kenneth-tochihara/ae484/README.md

# ae484
Overleaf link: https://www.overleaf.com/4984712844kzgqprcwqkpm
