kenneth-tochihara/ae484/homeworks/homework6/report/homework6.tex

\input{settings.tex}
% NOTES
%  - Double spacing (always fix for figures and tables though)
%  - for tables, remember to make them single spaced using \renewcommand{\arraystretch}{1}
%  - Always pull from GitHub to Overleaf when there are commits to be pulled (Menu > GitHub > PULL)
%  - for REFERENCES, use \cite{<label>} to link the reference.

% % TABLE TEMPLATE
% \begin{table}[H]
%     \begin{center}
%     \setstretch{1} 
%     \caption{\textbf{<caption here>}} \label{table:<label here>}
%     \begin{tabular}{|p{0.3in}|p{1in}|p{1in}|} % set column nums and width
%         \hline \textbf{No.} & \textbf{Item} & \textbf{Weight} \\ \hline % column headers
%         1 & Hot dogs & 2 lbs \\ \hline
%     \end{tabular}
%     \end{center}
% \end{table}

\begin{document}

%%% Title Page
\begin{center}
    {\Large\textbf{AE 484 Homework 6}}\\
    Anshuk Chigullapalli, Max Kaiser, George Petrov, Kenneth Tochihara, Jeffery Zhou\\
\end{center}

\section{Design Changes}

    The team considered the changes suggested by Professor Elliott and modified the design of the aircraft accordingly. The primary changes made to the design are listed below and the updated engineering drawings for the aircraft assembly are provided  \href{https://github.com/ktt3/ae484/tree/main/homeworks/homework6/drawing}{here} on our GitHub.
    
    \begin{enumerate}
        \item The winglets in the previous design had a curved merge into the wing. However, this is difficult in terms of manufacturability. The blend is replaced by a hard corner between the wing and the winglet.
        \item For ease of manufacturing, the elevons are extended to the end of the wing rather than being in the middle
        \item A plywood plate is added between the two wings to provide support for all the components and the motor mount.
        \item The spars are reduced in length because the original lengths were too long
        \item Changes to the design of the motor mount
    \end{enumerate}
    
    Another suggestion that was made was to not use a 3D printed motor mount due to potential shear between the layers of the 3D print, making it a bad material choice. The alternative would be an aluminum motor mount. However, the team decided to continue with the 3D printed mount for weight benefits and faster prototyping. If experimental tests conclude that the 3D printed motor mount fails, the switch to a metal motor mount will be made.

\section{Bill of Materials}

    The bill of materials accounts for all components needed to manufacture the aircraft. When calculating the cost for the wings, it was assumed that each wing required one wing core and one balsa sheet to manufacture. Furthermore, the cost of the 3D prints were determined by the cost of the PLA material extruded to manufacture the component. The total cost of the aircraft based on this table is \$319.27.
    
    \begin{table}[H]
    \centering
    \caption{Bill of Materials} \label{tab:bom}
    \begin{tabular}{|p{1.25in}|p{1.25in}|p{2.75in}|p{.75in}|}
    \hline
    \textbf{Item} & \textbf{Vendor} & \textbf{Model and Part \#} & \textbf{Price (\$)} \\
    \hline
    Front Spar & Goodwinds Composites & 0.5" x 24" Pultruded Carbon Tube,PCT500024 & 17.90   \\ \hline
    Back Spar     & Goodwinds& 0.375" x 24" Pultruded Carbon Tube, PCT375024 & 10.23   \\ \hline
    ESC           & Value Hobby & GForce 40A Brushless ESC, VHB-SC-4494 & 10.00 \\ \hline
    Battery       & Value Hobby & GForce 30C 2200mAh 3S 11.1V LiPo, RFI-LP-1899 & 14.90 \\ \hline
    Motor         & Value Hobby & GForce E480 Brushless Outrunner Motor, LEO-MT-3461 & 17.00   \\ \hline
    Propeller     & Horizon Hobby   & 12x6 3-Blade Pusher, MAS3B12X60R01 & 14.65 \\ \hline
    Receiver      & Horizon Hobby   & AR620 DSMX 6-Channel Sport Receiver, SPMAR620 & 49.99 \\ \hline
    Servos        & Value Hobby & Emax ES08MA II Analog Metal Gear Mirco Servo, VHB-SV-6148, Set of 4 & 17.50 \\ \hline
    Wing Cores & MOHR Composite & N/A & 90.00 \\ \hline
    Balsa Sheet & National Balsa & N/A & 18.00 \\ \hline
    Winglets & DragonPlate & 0 Degree Carbon Fiber Uni Sheet 1/8'' x 6'' x 6'', 2 sets & 55.62 \\ \hline
    Hand Holder & Amazon & Plywood Sheet 12'' x 12'' x 1/8 '' & 12.90 \\ \hline
    Motor Mount & 3D Printed & N/A & 0.44 \\ \hline
    Elevon Actuator Holder & 3D Printed  & N/A & 0.04 \\ \hline
    Trap Door     & 3D Printed  & N/A & 0.10    \\ \hline
    \end{tabular}
    \end{table}
    
\section{Manufacturing Files}
    
    The manufacturing files and drawings for the laser cutter, 3D printer, and CNC foam were generated, and are provided \href{https://github.com/ktt3/ae484/tree/main/homeworks/homework6/manufacturing}{here} on our GitHub.

    \begin{table}[]
        \centering
        \caption{Manufactured Parts}
        \begin{tabular}{|c|c|c|c|}
            \hline
            \textbf{Part} & \textbf{Method} & \textbf{File Name} & \textbf{Weight} \\ \hline
            Winglets & Laser Cut & \verb|flat_winglets.pdf| & N/A \\ \hline
            Hand Holder & Laser Cut & \verb|holder_mid.pdf| & N/A \\ \hline
            Motor Mount & 3D Printed & \verb|motor_mount.stl| & 26 g \\ \hline
            Elevon Mount & 3D Printed & \verb|elevon_mount.stl| & 1 g \\ \hline
            Vial Trap Door & 3D Printed & \verb|trap_door.stl| & 5 g \\ \hline
            Main Wing +Z & CNC Foam & \verb|main_wing_+z.stl| & N/A \\ \hline
            Main Wing -Z & CNC Foam & \verb|main_wing_-z.stl| & N/A \\ \hline
        \end{tabular}
    \end{table}

\section{Table of Contributions}

    \begin{table}[H]
        \centering
        \caption{Table of Contributions}
        \label{tab:contributions}
        \begin{tabular}{|c|c|}
            \hline
            \textbf{Team Member} & \textbf{Contributions}  \\ \hline
            Anshuk Chigullapalli & Authored Design Changes, Generated Drawings \\ \hline
            George Petrov & Executed CAD Changes \\ \hline
            Jeffery Zhou & Co-Authored Bill of Materials \\ \hline
            Kenneth Tochihara & Executed CAD Changes, Generated Manufacturing Files and Drawings \\ \hline
            Max Kaiser & Co-Authored Bill of Materials, Generated Manufacturing Files \\ \hline
        \end{tabular}
    \end{table}
    
\end{document}
