kenneth-tochihara/ae484/homeworks/homework3/kenneth/AE 484 HW 3.pdf

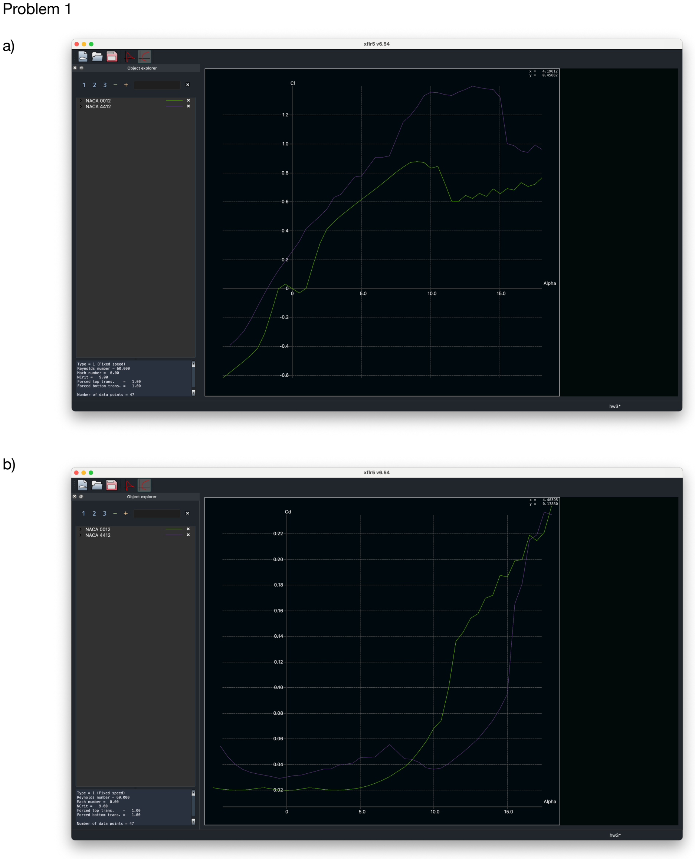
[picture p18: page 1]

Problem 1

a)

b)

c)

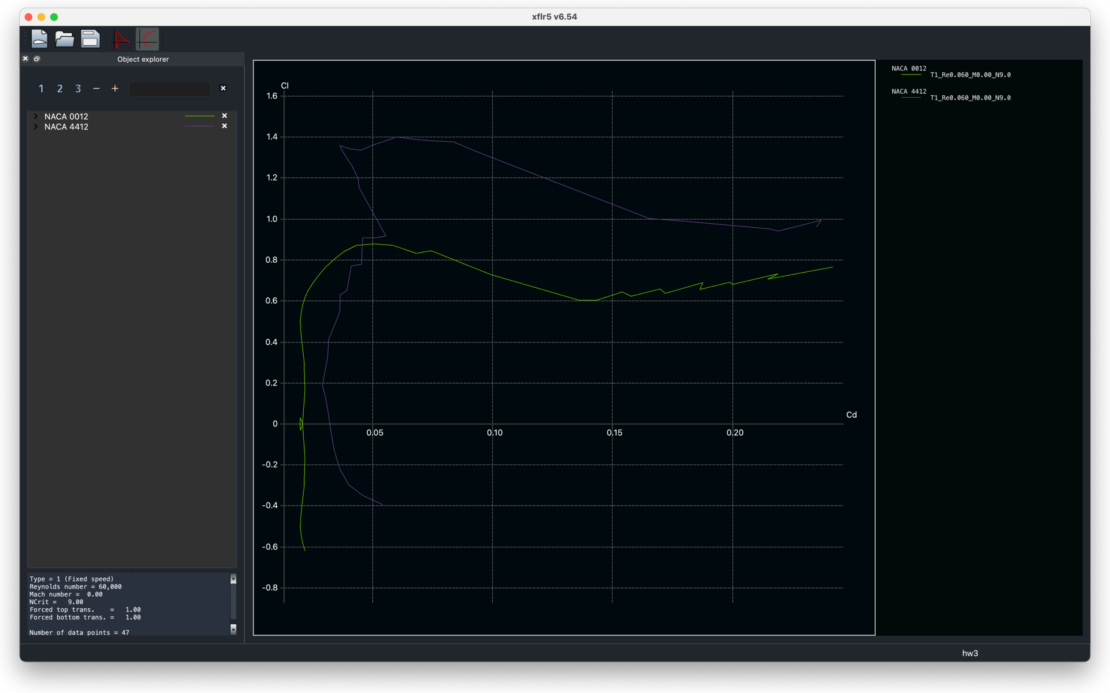
[picture p19: figure]

d) Comparing the two different airfoils, NACA 4412 has more camber than the symmetric NACA 0012. Looking at the Cl vs alpha graph, we can see how the NACA 0012 doesn't generate any lift at 0 degree angle of attack, while the NACA 4412 generates lift. We can all see the stall point delayed with the cambered airfoil and generates more lift with NACA 4412. If cambered is increased, stall is delayed and generates increased lift to a point before other drag affects take over.

Looking further into other properties, we can see that the Cl/Cd is significantly higher as well. This is likely due to the greater pressure differential between the upper and lower boundary of the airfoils. The increased camber generates a increase pressure differential, increasing the lift.

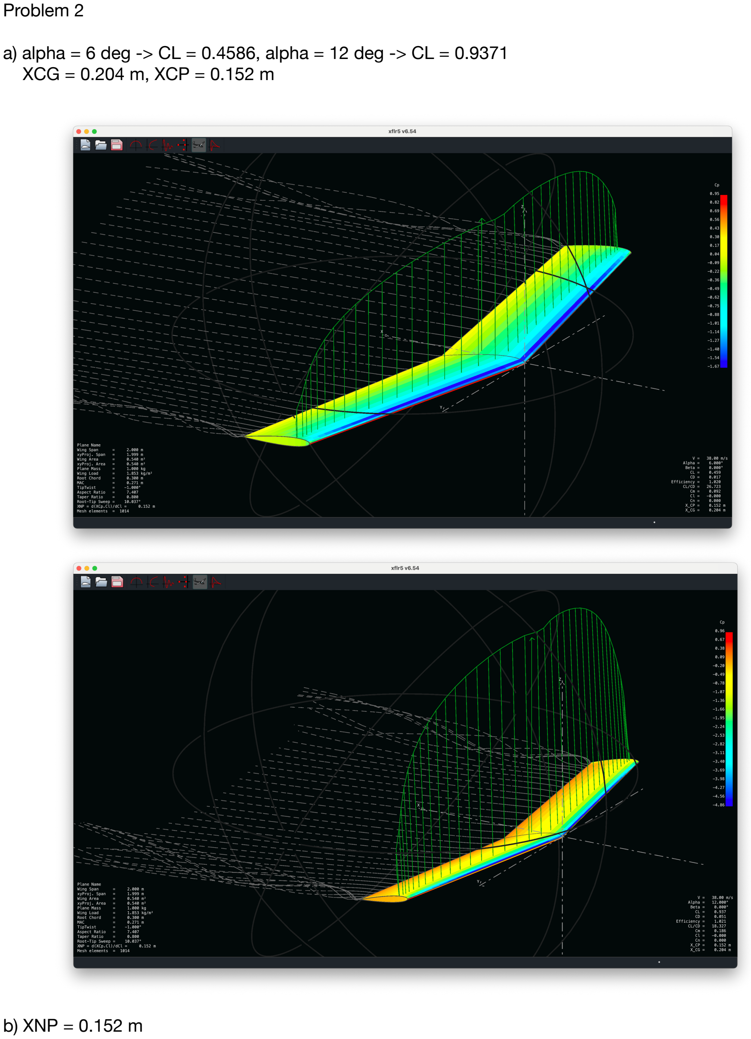
[picture p20: page 3]

a) alpha = 6 deg -> CL = 0.4586, alpha = 12 deg -> CL = 0.9371 XCG = 0.204 m, XCP = 0.152 m
b) XNP = 0.152 m

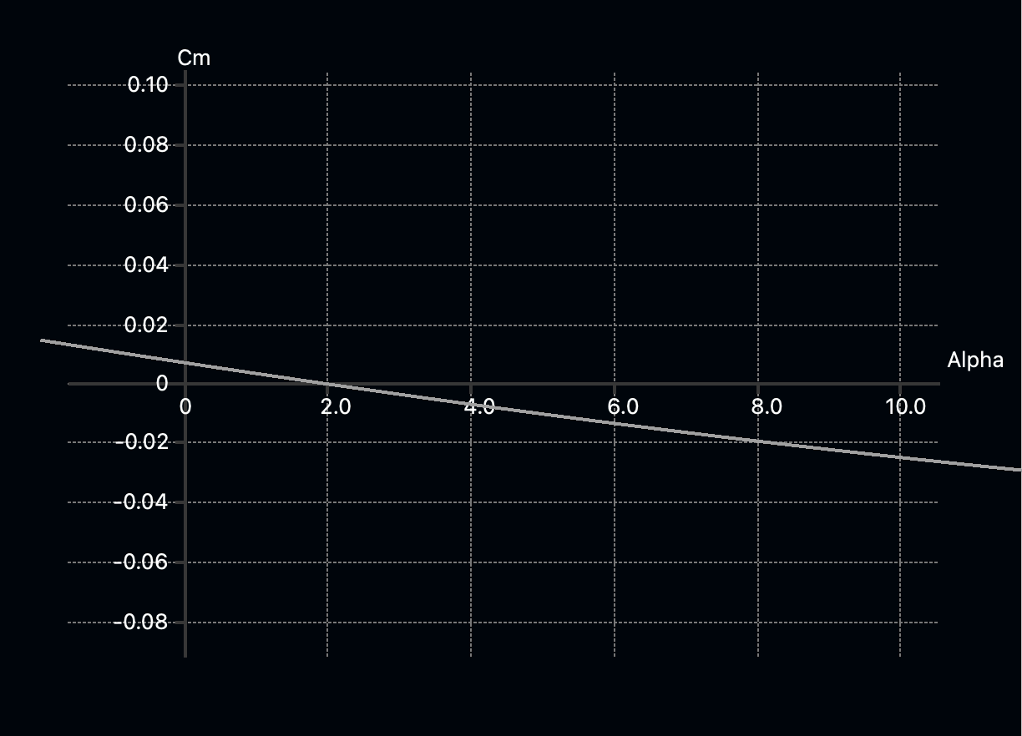
[picture p21: figure]

a) The slope is negative. The trim angle is roughly an angle of attack of 2 deg.
