kenneth-tochihara/ae484/homeworks/homework3/george/report/report.tex

\input{settings}

\title{AE484 Assignment 3}
\author{George Petrov}
\date{February 21, 2022}

\begin{document}

\maketitle
\begin{singlespace}
\section{Symmetric and Cambered Airfoil Analysis}
\textbf{Note:} I have exported all of the polar's data from XLR5 then made python script to plot this data. All of the code will be attached at the bottom of the homework.
\subsection{Part (a)}
Plot of the coefficient of lift across different angles of attack can be seen below. The NACA 0012 airfoil is in blue and the NACA 4412 is in red.
\begin{figure}[H]
        \centering
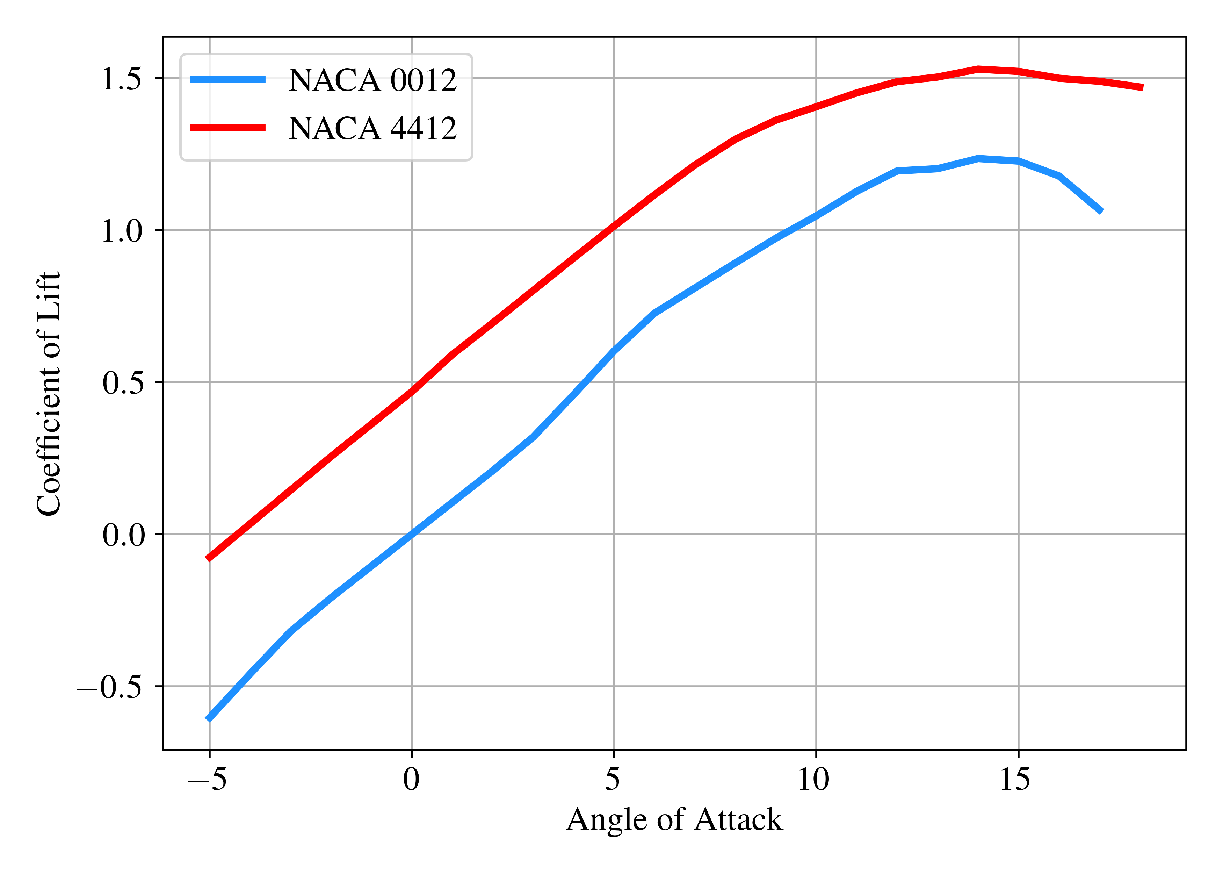
[picture p22: homeworks/homework3/george/plots/problem1_a.png]
        
        \caption{\textbf{$C_l$ vs. $\alpha$}}
        \label{fig:1a}
\end{figure}
\subsection{Part (b)}
Plot of the coefficient of drag across different angles of attack can be seen below.
\begin{figure}[H]
        \centering
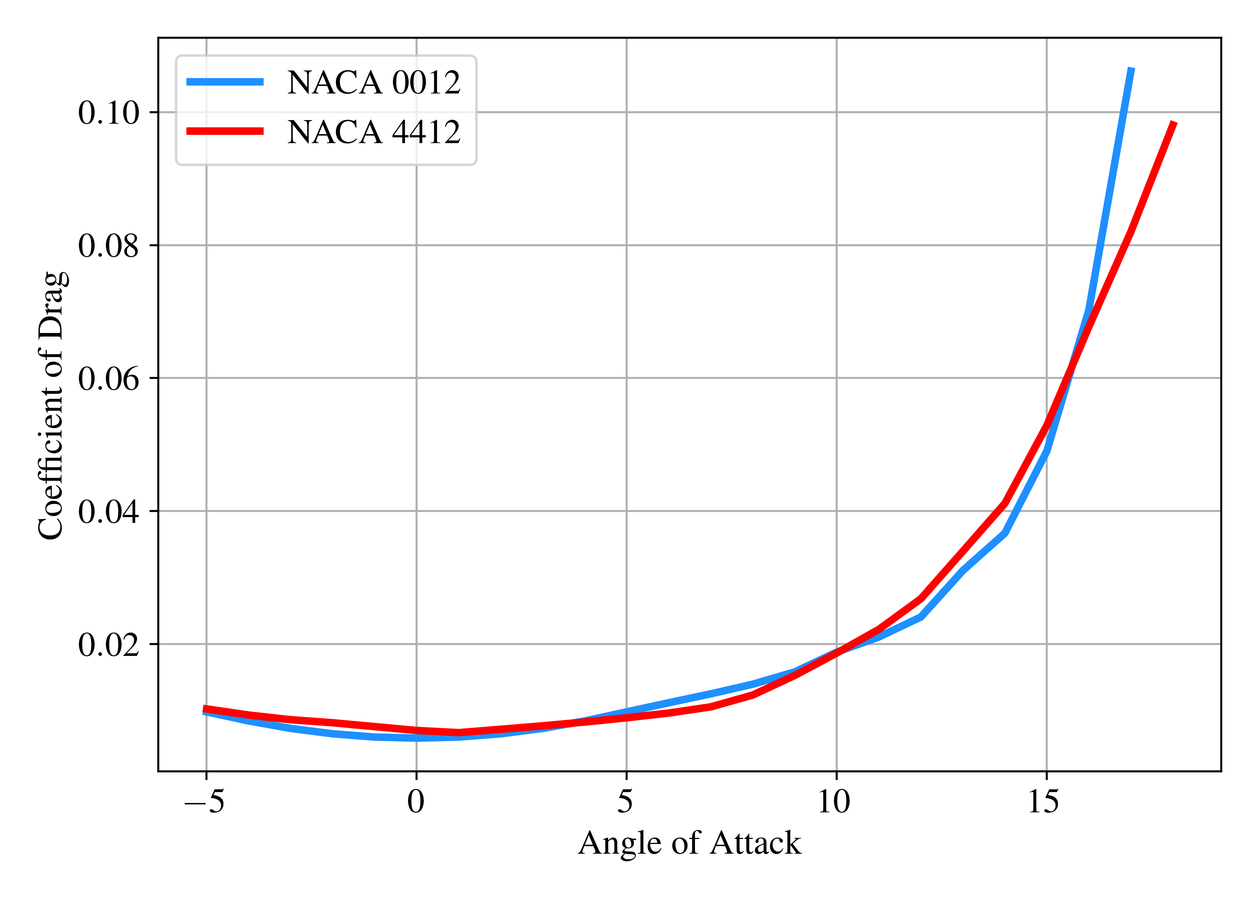
[picture p23: homeworks/homework3/george/plots/problem1_b.png]
        
        \caption{\textbf{$C_d$ vs. $\alpha$}}
        \label{fig:1b}
\end{figure}
\subsection{Part (c)}
Plot of the coefficient of lift vs. coefficient of drag can be seen below.
\begin{figure}[H]
        \centering
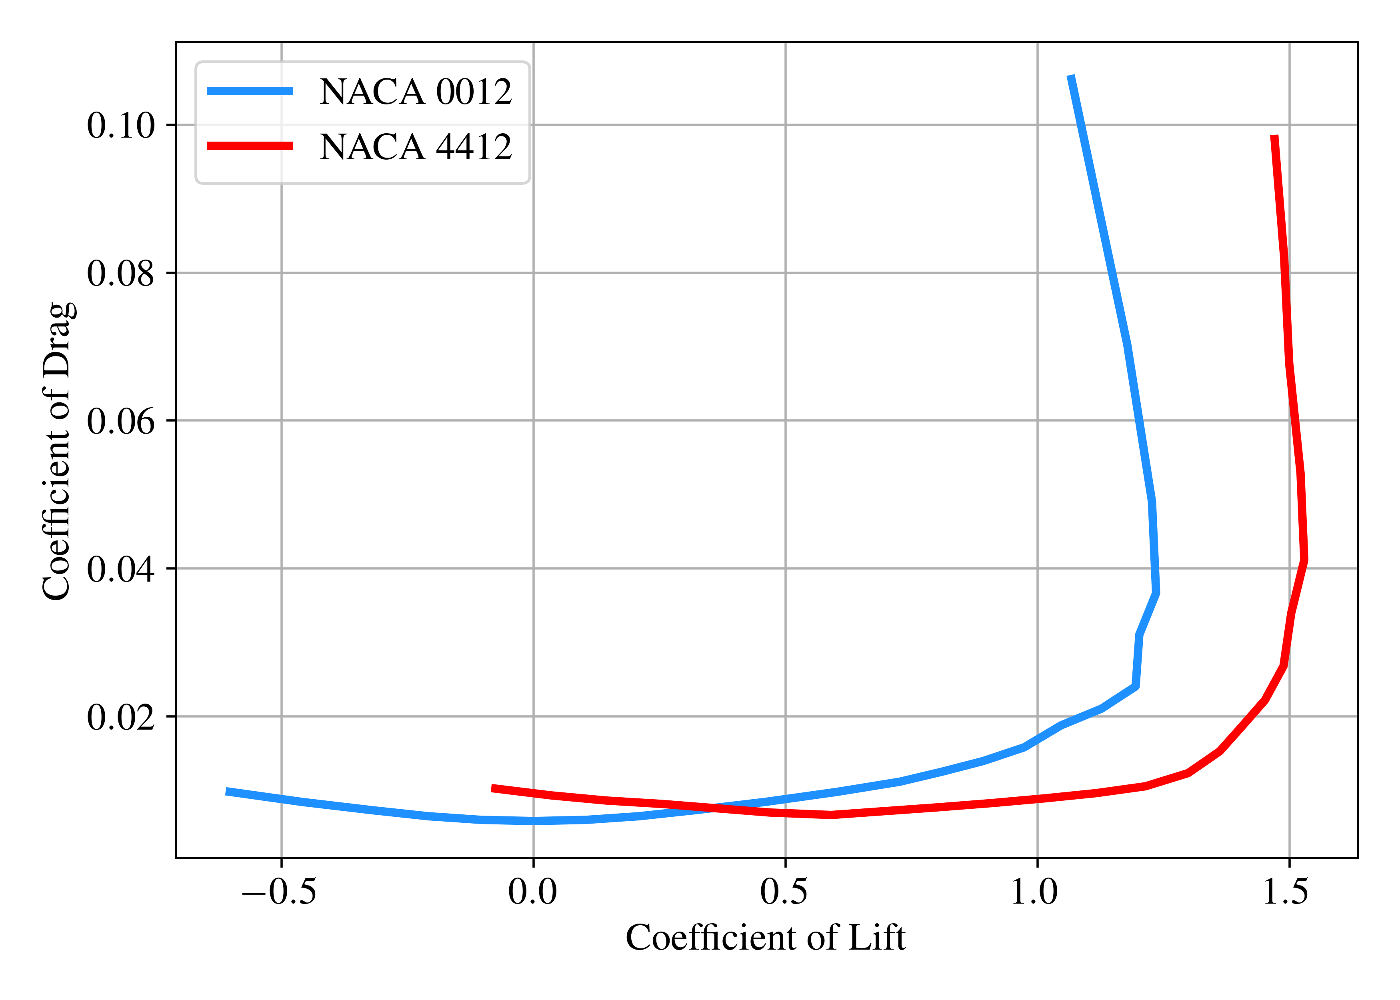
[picture p24: homeworks/homework3/george/plots/problem1_c.png]
        
        \caption{\textbf{$C_l$ vs. $C_d$}}
        \label{fig:1c}
\end{figure}
\subsection{Part (d)}
The different between the NACA 0012 and 4412 is their camber. The 0012 being a symmetric airfoil, while the 4412 being decently cambered. 

The difference can be seen in the Figure \ref{fig:1a}. In this plot, the symmetric airfoil only starts to create lift after the angle of attack is above 0 degrees. While the cambered airfoil creates lift at around -4 degrees. What is also interesting is that they still both stall at around the same angle of attack of 15 degrees. The lift coefficient of the 4412 is always much larger no matter the angle of attack which is expected due to its cambered nature. 

In Figure \ref{fig:1b}, we can see that their drag coefficients are largely the same no matter what the angle of attack is. At the end, the start to separate slightly where the 0012 has slightly larger drag.
For the plot of the coefficient of lift vs coefficient of drag plot, figure \ref{fig:1c}, we can see that the 4412 cambered airfoil is significantly more efficient in creating lift while keeping a similar drag profile to the 0012. 

A cambered wing offers more lift for no loss of drag. Yet, the NACA 0012 is still used in a number of tail stabilizers since it is symmetric.
\section{Finite Wing Analysis}
\subsection{Part (a)}
\subsubsection{i.}
The wings coefficient of lift at 6 and 12 degrees can be seen in the Table \ref{table:2ai} below.

    \begin{table}[H]
    \centering
    \caption{\textbf{$C_L$ at 6$\degree$ and 12$\degree$}} \label{table:2ai}
        \begin{tabular}{|c|c|c|c|c|} % set column nums and width
            \hline \textbf{Angle of Attack ($\alpha$)} & \textbf{Coefficient of Lift ($C_L$)} \\ \hline % column headers
            6$\degree$ & 0.449725 \\ \hline
           12$\degree$ & 0.941413 \\ \hline
        \end{tabular}
        \label{table:2ai}
    \end{table}

\subsubsection{ii.}
Below are sceenshots of the finite wing model with the coefficient of pressure contour, the lift generation, and the streamlines of the flow are shown at both an angle of attack of 6 and 12 degrees.
\begin{figure}[H]
        \centering
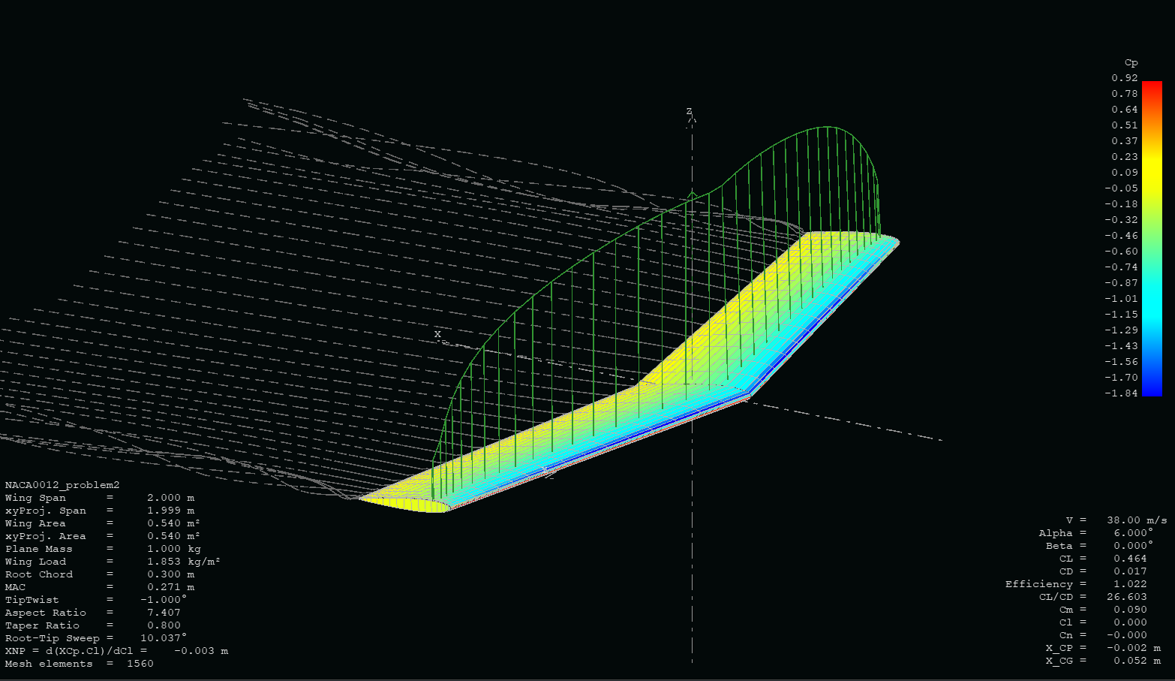
[picture p25: homeworks/homework3/george/plots/problem2_b_6.PNG]
        
        \caption{\textbf{Contour $C_p$ mapping, $C_L$, and Streamlines at 6$\degree$}}
        \label{fig:2bii6}
\end{figure}
\begin{figure}[H]
        \centering
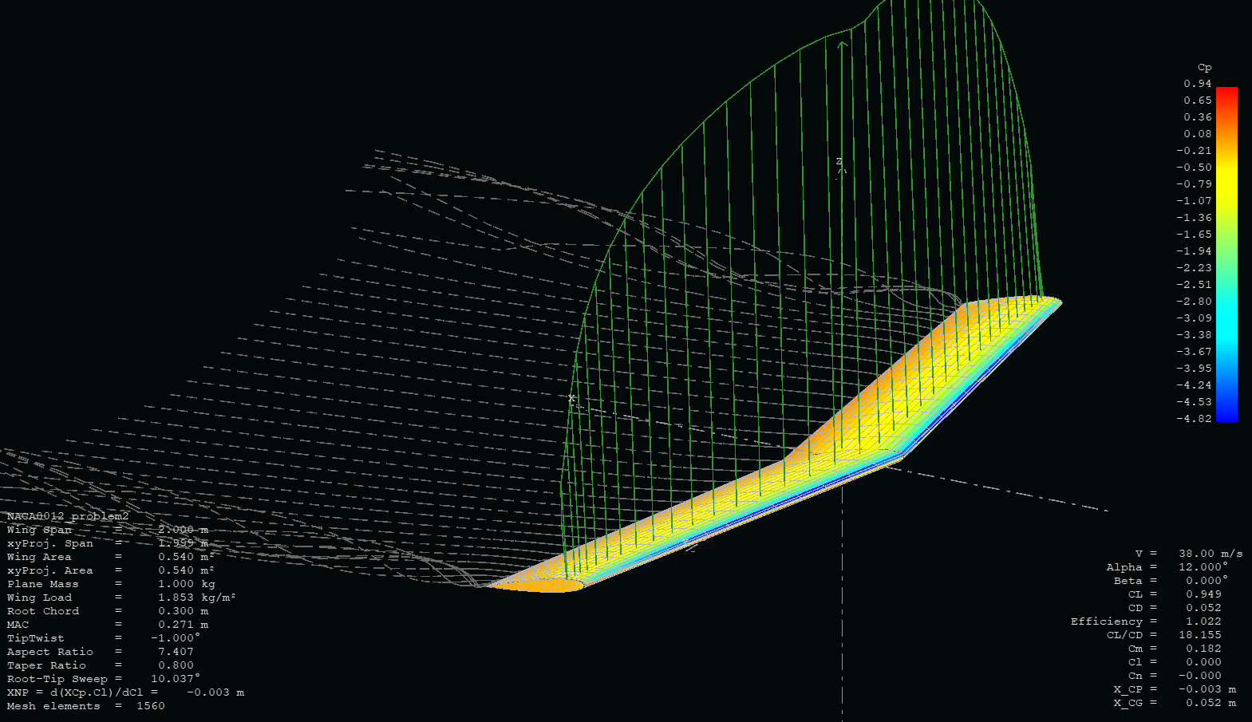
[picture p26: homeworks/homework3/george/plots/problem2_b_12.PNG]
        
        \caption{\textbf{$C_p$ Contour , Lift, and Streamlines at 12$\degree$}}
        \label{fig:2bii12}
\end{figure}
\subsubsection{iii.}
Below, in Table \ref{table:2aiii}, the location of the coefficient of pressure load point and location of the center of gravity is shown for the angles of attack of 6 and 12 degrees. These distances are referenced from the tip of the wing.
\begin{table}[H]
    \begin{center}
        \caption{\textbf{$X_{cp} $ and $X_{cg}$ at 6$\degree$ and 12$\degree$}} \label{table:2aiii}
        \begin{tabular}{|c|c|c|c|c|} % set column nums and width
            \hline \textbf{Angle of Attack ($\alpha$)} & \textbf{$X_{cp}$} & \textbf{$X_{cg}$} \\ \hline % column headers
            6$\degree$ & 0.154 m & .204 m \\ \hline
           12$\degree$ & 0.152 m & .204 m \\ \hline
        \end{tabular}
\end{center}
\end{table}
\subsection{Part (b)}
The neutral point for the wing is found to be \textbf{0.152 m} from the front of the wing.

\section{Flying Wing Analysis}
\subsection{Part (a)}
\subsubsection{i.}
In order to observe whether the slope of the coefficient of moment vs angle of attack is positive or negative, it was plotted.

\begin{figure}[H]
        \centering
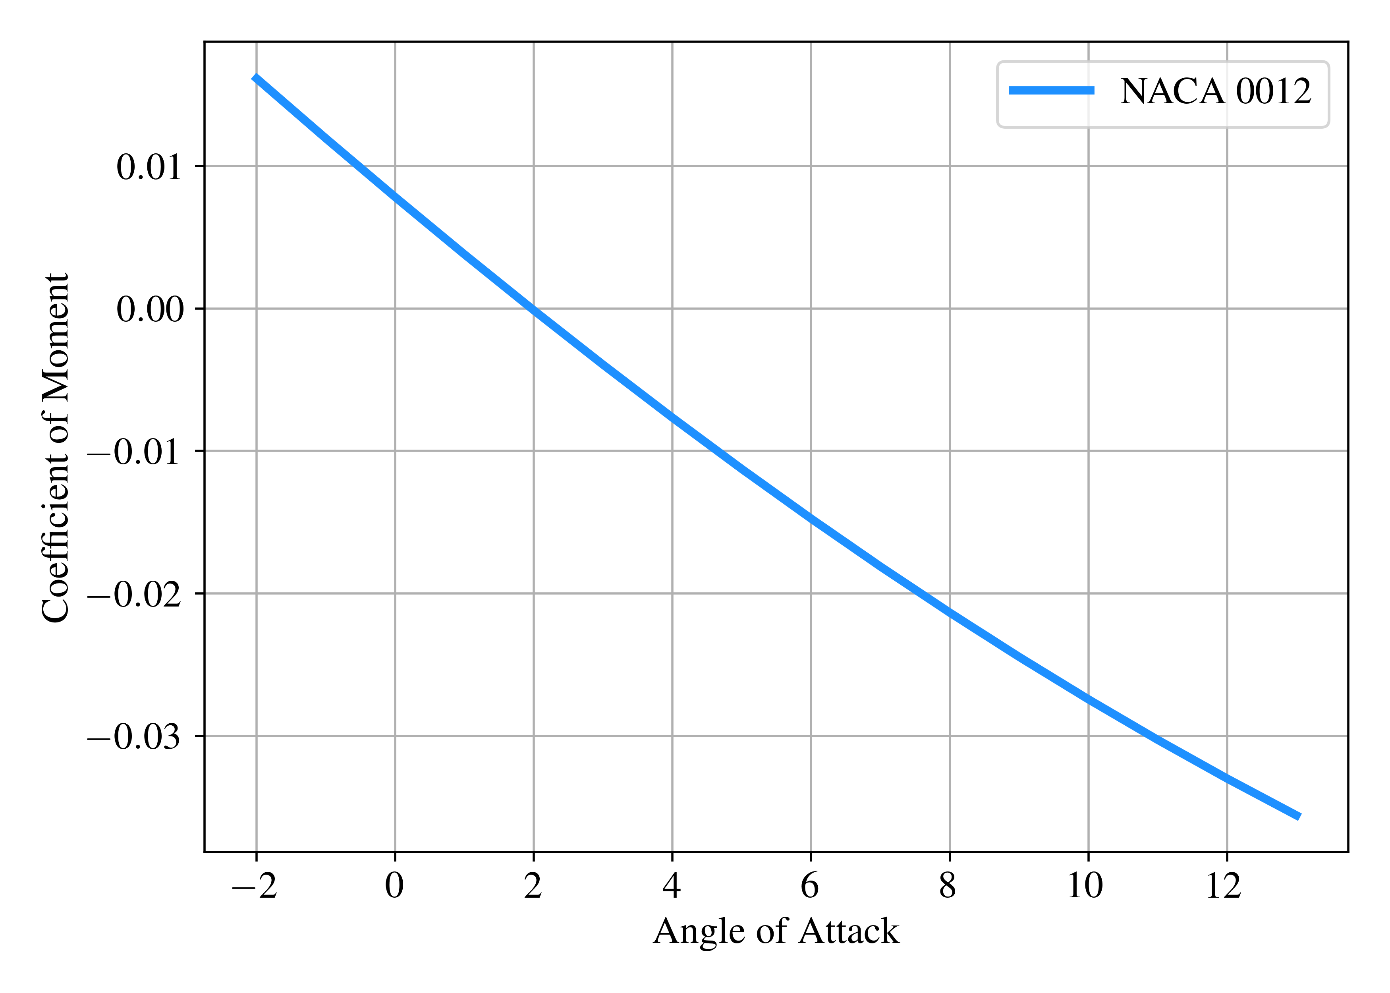
[picture p27: homeworks/homework3/george/plots/problem3_ai.png]
        
        \caption{\textbf{$C_m$ vs. $\alpha$}}
        \label{fig:3ai}
\end{figure}
As we can see above in Figure \ref{fig:3ai}, the slope is slightly negative.
\subsubsection{ii.}
The location where the coefficient of moment is zero is at \textbf{2 degrees} of angle of attack. 

\newpage
\section{\textbf{Raw Data}}
\begin{table}[H]
\caption{\textbf{NACA0012 Airfoil Data}} \label{table:NACA0012_raw}
\begin{tabular}{|l|l|l|l|l|l|l|l|l|l|}
alpha & CL      & CD      & CDp     & Cm      & Top Xtr & Bot Xtr & Cpmin   & Chinge & XCp    \\
-5    & -0.6028 & 0.00981 & 0.00382 & 0.0075  & 0.9939  & 0.1693  & -2.0439 & 0      & 0.2565 \\
-4    & -0.459  & 0.00844 & 0.00305 & -0.0002 & 0.9817  & 0.2999  & -1.486  & 0      & 0.2442 \\
-3    & -0.3196 & 0.00732 & 0.00245 & -0.0062 & 0.9636  & 0.4336  & -1.0483 & 0      & 0.2253 \\
-2    & -0.209  & 0.00651 & 0.00203 & -0.0052 & 0.9202  & 0.5514  & -0.757  & 0      & 0.22   \\
-1    & -0.1046 & 0.00602 & 0.00175 & -0.0026 & 0.8532  & 0.6614  & -0.5548 & 0      & 0.2204 \\
0     & 0       & 0.00586 & 0.00167 & 0       & 0.765   & 0.765   & -0.4147 & 0      & 0.448  \\
1     & 0.1046  & 0.00602 & 0.00175 & 0.0026  & 0.6614  & 0.8532  & -0.5548 & 0      & 0.2204 \\
2     & 0.209   & 0.00651 & 0.00203 & 0.0052  & 0.5514  & 0.9202  & -0.757  & 0      & 0.22   \\
3     & 0.3196  & 0.00732 & 0.00245 & 0.0062  & 0.4336  & 0.9636  & -1.0483 & 0      & 0.2253 \\
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
\end{tabular}
\end{sidewaystable}
\newpage
\section{\textbf{Code}}
    \lstinputlisting[language=python, caption=\bfseries code.py, label=lst:code]{homeworks/homework3/george/code/code.py}
\end{singlespace}
\end{document}
