kenneth-tochihara/ae484/homeworks/homework2/anshuk/HW2_Camera_Render.png

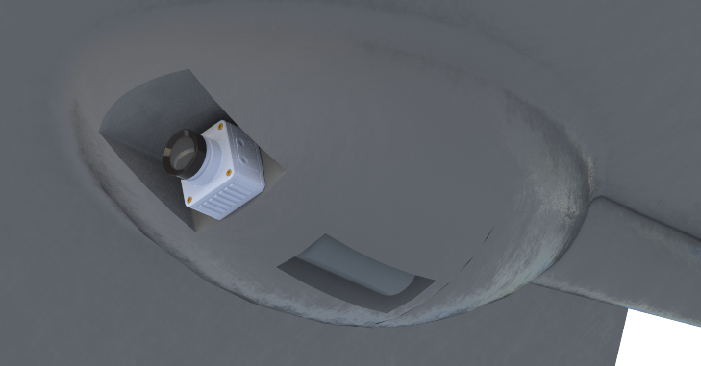
homeworks/homework2/anshuk/HW2_Camera_Render.png
