kenneth-tochihara/ae484/homeworks/homework2/anshuk/HW2_IsoView.png

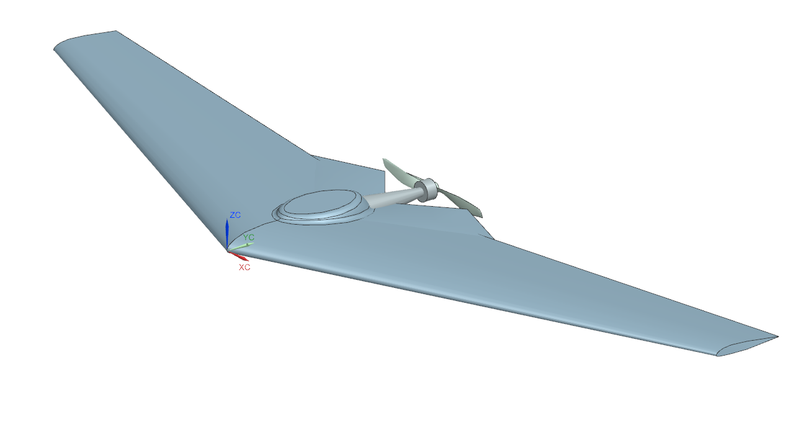
homeworks/homework2/anshuk/HW2_IsoView.png
