kenneth-tochihara/ae484/homeworks/homework2/anshuk/HW2_Top_Render.png

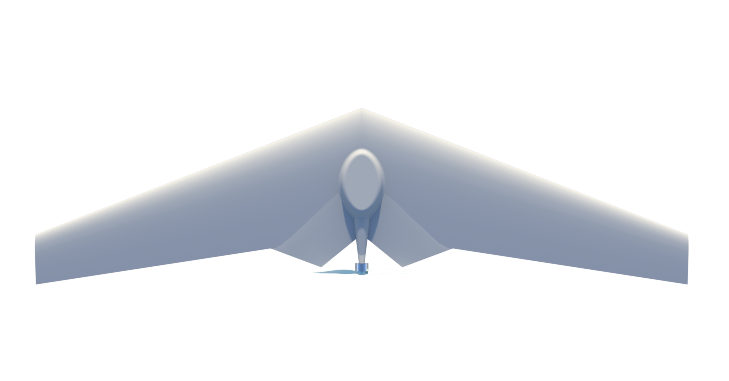
homeworks/homework2/anshuk/HW2_Top_Render.png
