kenneth-tochihara/ae484/homeworks/homework6/cad/exploded.png

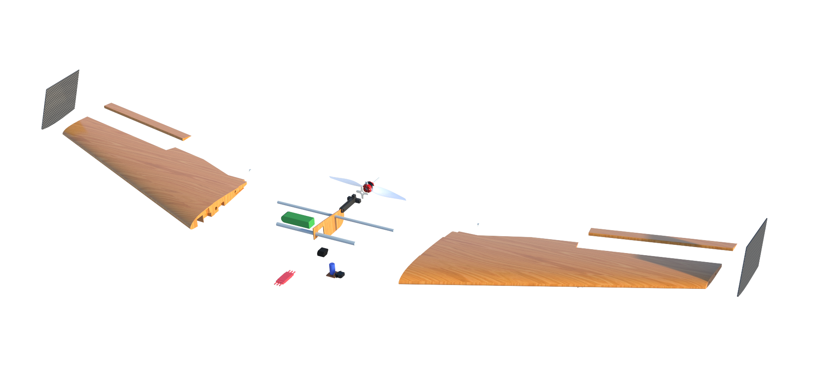
homeworks/homework6/cad/exploded.png
