kenneth-tochihara/ae484/homeworks/homework6/cad/motor/Turnigy Motor 1.JPG

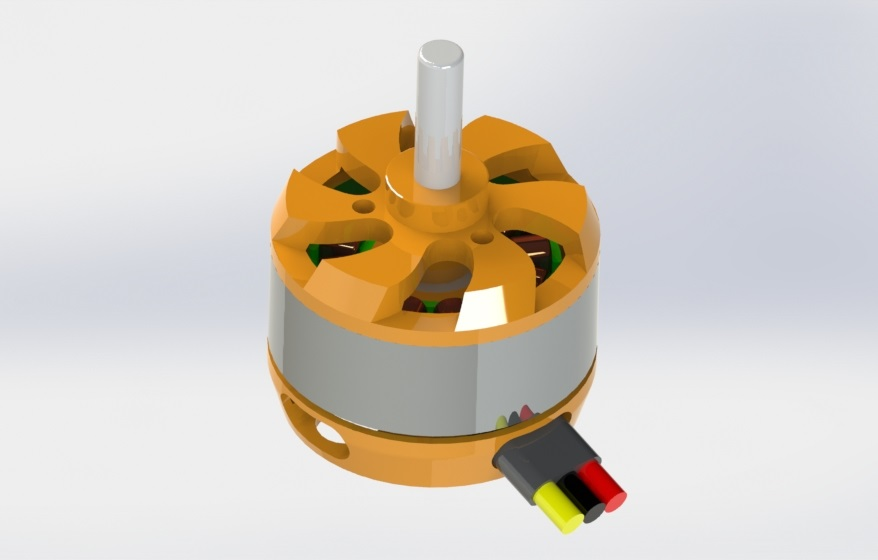
homeworks/homework6/cad/motor/Turnigy Motor 1.JPG
