kenneth-tochihara/ae484/homeworks/homework6/cad/underview.png

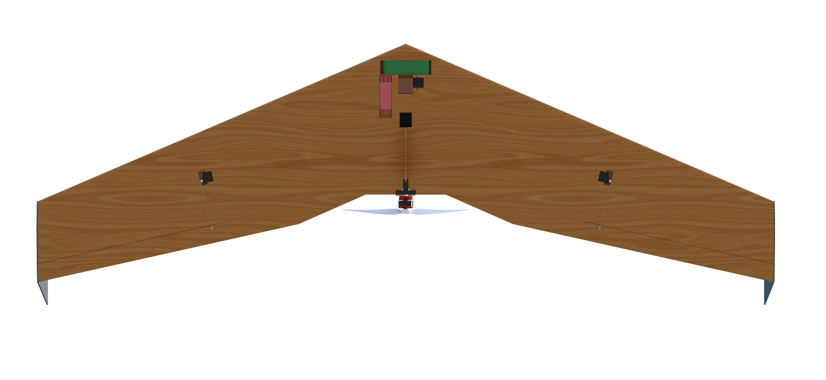
homeworks/homework6/cad/underview.png
