kenneth-tochihara/ae484/homeworks/homework6/manufacturing/main_wing_+z.stl

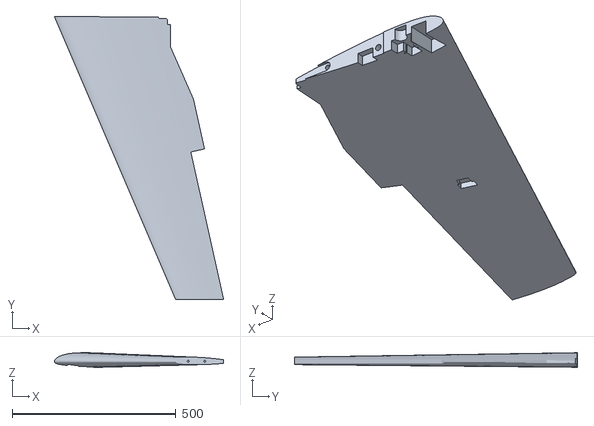
[picture p34: CAD file, 2022-04-05]
homeworks/homework6/manufacturing/main_wing_+z.stl
516.9 x 863.6 x 44.6
