kenneth-tochihara/ae484/homeworks/homework6/cad/elevon_actuators/Connector_short.SLDPRT

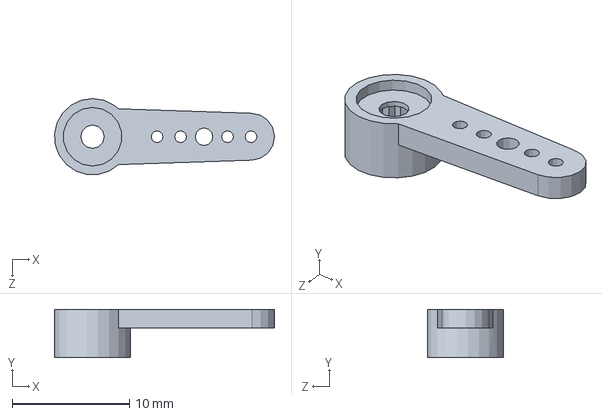
[picture p35: CAD file, 2022-03-02]
homeworks/homework6/cad/elevon_actuators/Connector_short.SLDPRT
18.7 x 4.10 x 6.46 mm
