kenneth-tochihara/ae484/homeworks/homework6/cad/motor/Turnigy Motor.STEP

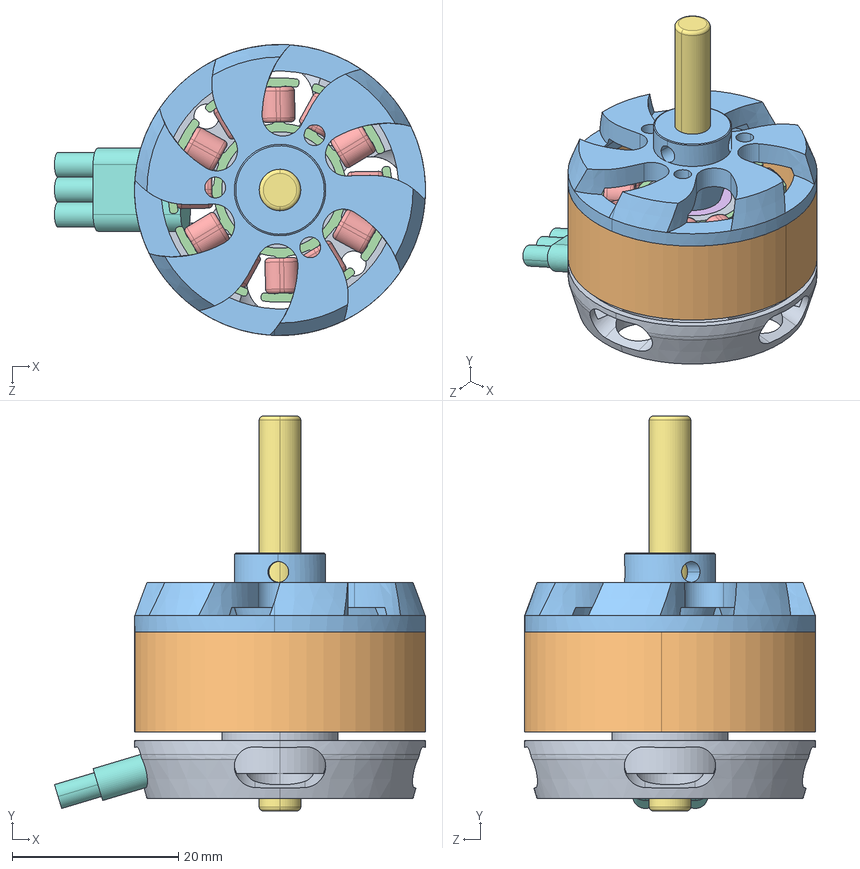
[picture p36: CAD file, 2022-02-26]
homeworks/homework6/cad/motor/Turnigy Motor.STEP
44.6 x 47.5 x 35.0 mm
Bottom Shell
Middle Shell
Top Shell
Inner Coil Rack
Coil x 12
Inner Bearing
Shaft
Wires
