kenneth-tochihara/ae484/homeworks/homework6/manufacturing/flat_winglets_+z_.stl

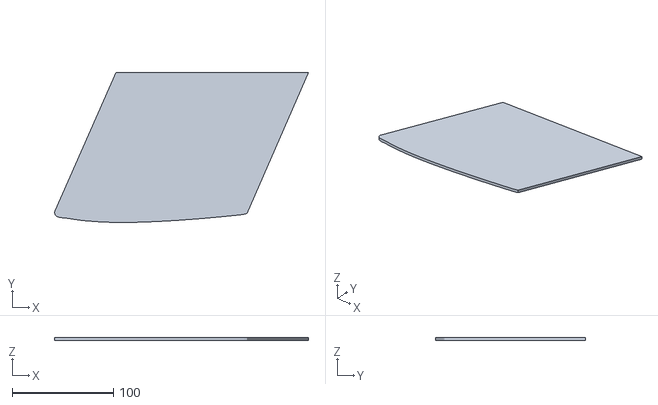
[picture p37: CAD file, 2022-05-03]
homeworks/homework6/manufacturing/flat_winglets_+z_.stl
251.3 x 148.3 x 3.18
