kenneth-tochihara/ae484/homeworks/homework6/manufacturing/motor_mount.stl

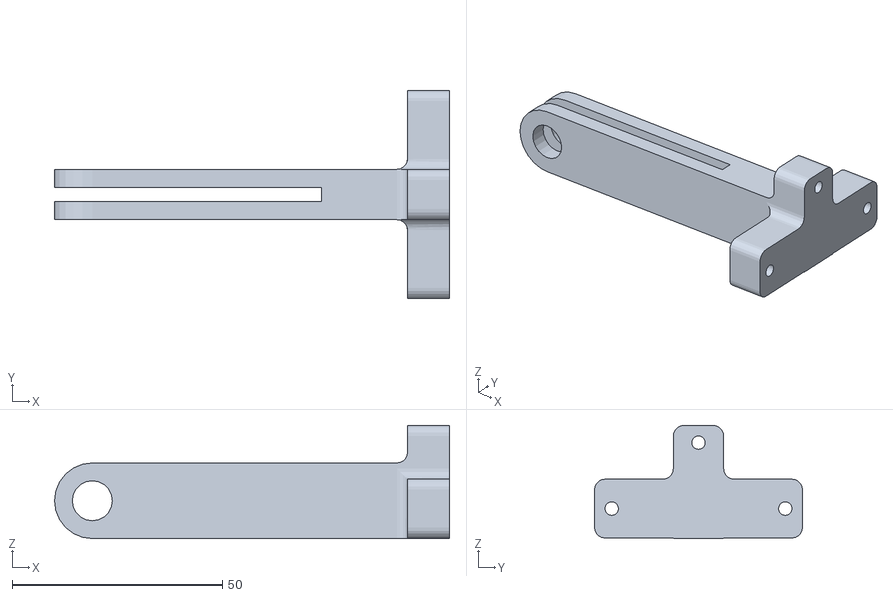
[picture p38: CAD file, 2022-04-05]
homeworks/homework6/manufacturing/motor_mount.stl
94.0 x 49.5 x 26.9
