kenneth-tochihara/ae484/homeworks/homework6/manufacturing/elevon_mount.stl

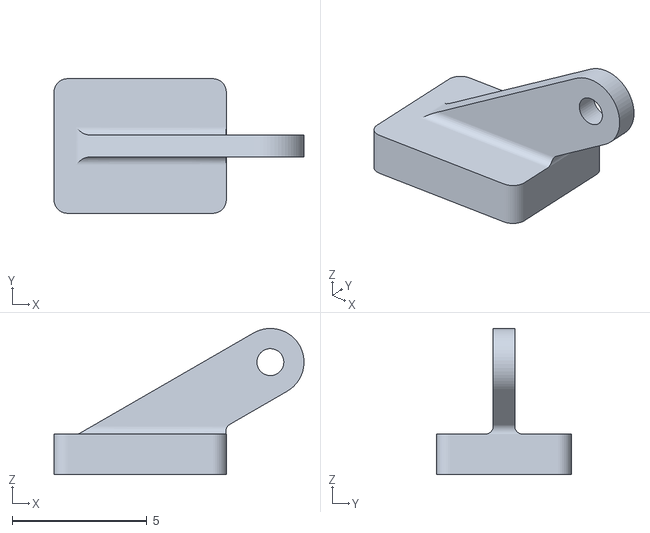
[picture p39: CAD file, 2022-04-05]
homeworks/homework6/manufacturing/elevon_mount.stl
9.28 x 5.00 x 5.43
