kenneth-tochihara/ae484/homeworks/homework6/manufacturing/trap_door.stl

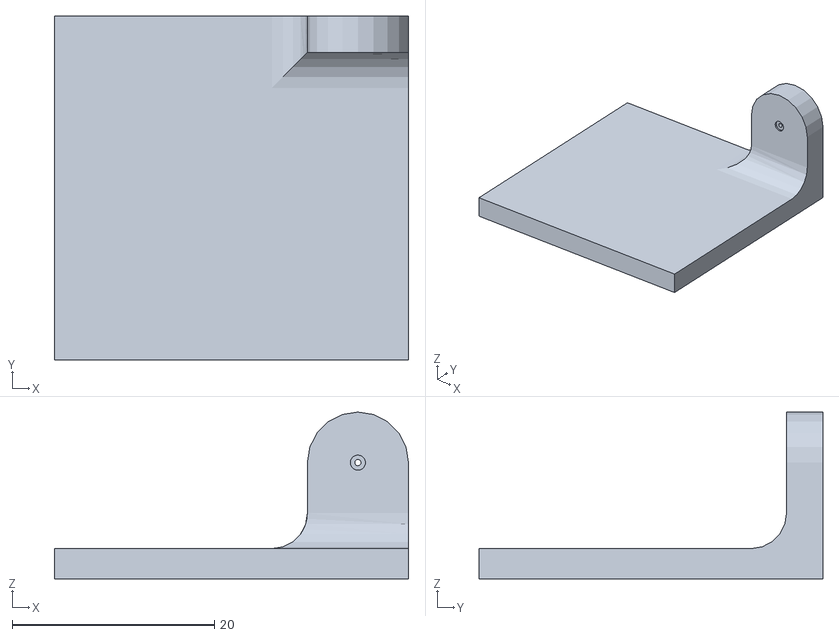
[picture p40: CAD file, 2022-04-05]
homeworks/homework6/manufacturing/trap_door.stl
35.0 x 34.0 x 16.5
