kenneth-tochihara/ae484/(list of files, cad)

Other CAD files:
homeworks/homework2/anshuk/full_assembly.prt
homeworks/homework2/anshuk/main_body.prt
homeworks/homework2/anshuk/motor.prt
homeworks/homework2/anshuk/motor_assembly.prt
homeworks/homework2/anshuk/payload.prt
homeworks/homework2/george/CAD/vehicle_concept_george.prt
homeworks/homework2/george/CAD/vehicle_concept_george_2.prt
homeworks/homework2/george/CAD/vehicle_concept_george_assy.prt
homeworks/homework2/george/CAD/vehicle_concept_george_controlsurfaces.prt
homeworks/homework2/george/CAD/vehicle_concept_george_controlsurfaces2.prt
homeworks/homework2/george/CAD/vehicle_concept_george_props.prt
homeworks/homework2/george/CAD/vehicle_concept_george_wings.prt
homeworks/homework2/kenneth/4mm shaft spinner_id31_step.prt
homeworks/homework2/kenneth/APC 12x6 EP Prop_sldprt.prt
homeworks/homework2/kenneth/CirPattern2_sldprt.prt
homeworks/homework2/kenneth/Cut-Revolve1_sldprt.prt
homeworks/homework2/kenneth/E-Flite Park 480.prt
homeworks/homework2/kenneth/E-Flite Park 480_id91_step.prt
homeworks/homework2/kenneth/Surface-Fill3_sldprt.prt
homeworks/homework2/kenneth/aircraft.prt
homeworks/homework2/kenneth/fuselage.prt
homeworks/homework2/kenneth/vertical_stabilizer.prt
homeworks/homework2/kenneth/wing.prt
homeworks/homework6/cad/Emax ES08A_sldprt.prt
homeworks/homework6/cad/GForce_Brushless_ESC.prt
homeworks/homework6/cad/LiPo_battery.prt
homeworks/homework6/cad/Vial Assembly/assembly_vial_door.prt
homeworks/homework6/cad/Vial Assembly/trap_door.prt
homeworks/homework6/cad/aircraft_assembly.prt
homeworks/homework6/cad/aircraft_assembly_component_locations.prt
homeworks/homework6/cad/elevon_actuators/Connector_short_sldprt.prt
homeworks/homework6/cad/elevon_actuators/Emax ES08A_sldprt.prt
homeworks/homework6/cad/elevon_actuators/aircraft_assembly_manufacturing.prt
homeworks/homework6/cad/elevon_actuators/elecon_holder_left.prt
homeworks/homework6/cad/elevon_actuators/elevon_bar.prt
homeworks/homework6/cad/elevon_actuators/elevon_holder_left.prt
homeworks/homework6/cad/elevon_actuators/elevon_holder_right.prt
homeworks/homework6/cad/elevon_actuators/elevon_left.prt
homeworks/homework6/cad/elevon_actuators/elevon_refernce.prt
homeworks/homework6/cad/elevon_actuators/elevon_right.prt
homeworks/homework6/cad/elevon_actuators/spar_24in.prt
homeworks/homework6/cad/elevon_actuators/spar_36in.prt
homeworks/homework6/cad/hand_holders.prt
homeworks/homework6/cad/motor/Bottom Shell.prt
homeworks/homework6/cad/motor/Coil.prt
homeworks/homework6/cad/motor/Inner Bearing.prt
homeworks/homework6/cad/motor/Inner Coil Rack.prt
homeworks/homework6/cad/motor/Middle Shell.prt
homeworks/homework6/cad/motor/Park 480 Mount_id47_step.prt
homeworks/homework6/cad/motor/Shaft.prt
homeworks/homework6/cad/motor/Top Shell.prt
homeworks/homework6/cad/motor/Turnigy Motor_step.prt
homeworks/homework6/cad/motor/Wires.prt
homeworks/homework6/cad/motor/countersunk flat head cross recess screw_din_ISO 7046-1 - M3 x 6 - Z --- 6N_id63_step.prt
homeworks/homework6/cad/motor/propeller/CirPattern2_sldprt.prt
homeworks/homework6/cad/motor/propeller/Cut-Revolve1_sldprt.prt
homeworks/homework6/cad/motor/propeller/Surface-Fill3_sldprt.prt
homeworks/homework6/cad/motor/propeller/propeller.prt
homeworks/homework6/cad/payload_vial.prt
homeworks/homework6/cad/spar motor connector/spar_motor_connecter.prt
homeworks/homework6/cad/spektrum_ar620_reciever.prt
homeworks/homework6/cad/wing/elevon_+z.prt
homeworks/homework6/cad/wing/elevon_-z.prt
homeworks/homework6/cad/wing/flat_winglets_+z_.prt
homeworks/homework6/cad/wing/flat_winglets_-z.prt
homeworks/homework6/cad/wing/holder_mid_.prt
homeworks/homework6/cad/wing/main_wing.prt
homeworks/homework6/cad/wing/main_wing_+z.prt
homeworks/homework6/cad/wing/main_wing_-z.prt
homeworks/homework6/cad/wing/wing.prt
homeworks/homework6/cad/wing/winglets_+z.prt
homeworks/homework6/cad/wing/winglets_-z.prt
homeworks/homework6/cad/winglet_dowel.prt
homeworks/homework6/manufacturing/flat_winglets_-z.stl
homeworks/homework6/manufacturing/main_wing_-z.stl
