kenneth-tochihara/ae484/homeworks/homework6/manufacturing/holder_mid.pdf

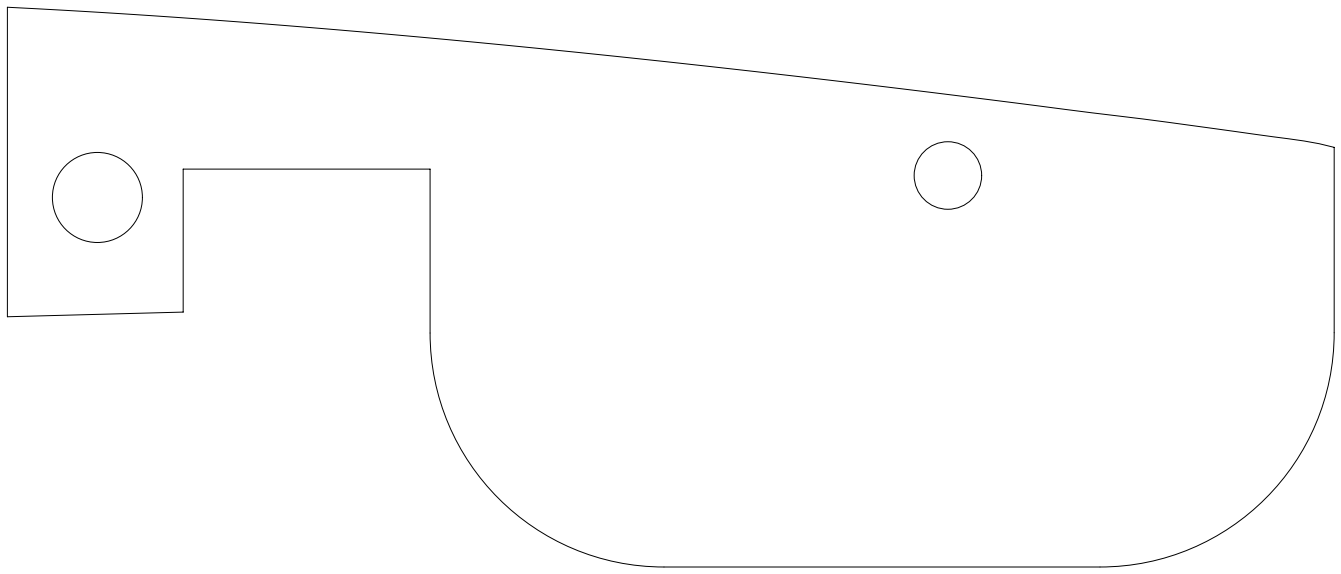
[picture p41: figure]
