kenneth-tochihara/ae484/homeworks/homework4/report/Figure/aircraft_assembly.png

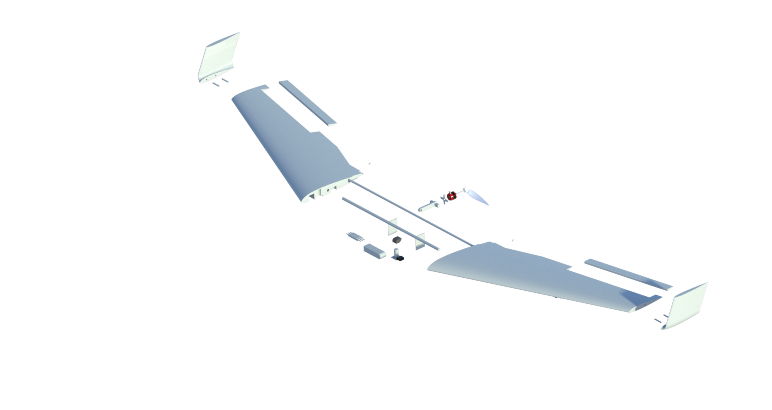
homeworks/homework4/report/Figure/aircraft_assembly.png
