kenneth-tochihara/ae484/homeworks/homework4/report/Figure/aircraft_assembly_1.png

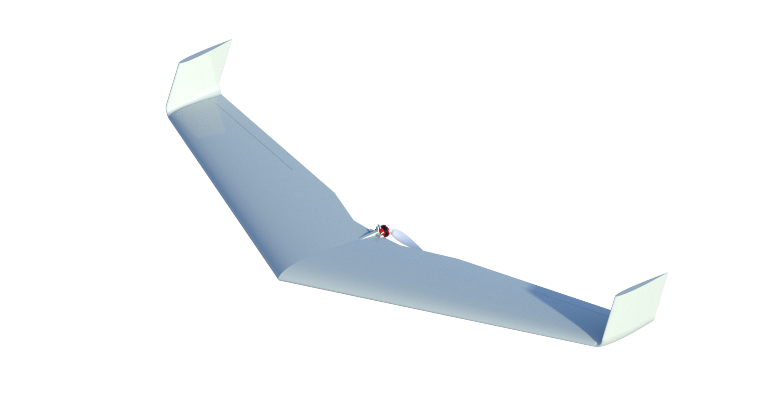
homeworks/homework4/report/Figure/aircraft_assembly_1.png
