kenneth-tochihara/ae484/homeworks/homework4/report/Figure/aircraft_assembly_component_locations.tif

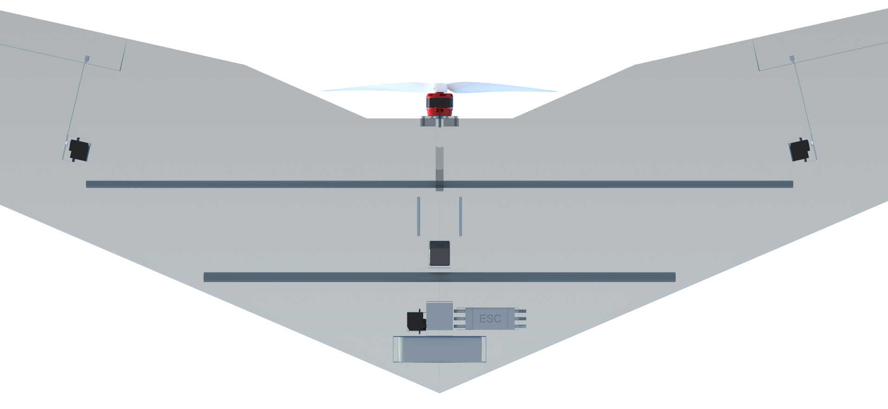
homeworks/homework4/report/Figure/aircraft_assembly_component_locations.tif
