kenneth-tochihara/ae484/homeworks/homework4/report/Figure/aircraft_assembly_underbelly.png

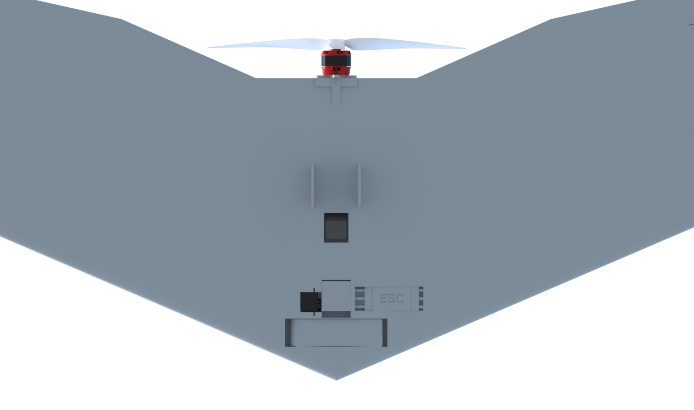
homeworks/homework4/report/Figure/aircraft_assembly_underbelly.png
