kenneth-tochihara/ae484/homeworks/homework4/report/Figure/aircraft_assembly_underbelly.tif

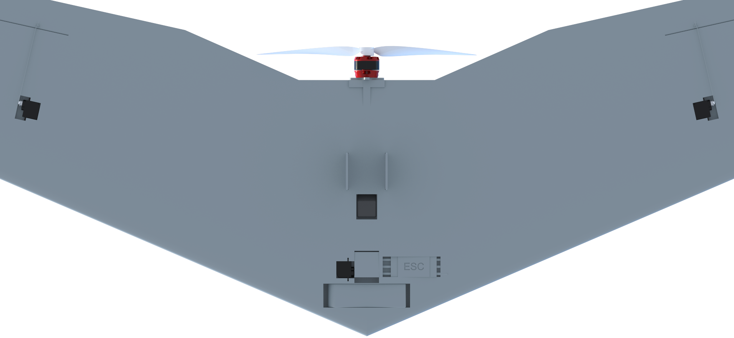
homeworks/homework4/report/Figure/aircraft_assembly_underbelly.tif
