kenneth-tochihara/ae484/homeworks/homework6/cad/aircraft_assembly.png

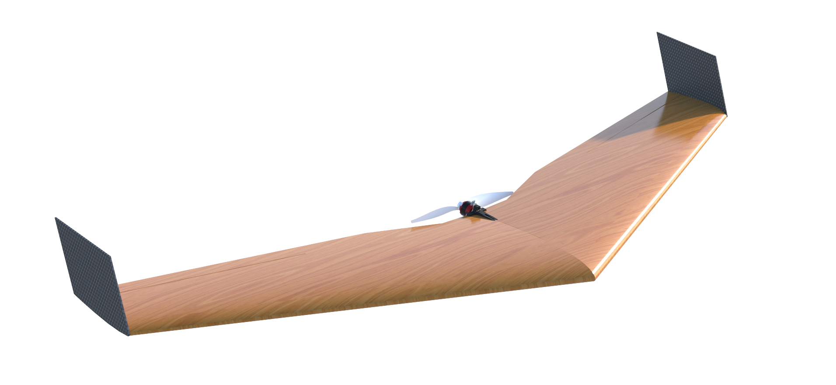
homeworks/homework6/cad/aircraft_assembly.png
