kenneth-tochihara/ae484/homeworks/homework6/manufacturing/main_wing_-z_drawing.pdf

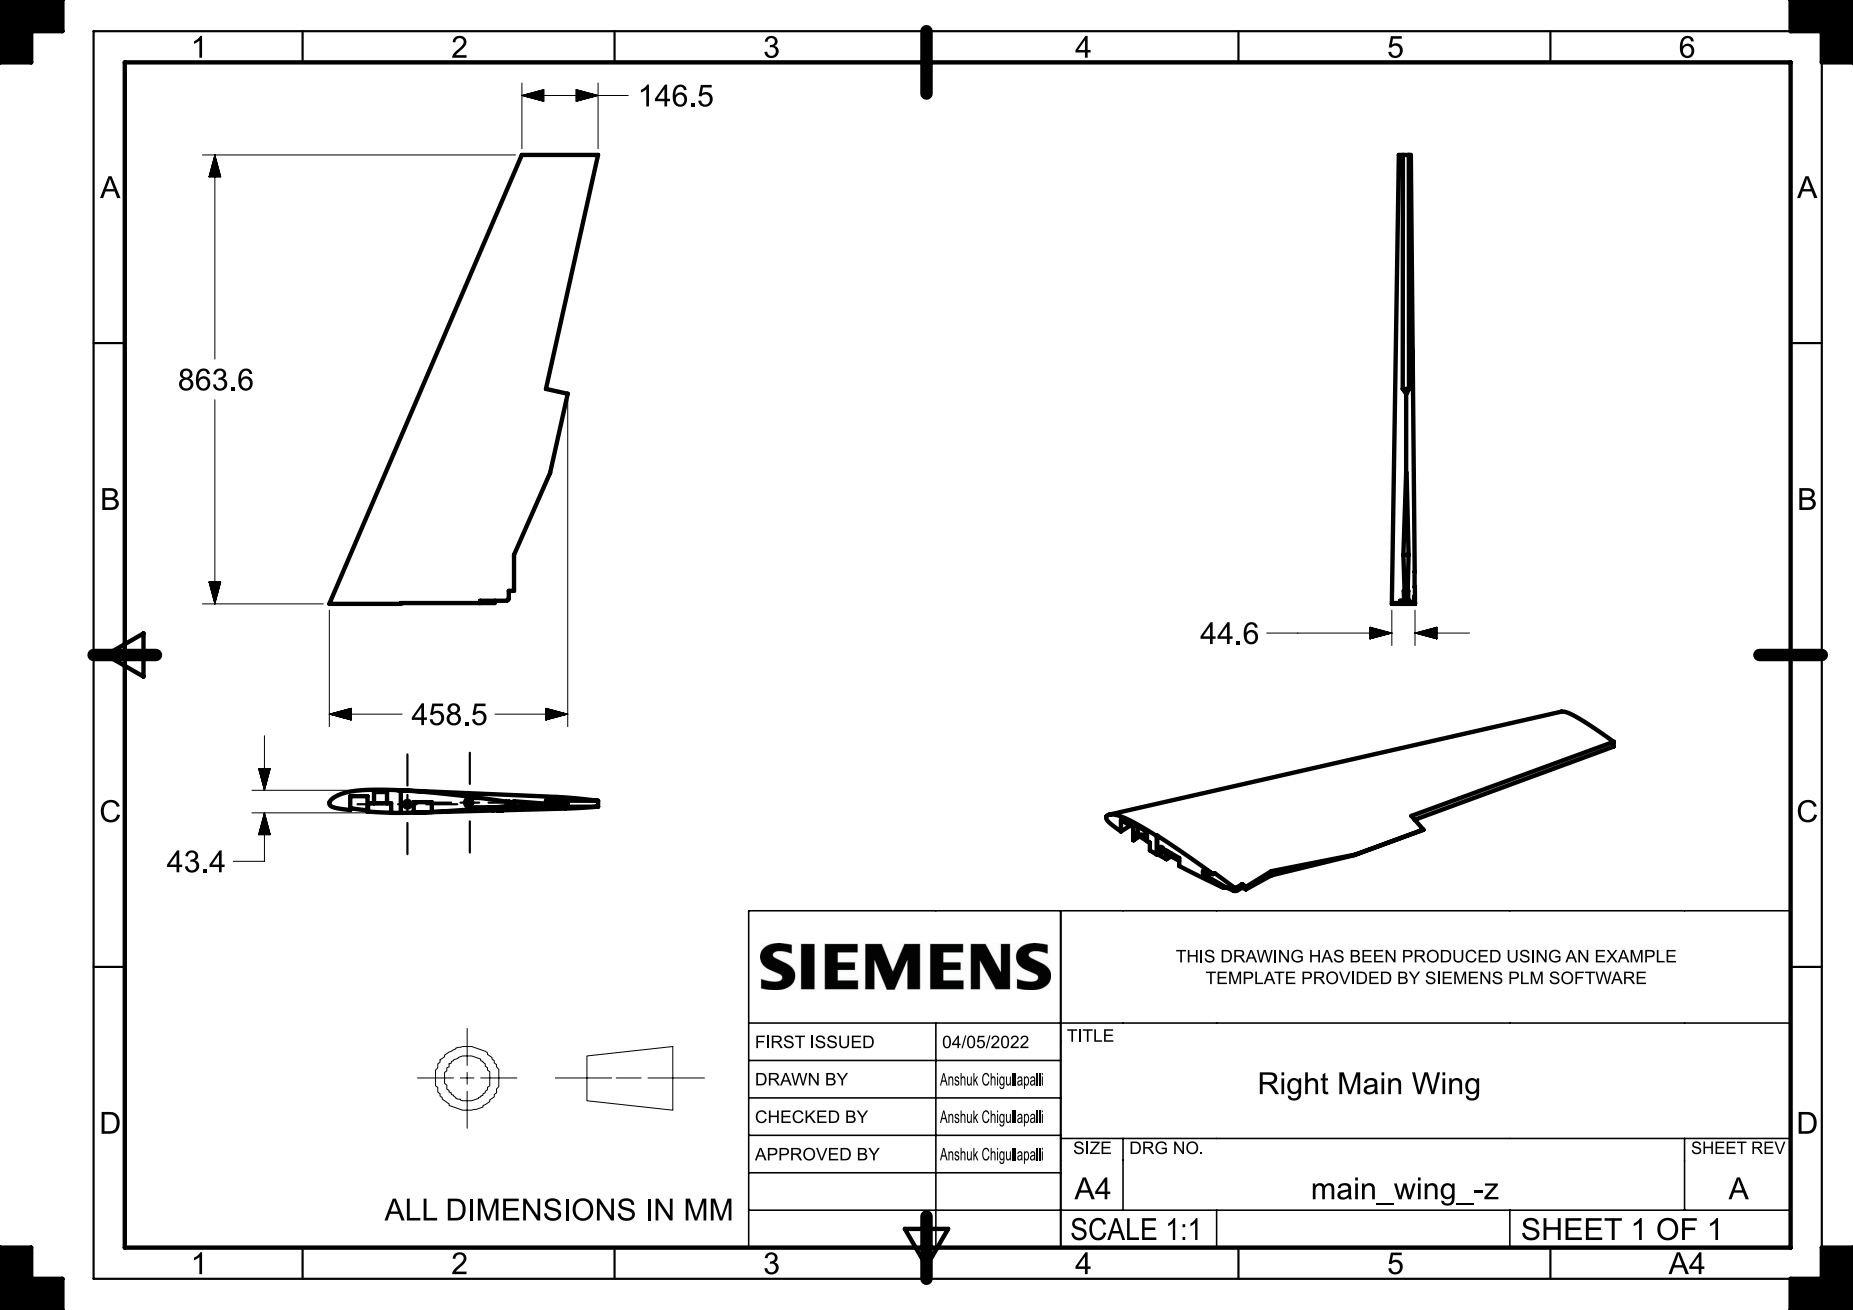
[picture p61: page 1]
