kenneth-tochihara/ae484/homeworks/homework6/drawings/assembly_dimensions.pdf

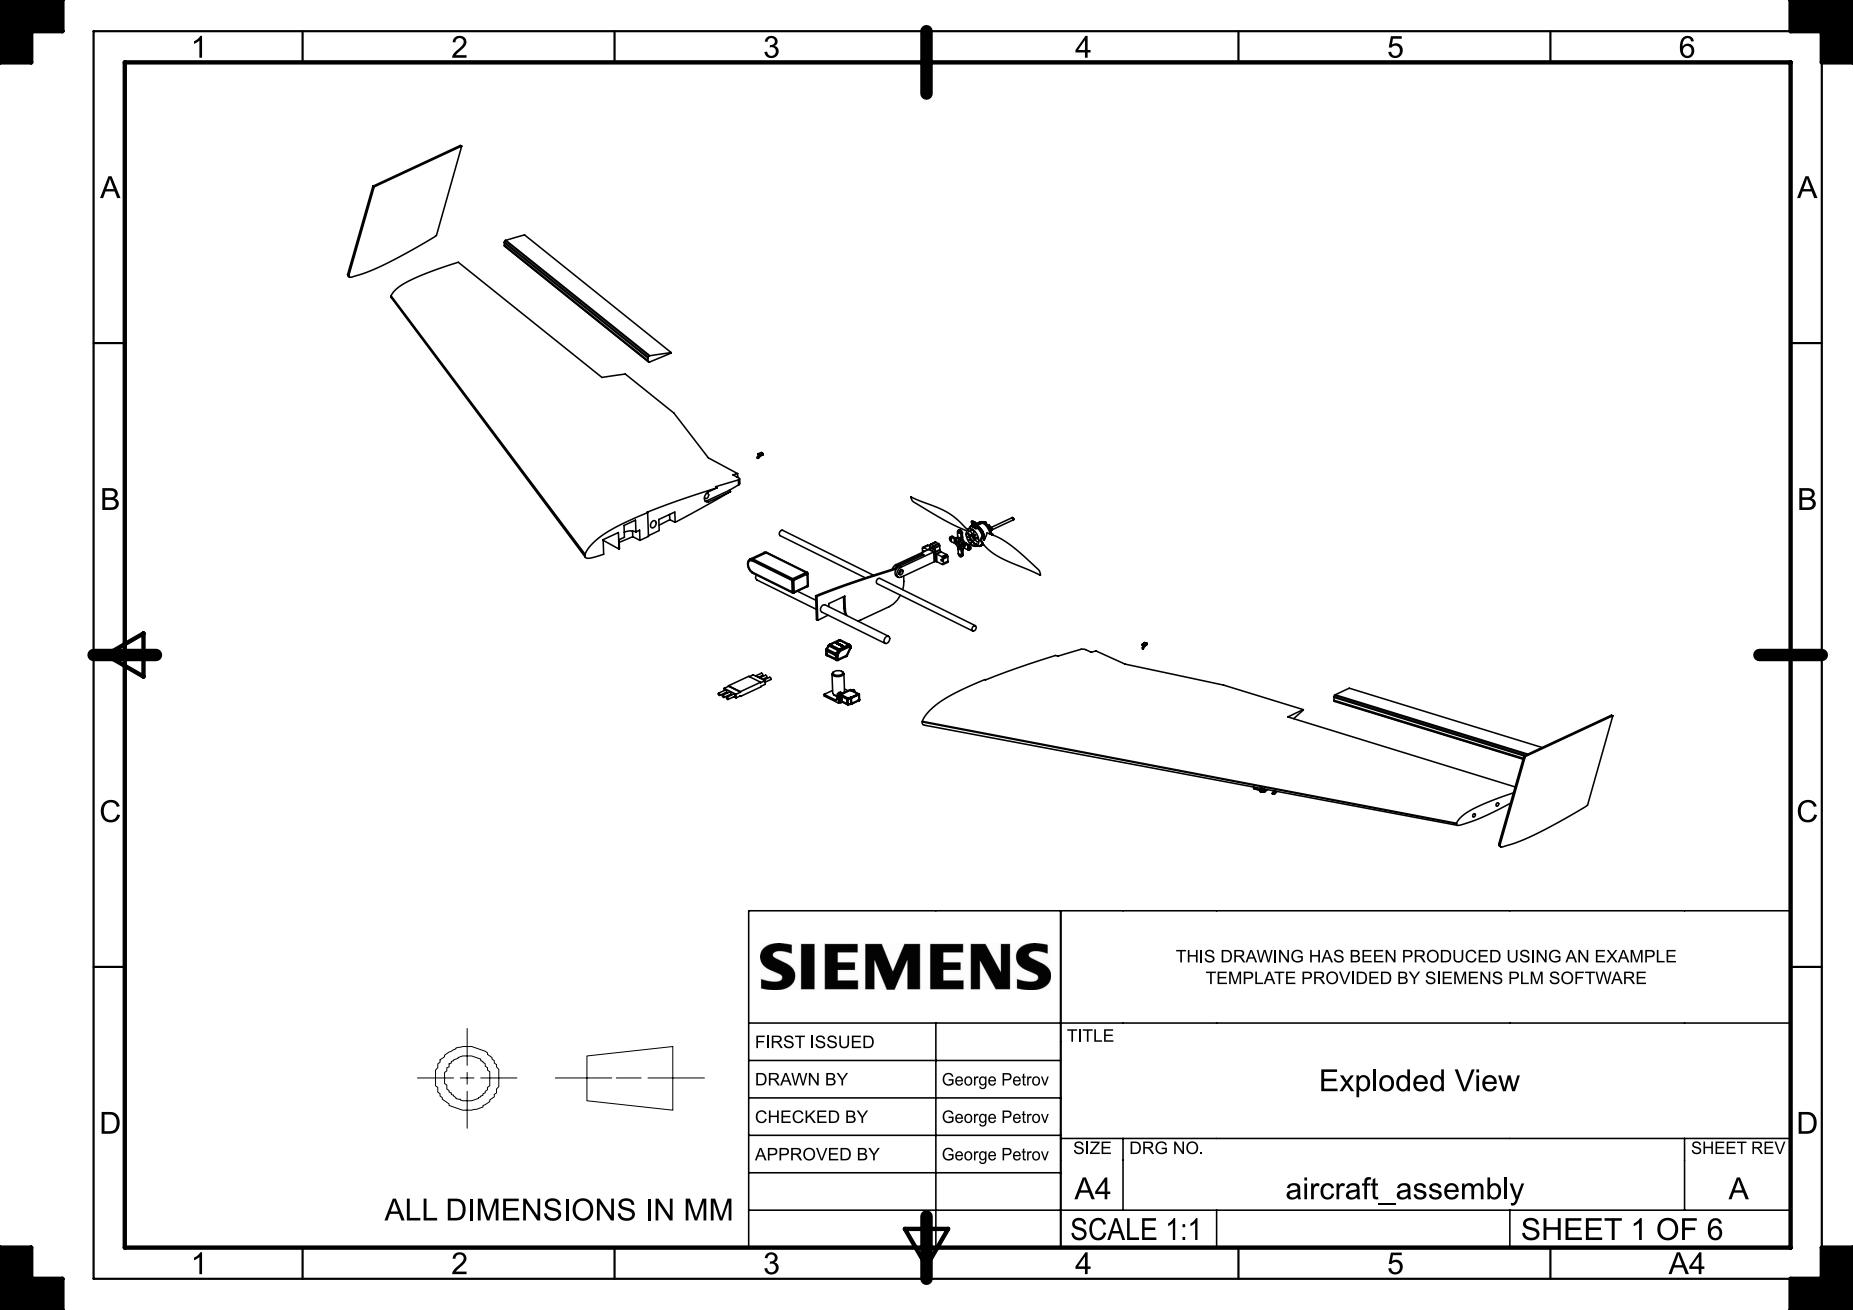
[picture p62: page 1]

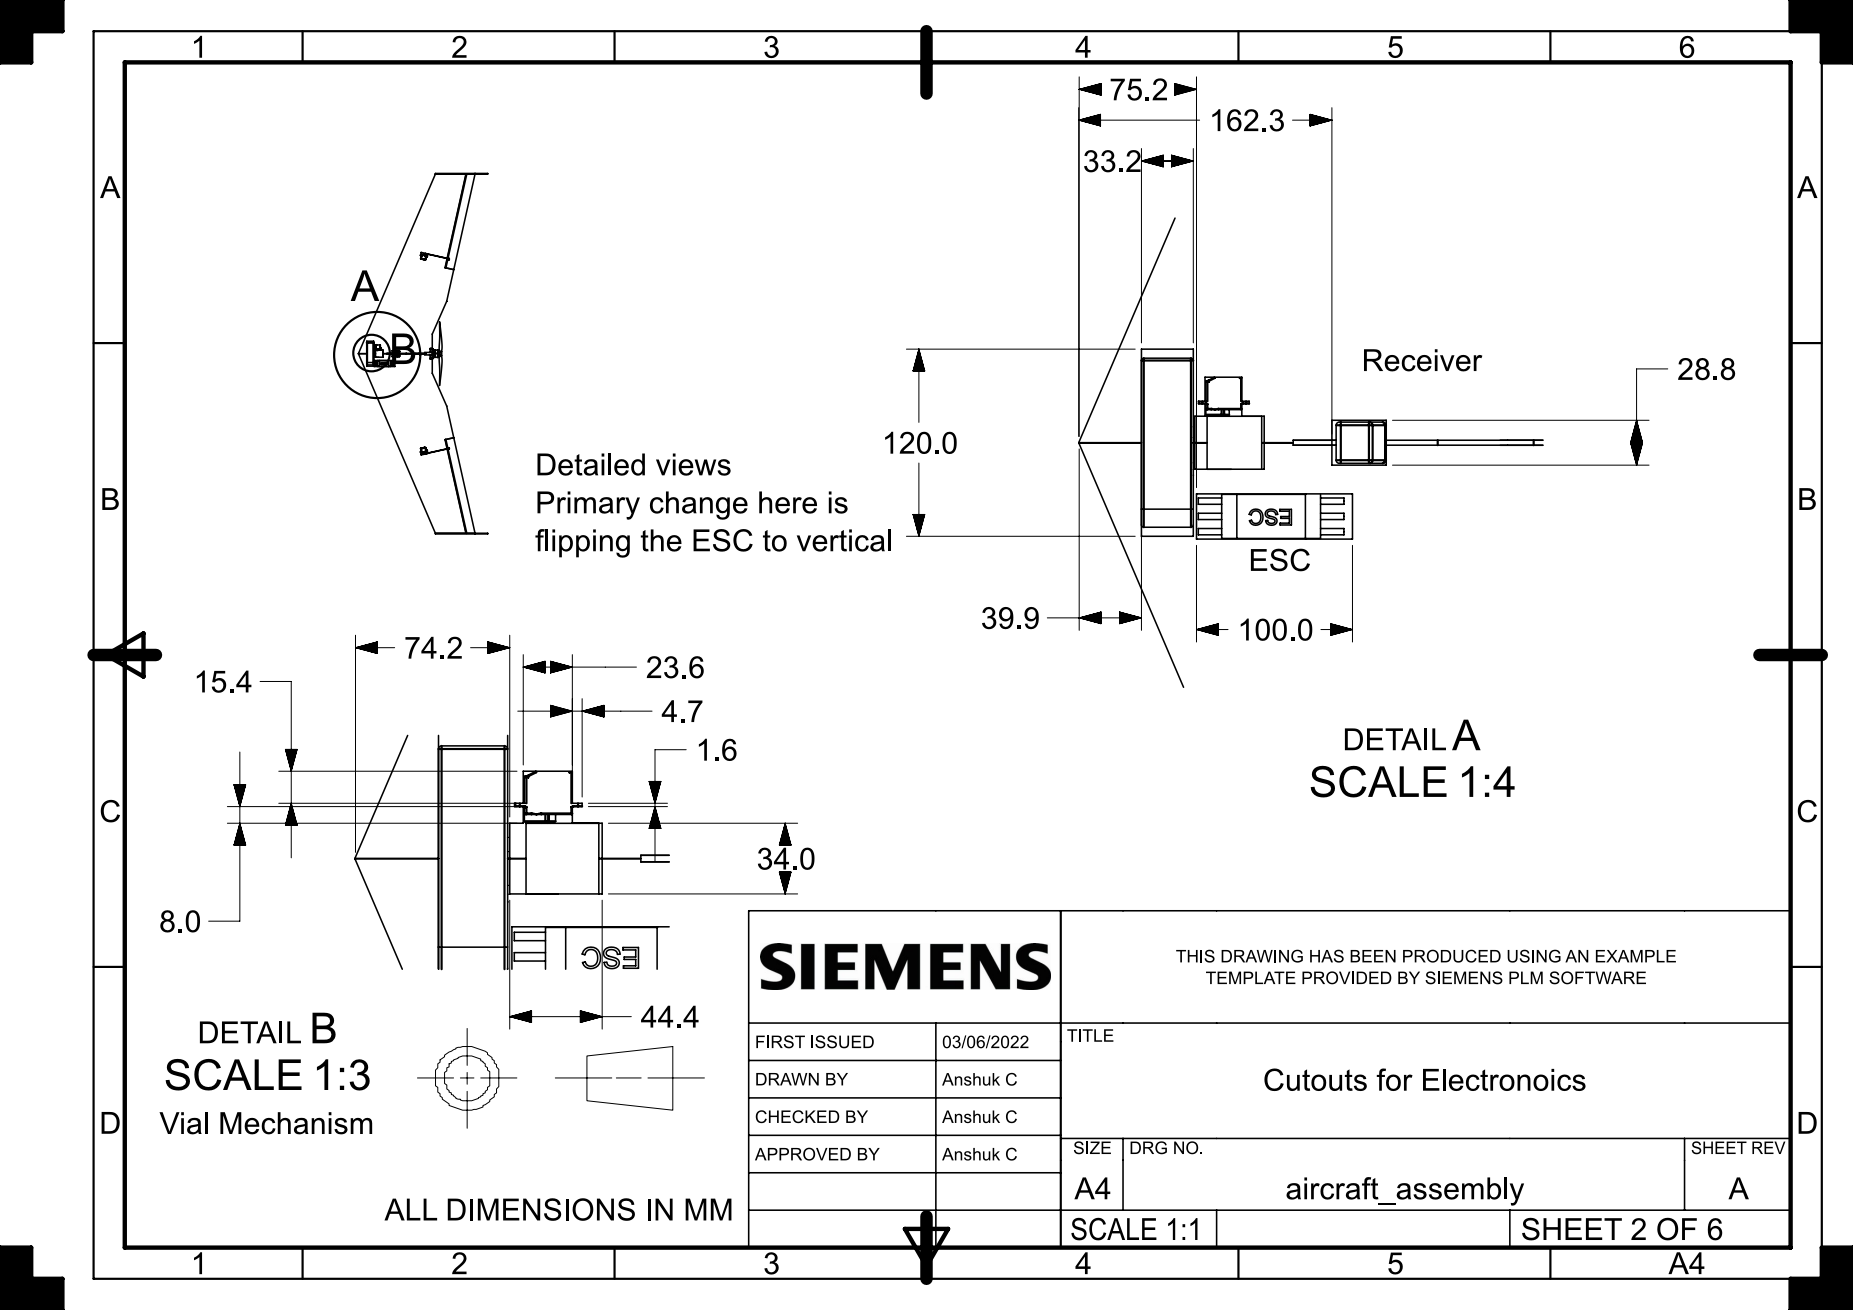
[picture p63: page 2]

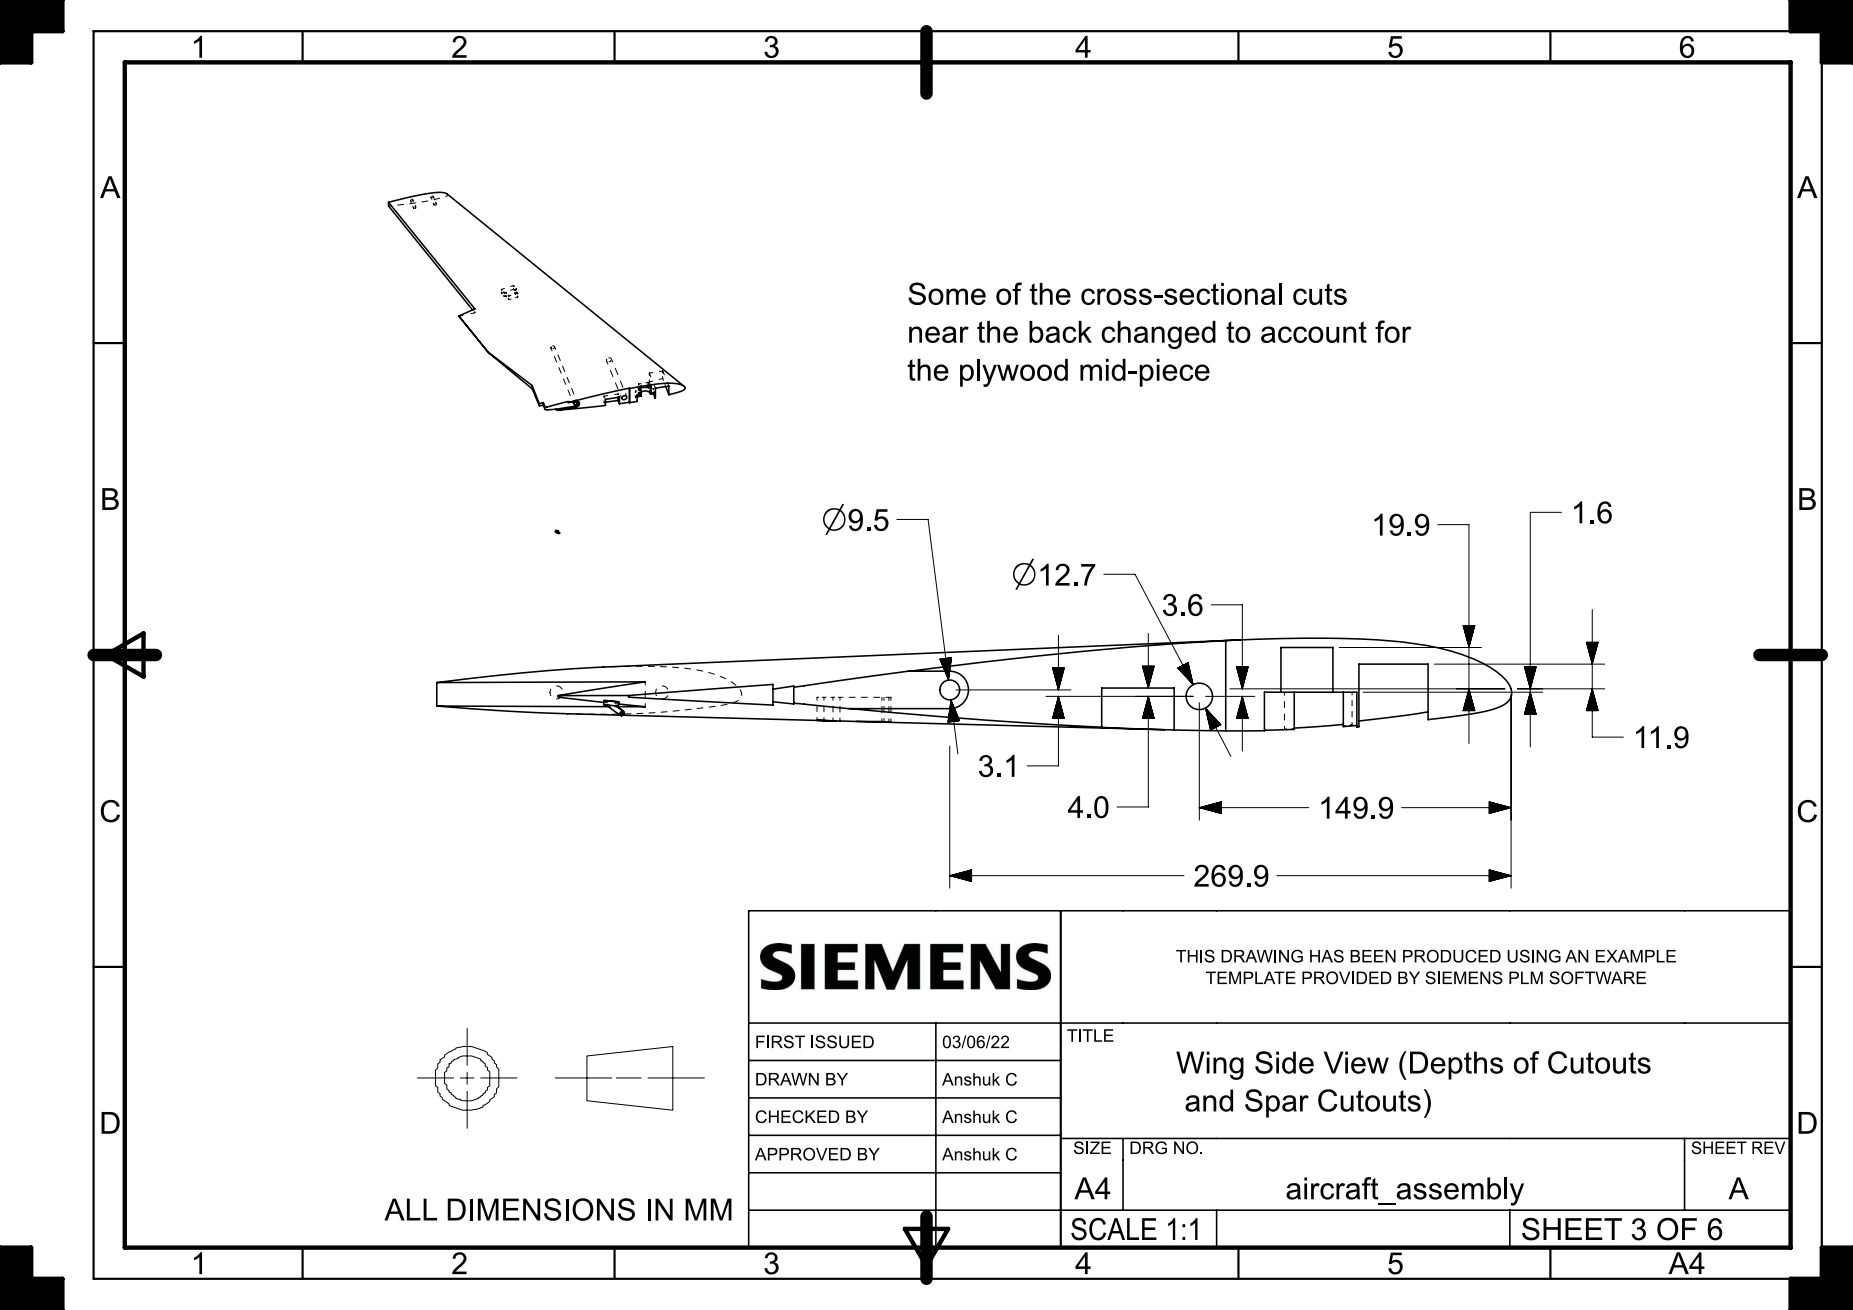
[picture p64: page 3]

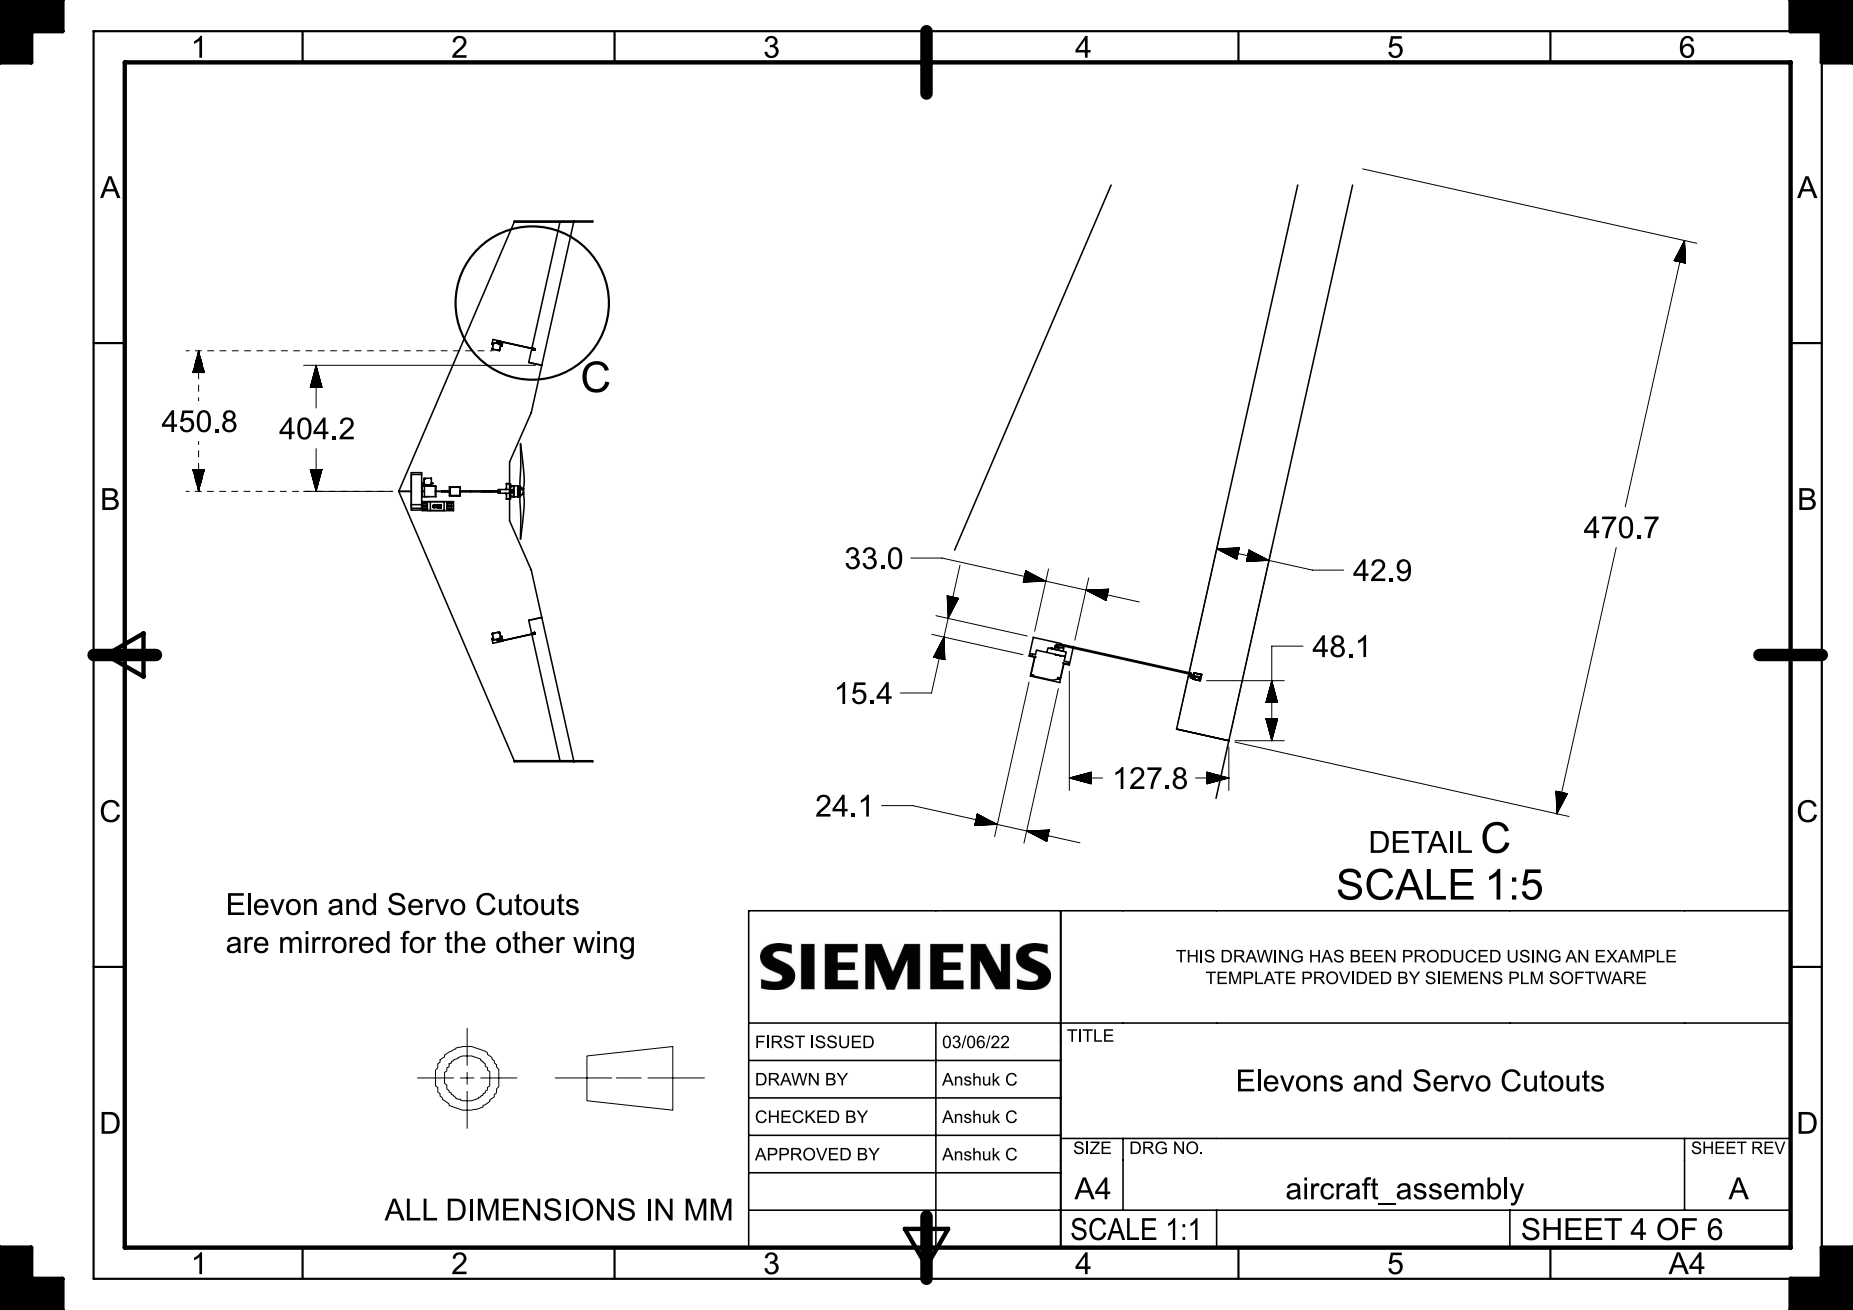
[picture p65: page 4]

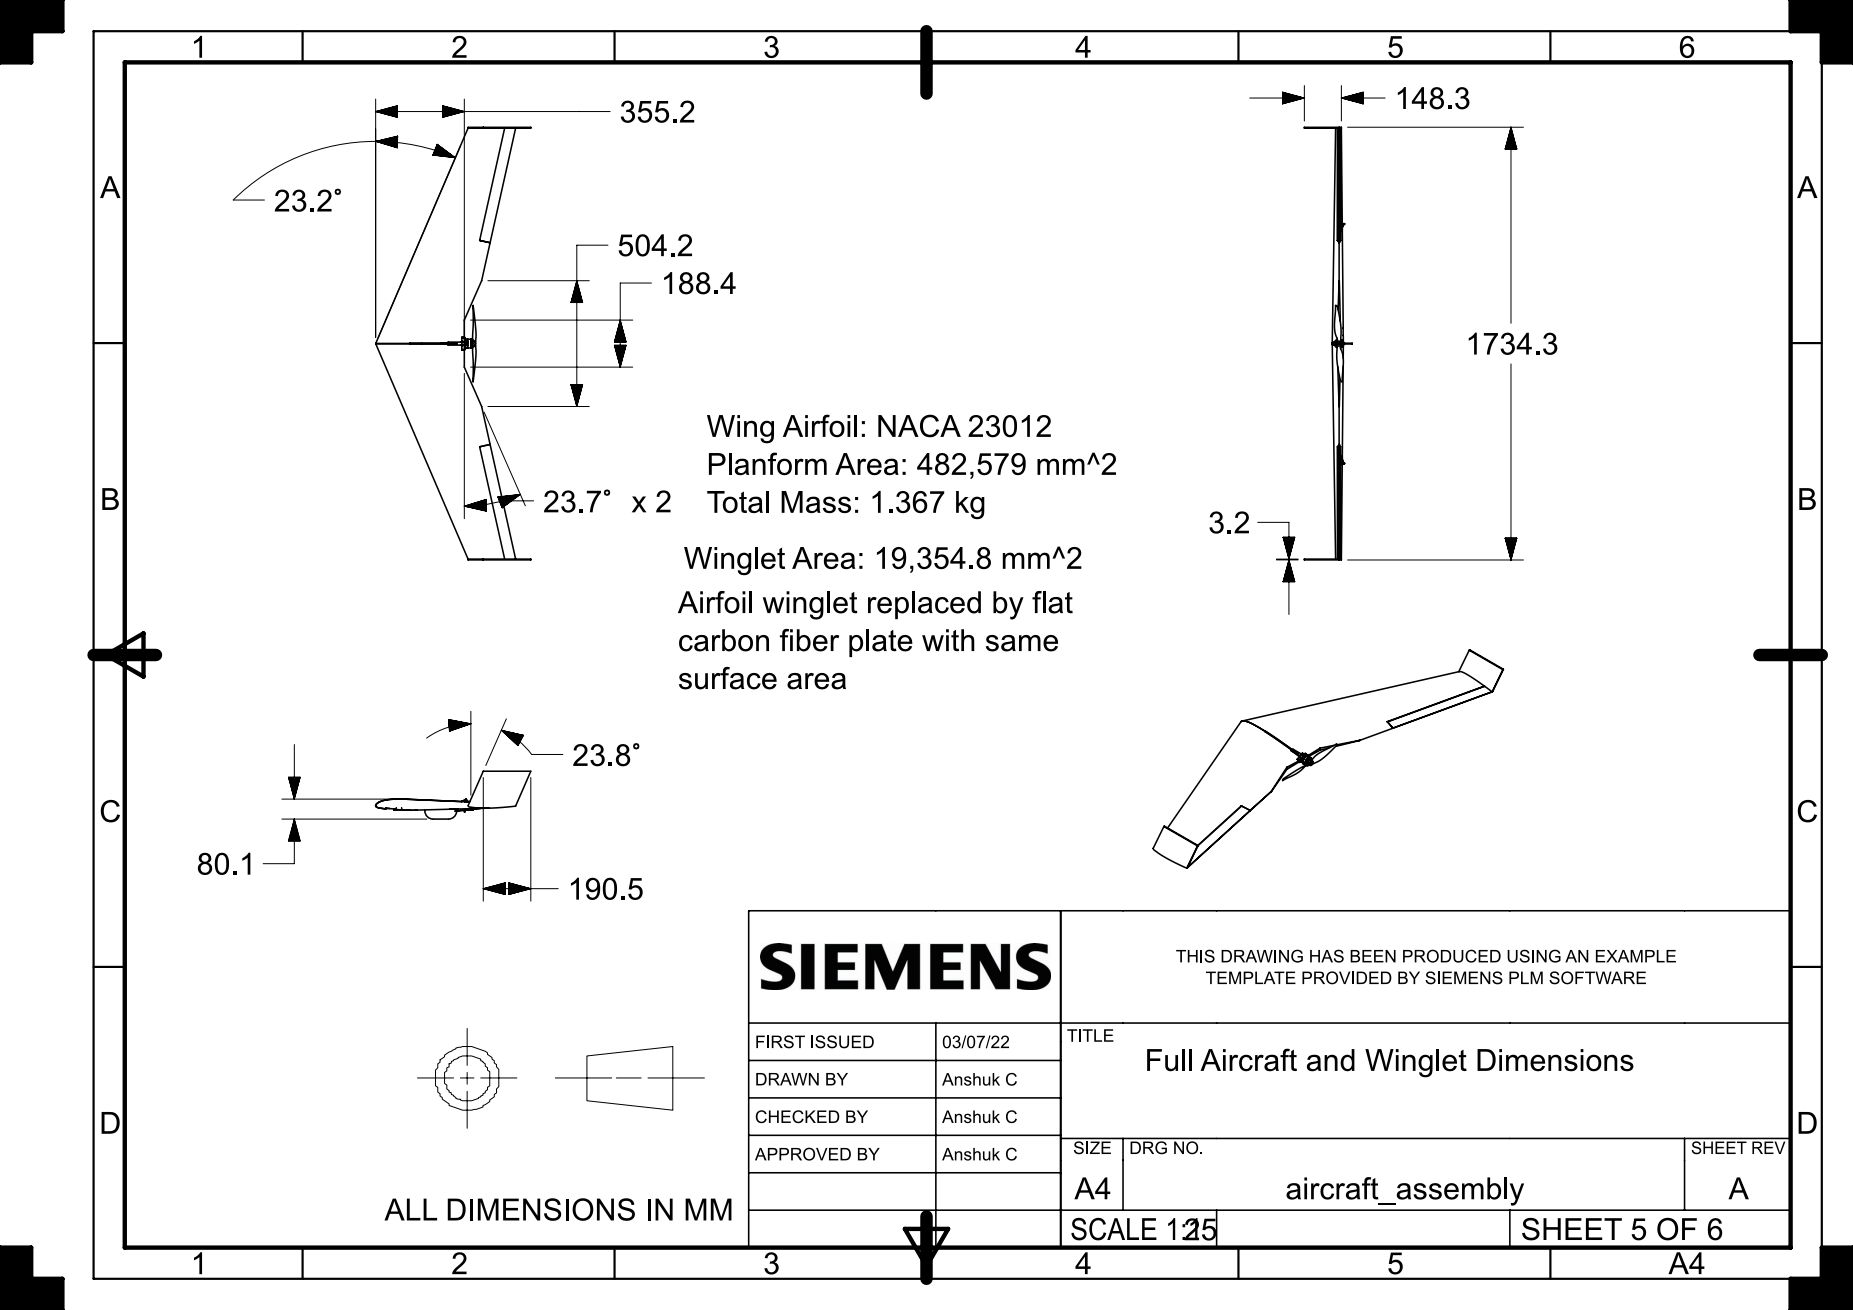
[picture p66: page 5]

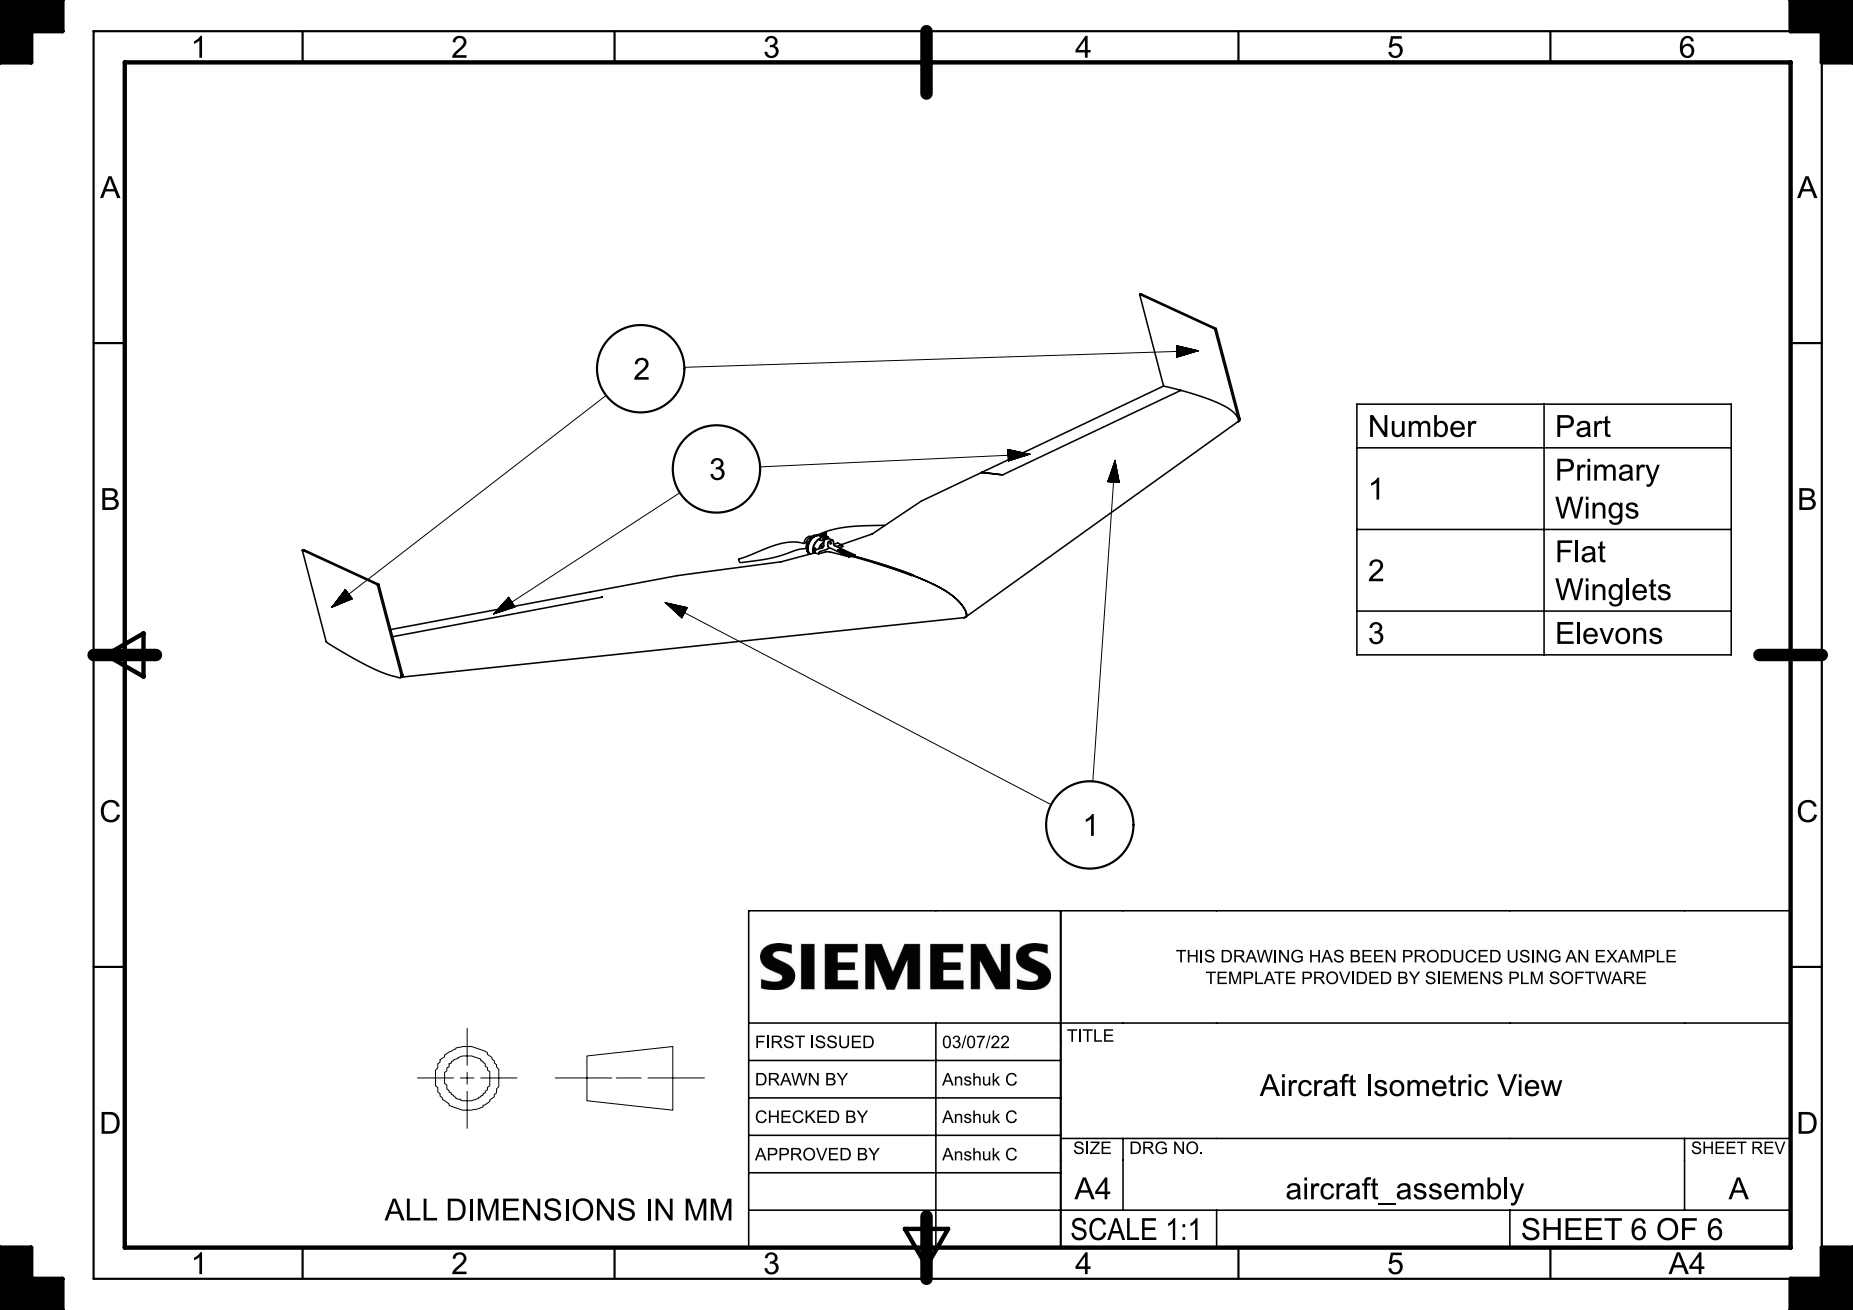
[picture p67: page 6]
