kenneth-tochihara/ae484/homeworks/homework6/manufacturing/flat_winglets_drawings.pdf

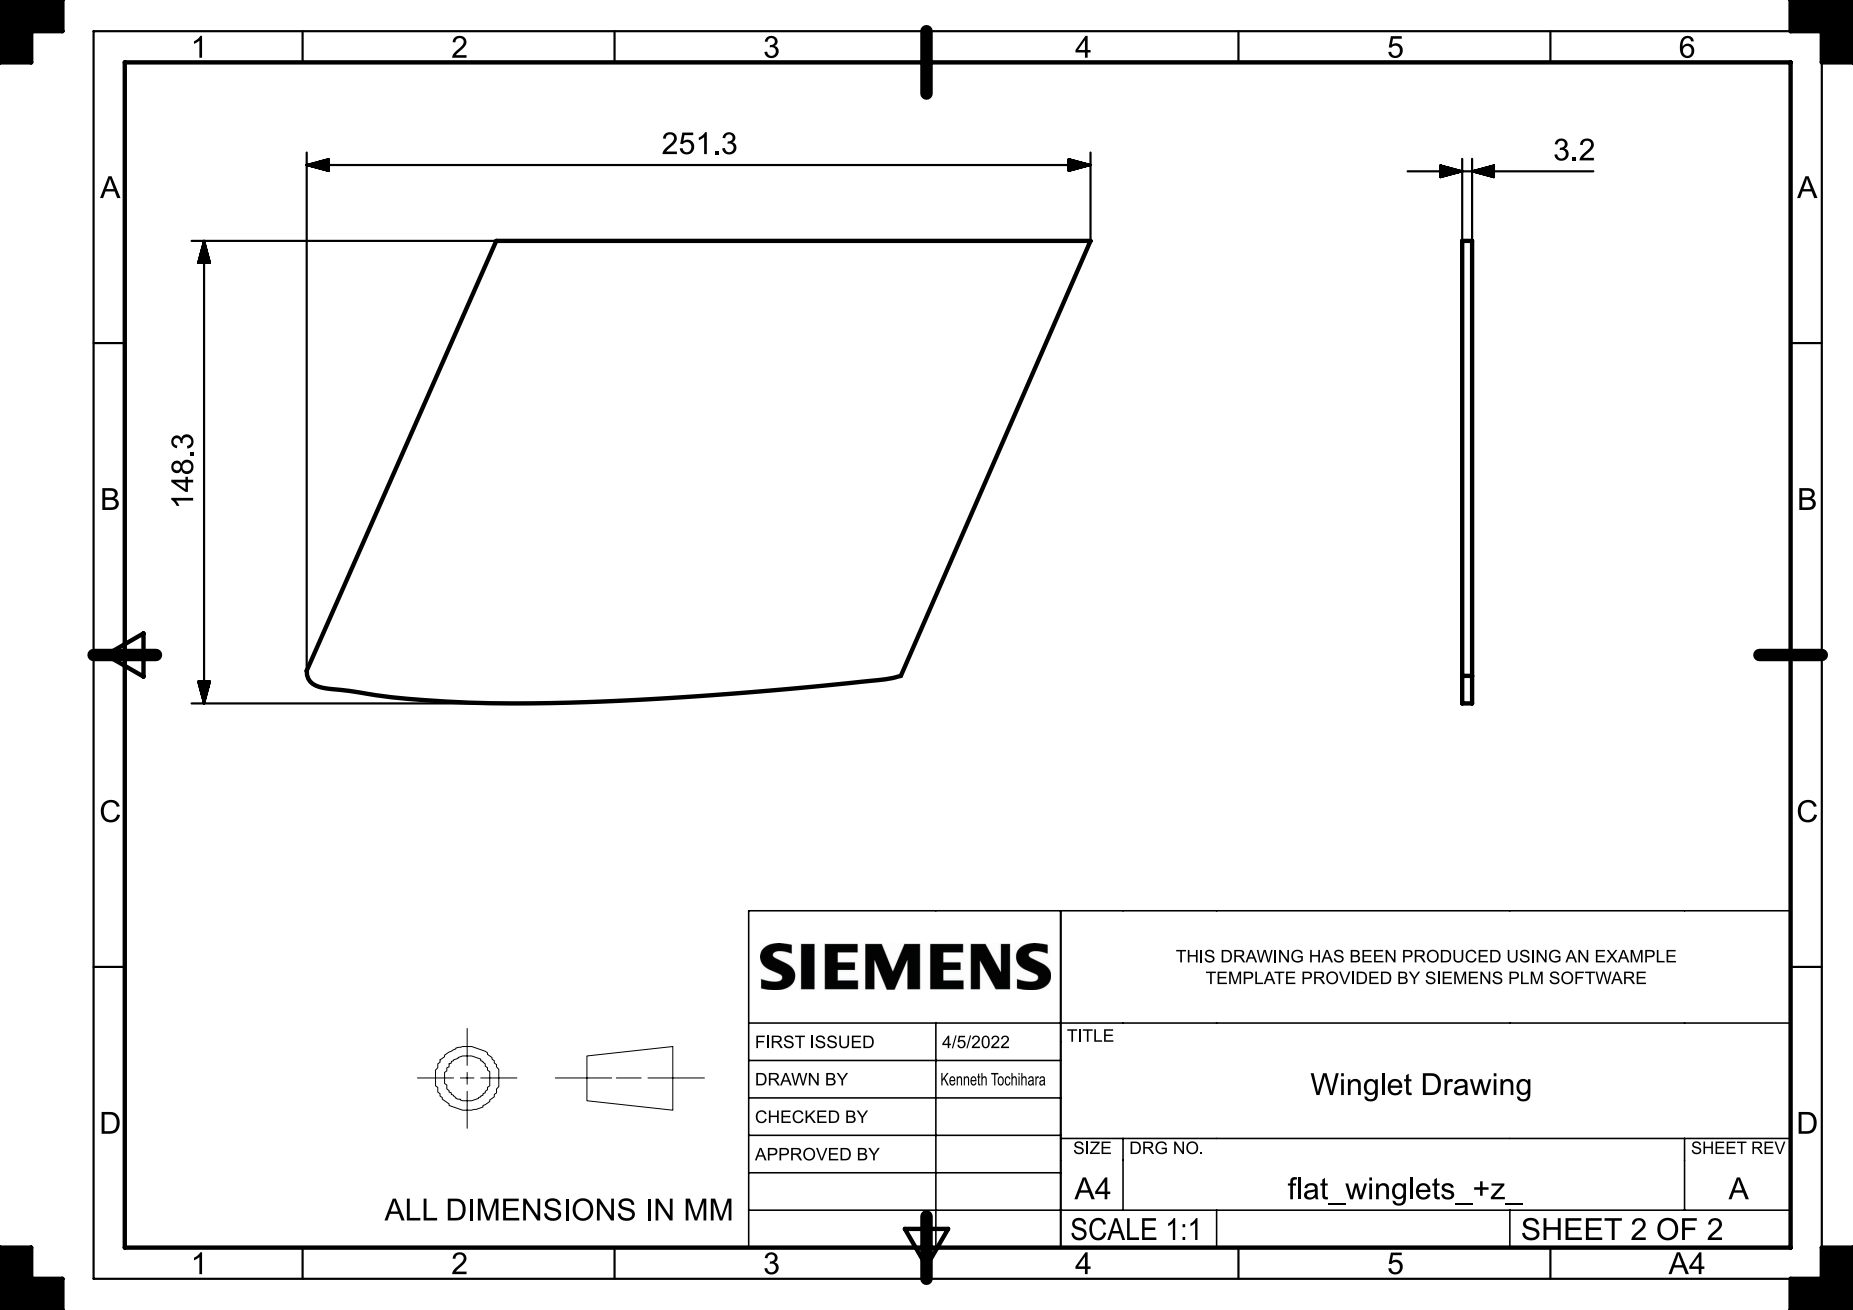
[picture p68: page 1]
