kenneth-tochihara/ae484/homeworks/homework6/manufacturing/holder_mid_drawing.pdf

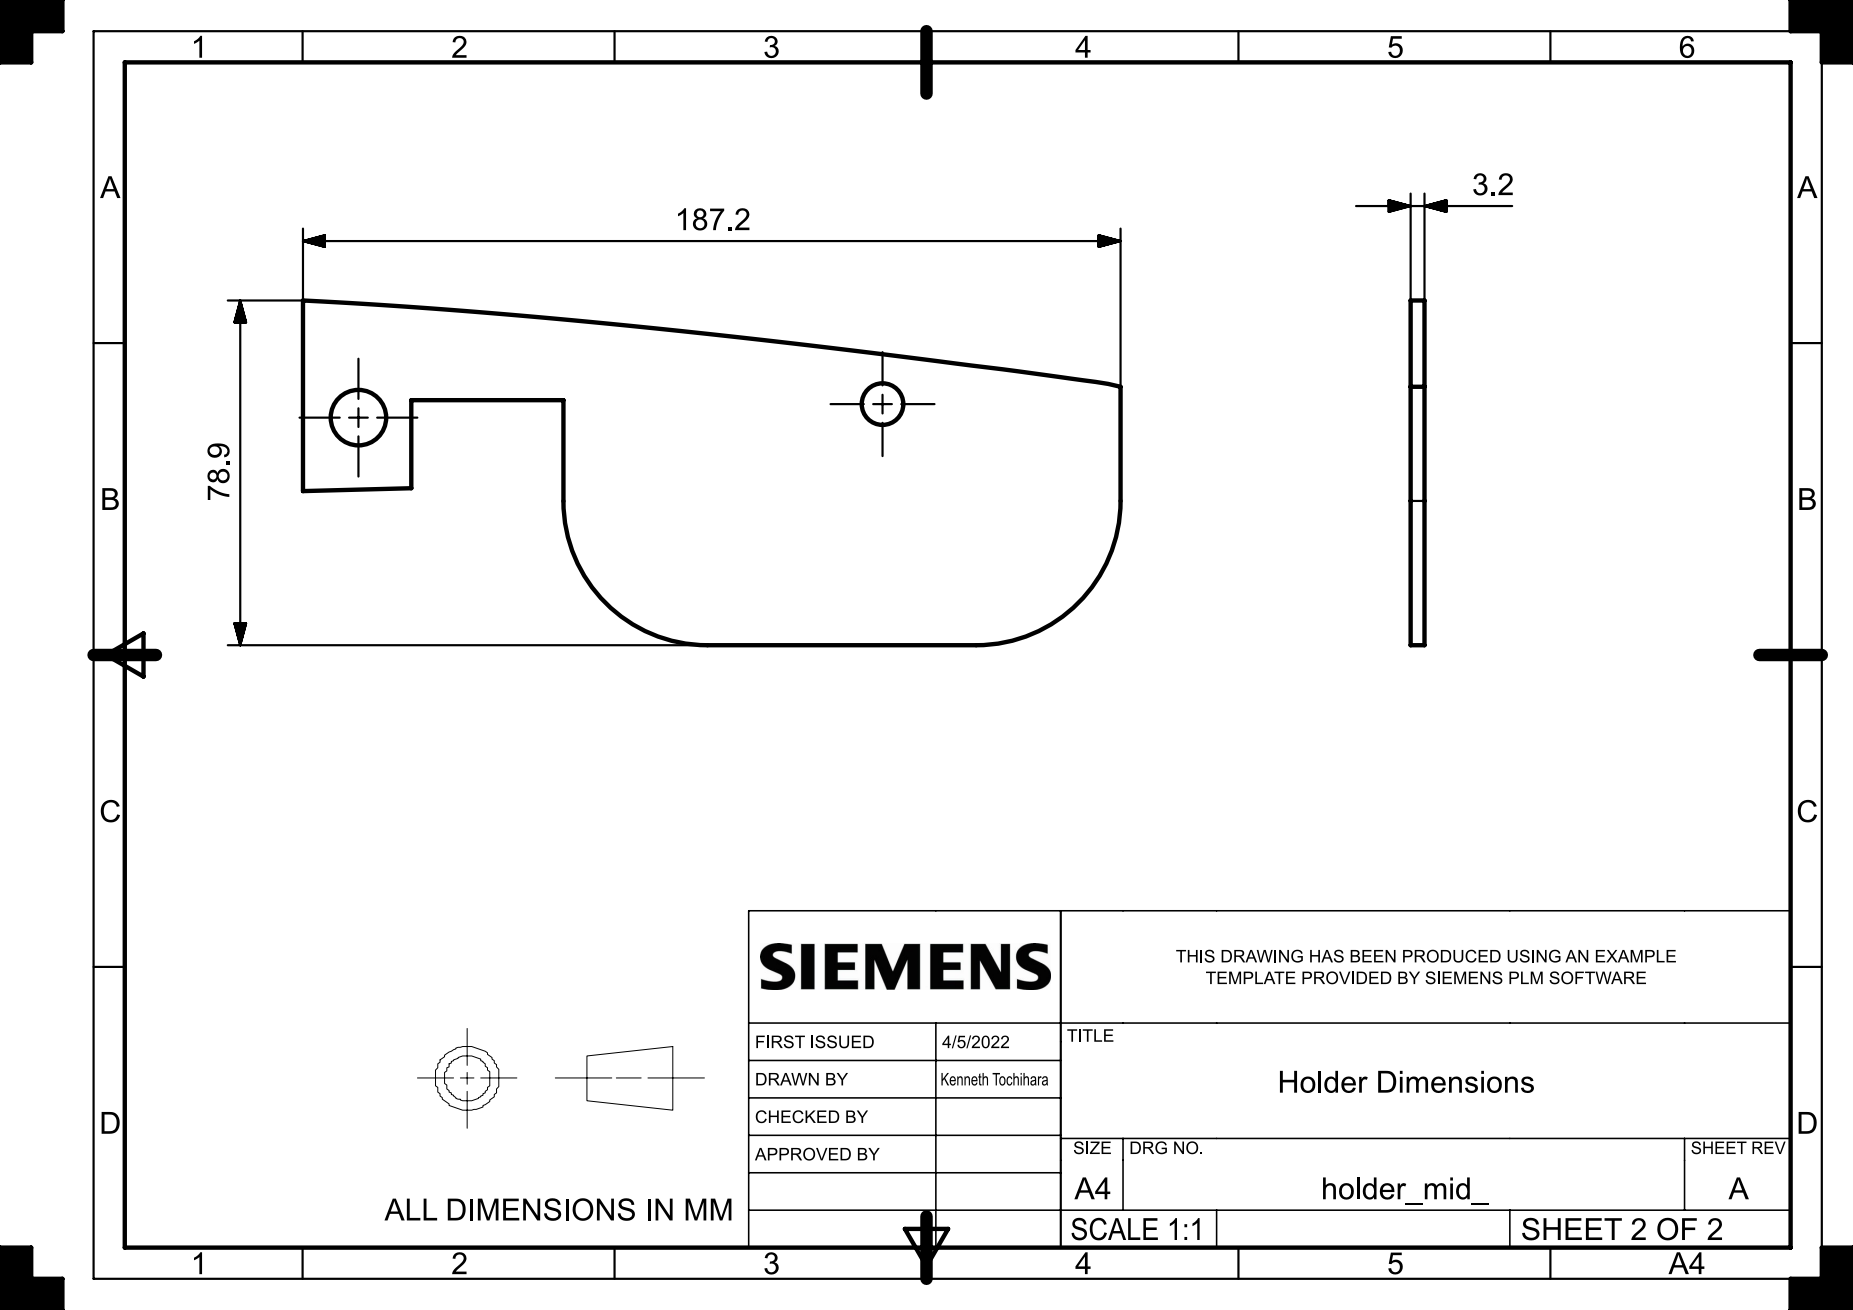
[picture p69: page 1]
