kenneth-tochihara/ae484/homeworks/homework6/drawings/assembly_component_locations.pdf

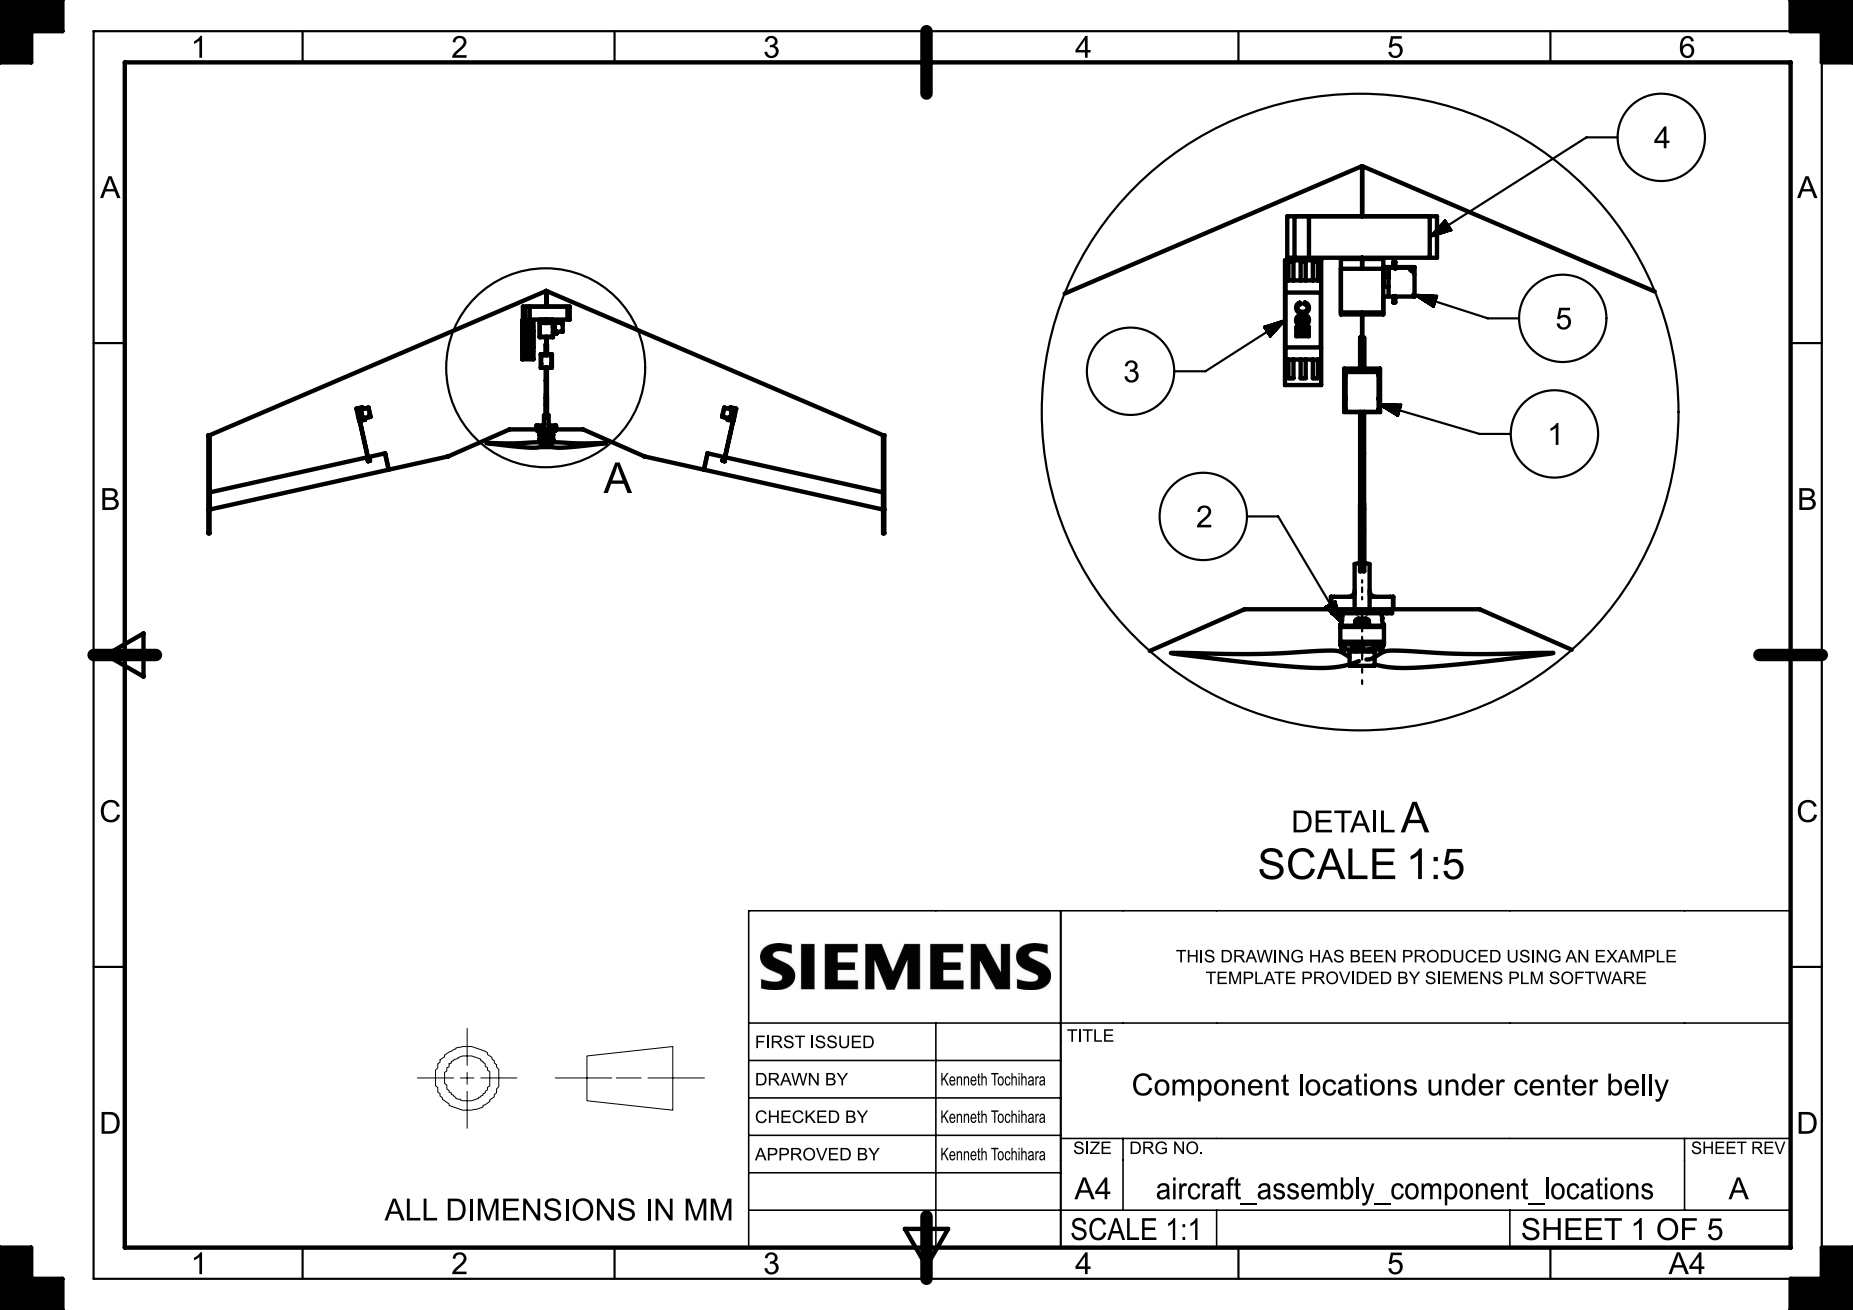
[picture p70: page 1]

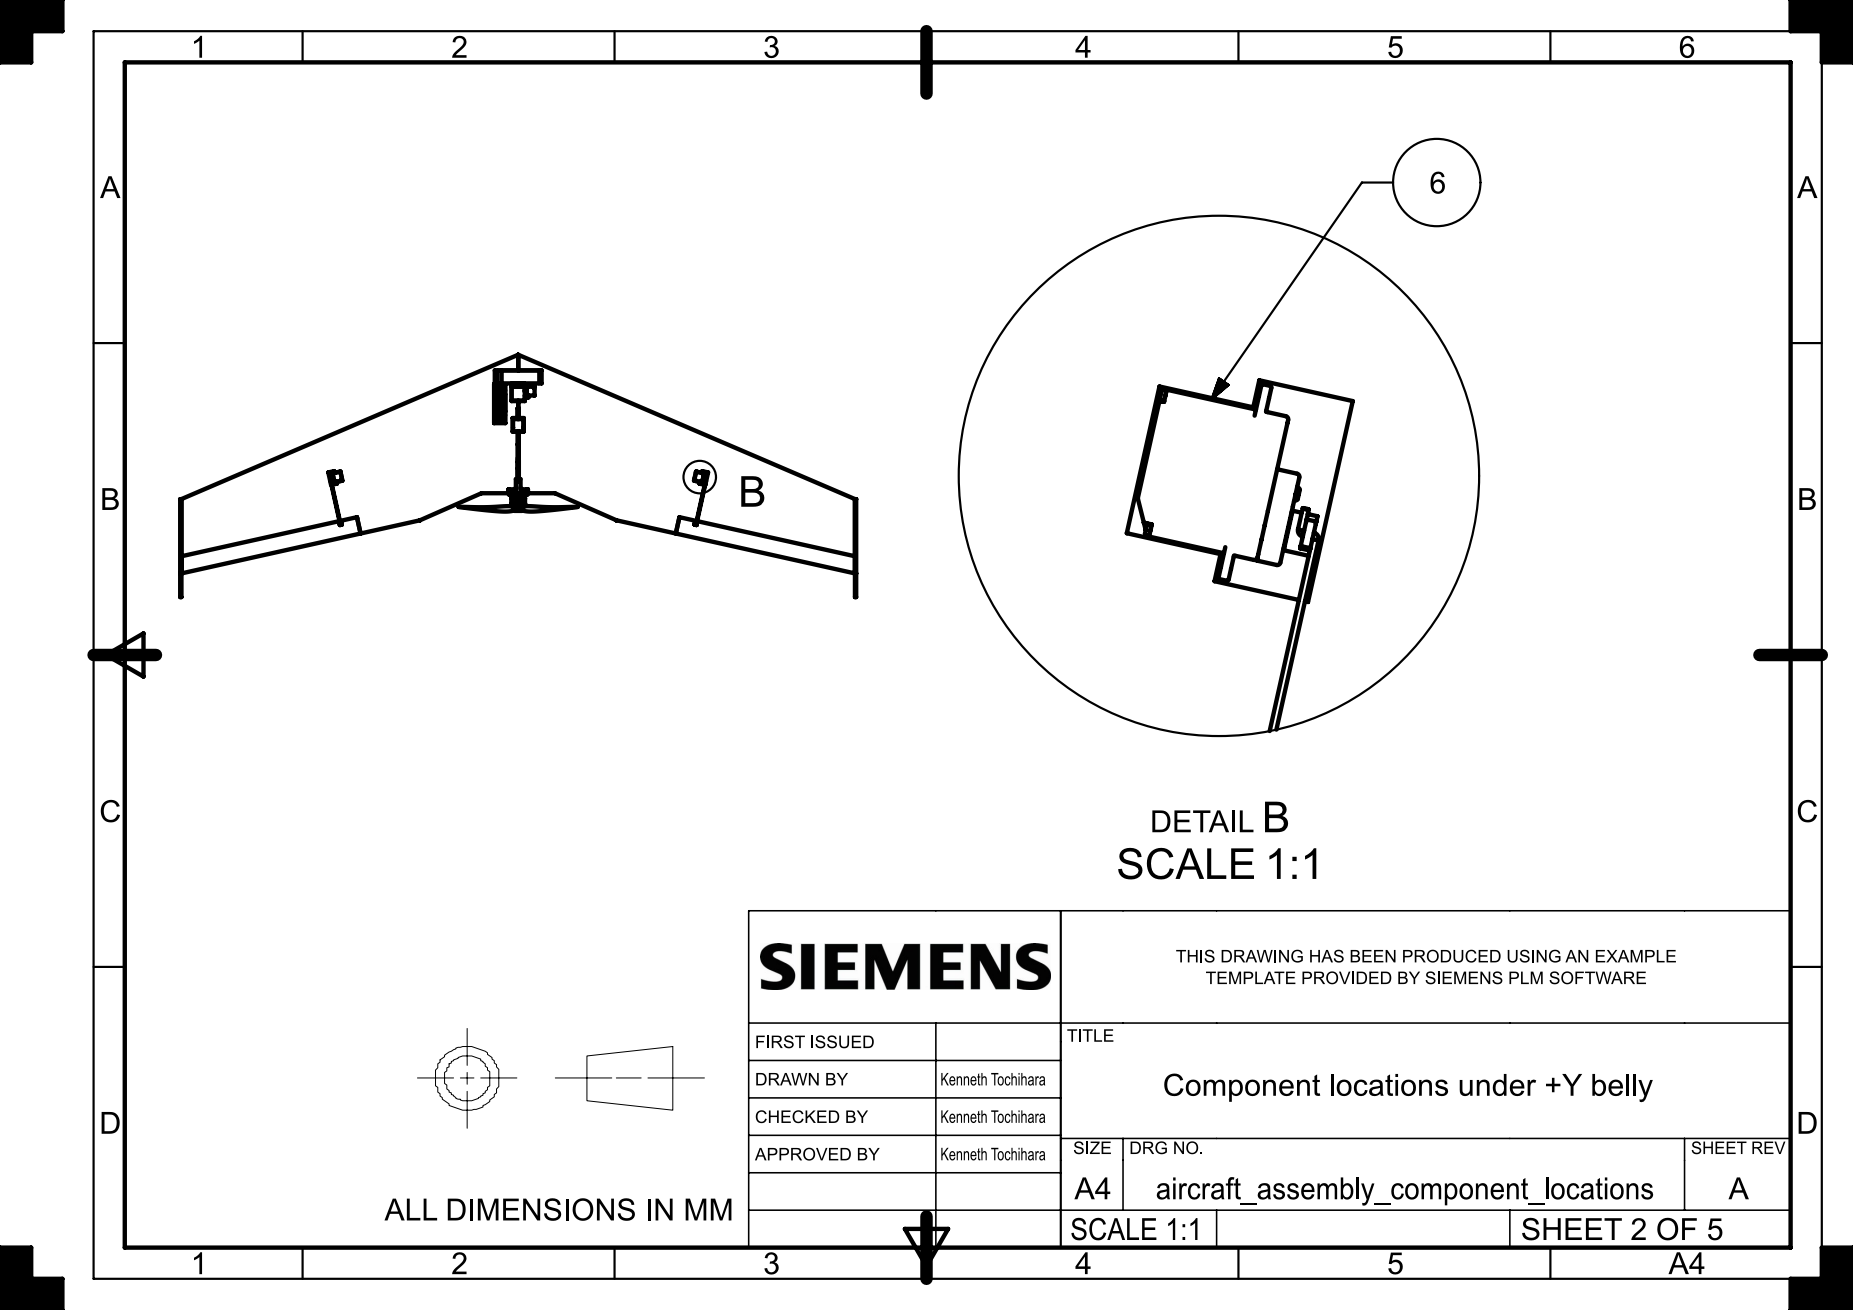
[picture p71: page 2]

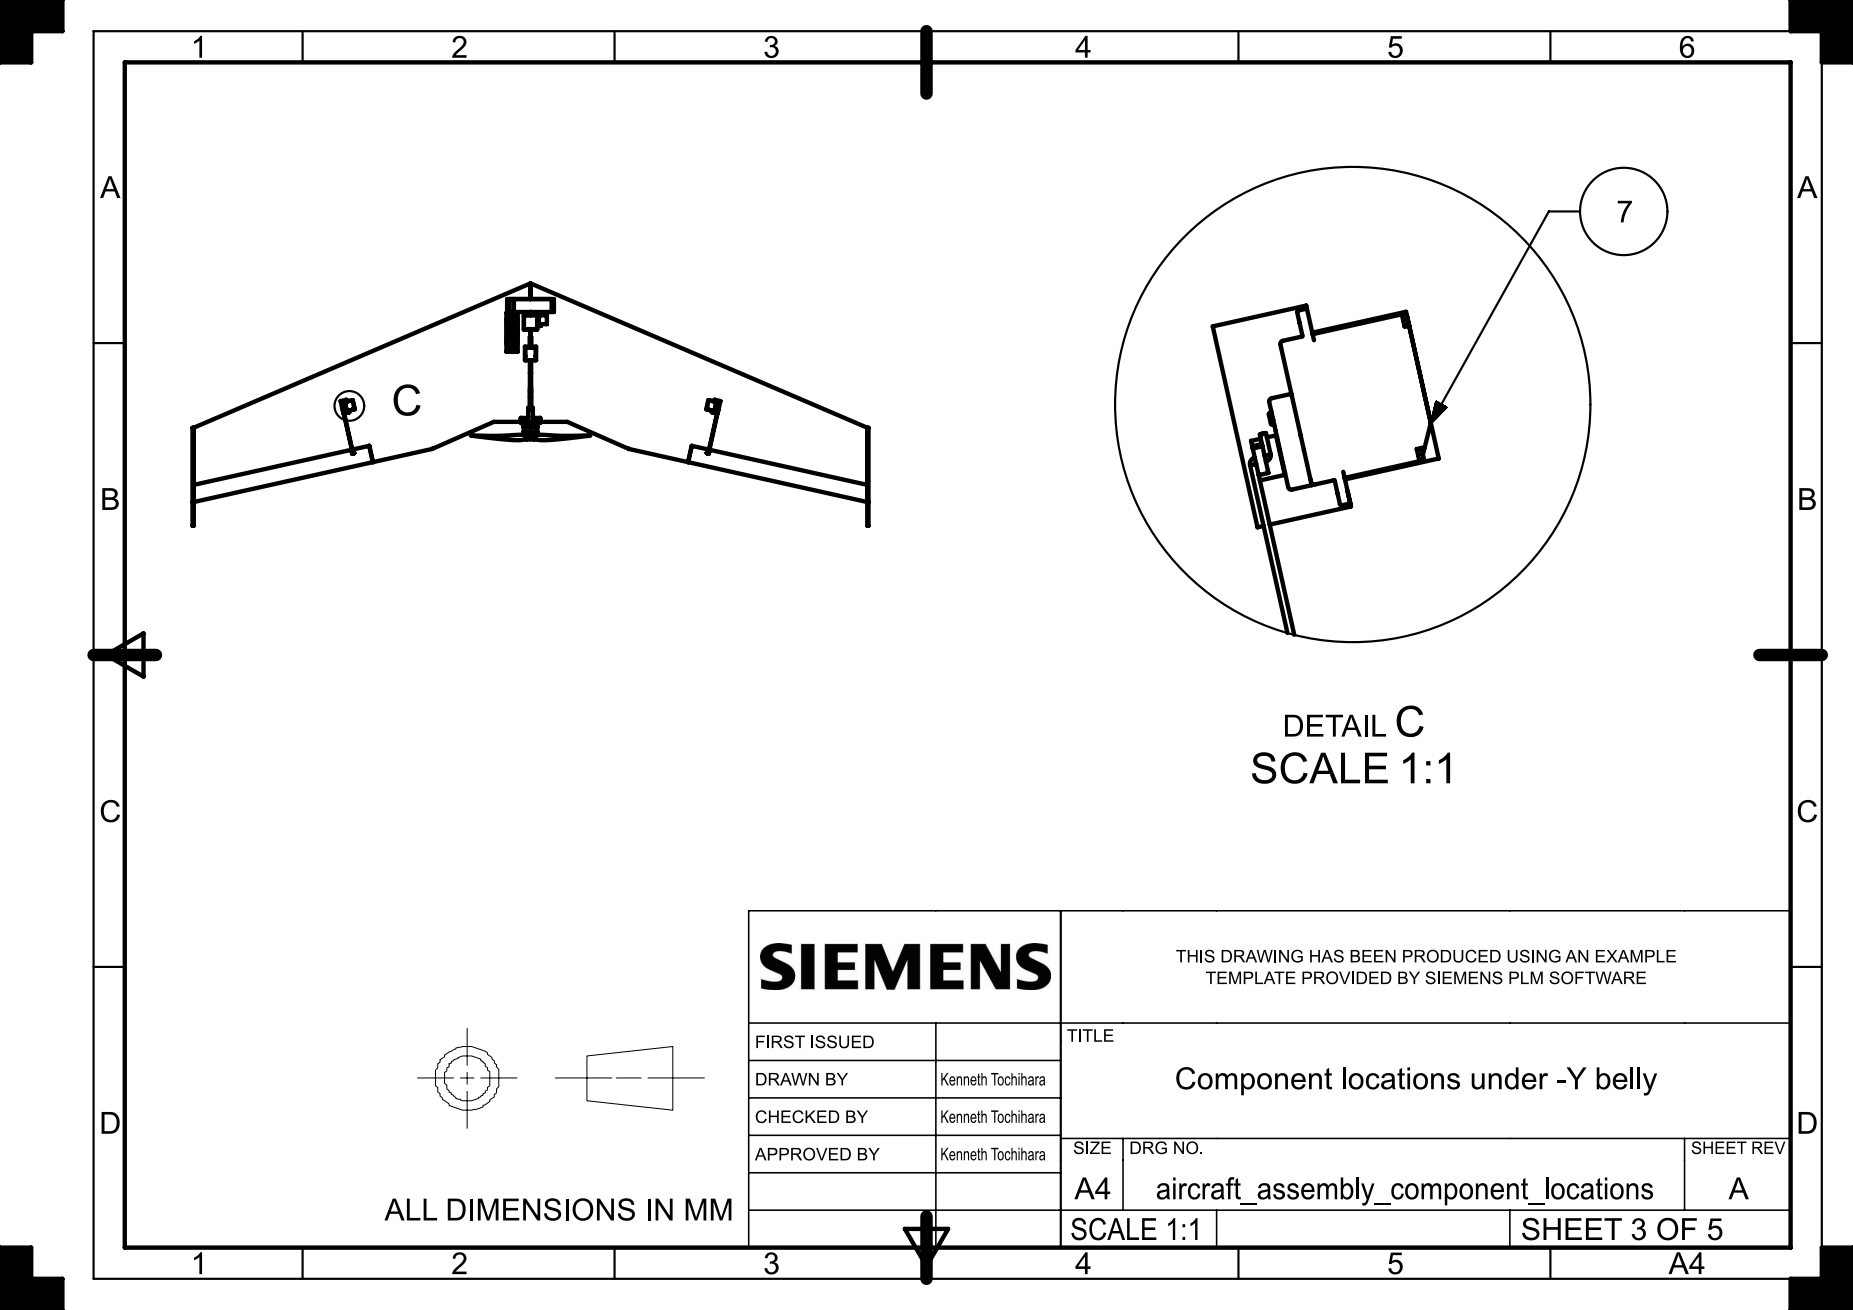
[picture p72: page 3]

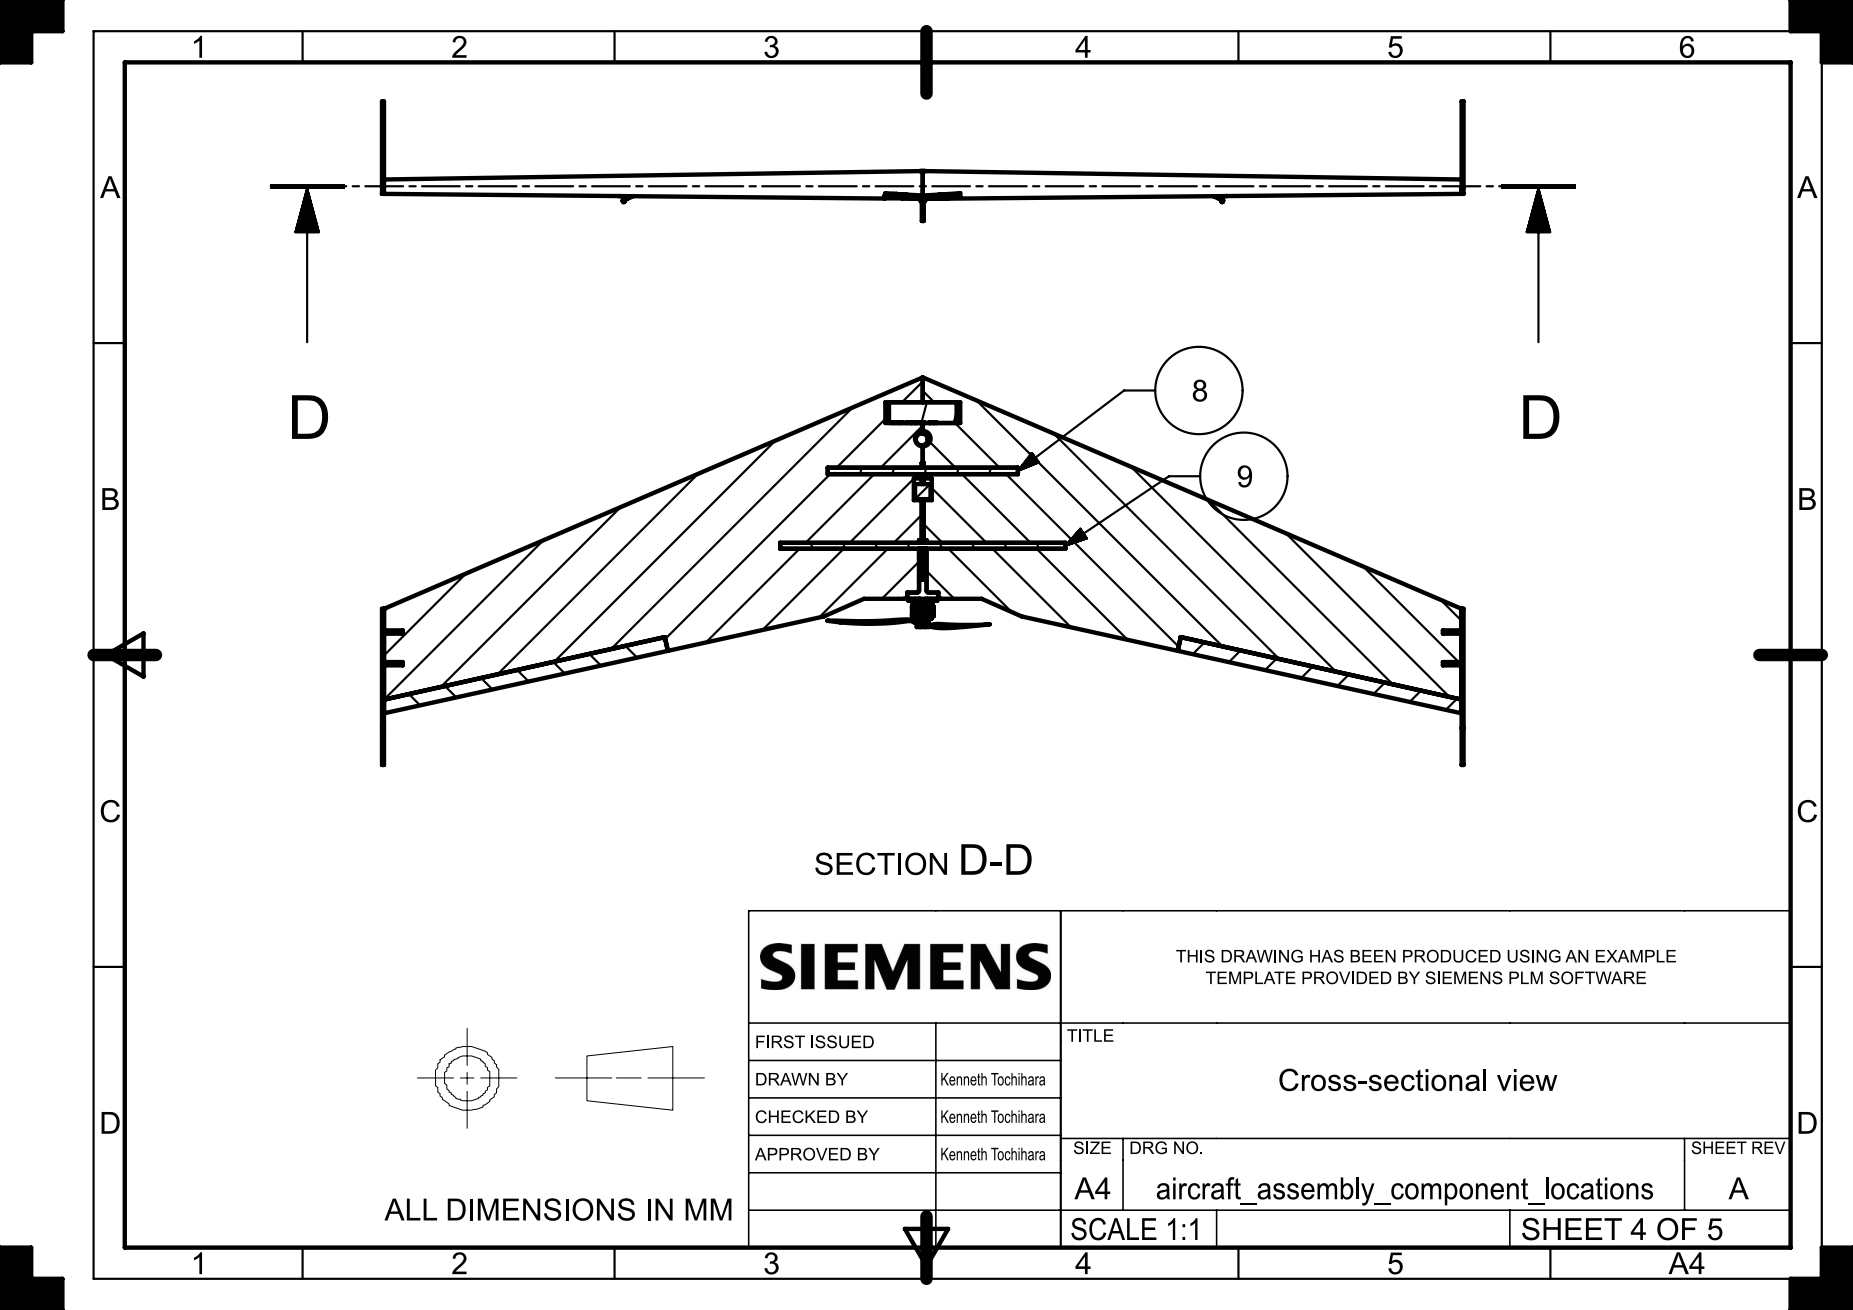
[picture p73: page 4]

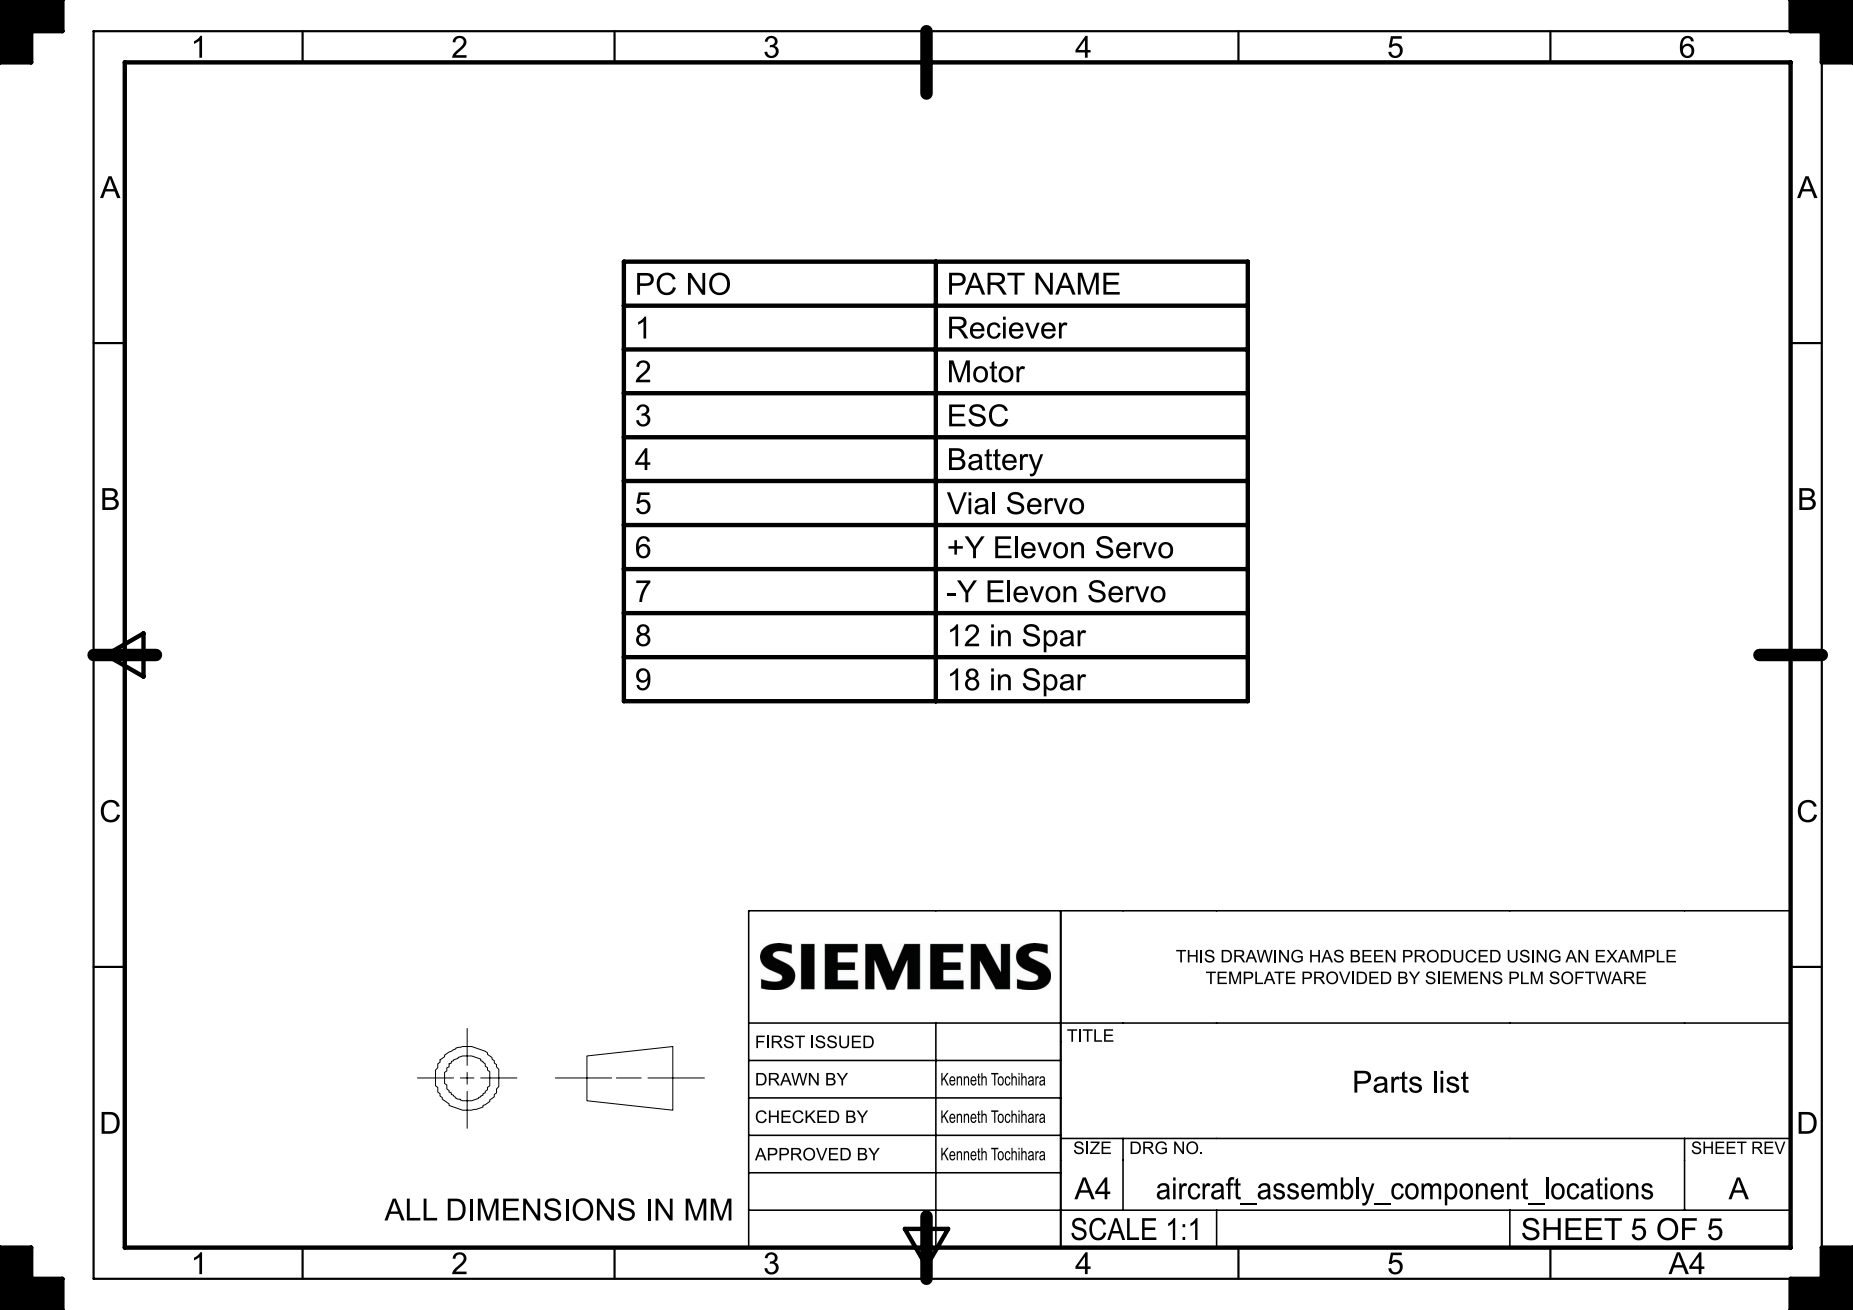
[picture p74: page 5]
