kenneth-tochihara/ae484/homeworks/homework6/manufacturing/flat_winglets.pdf

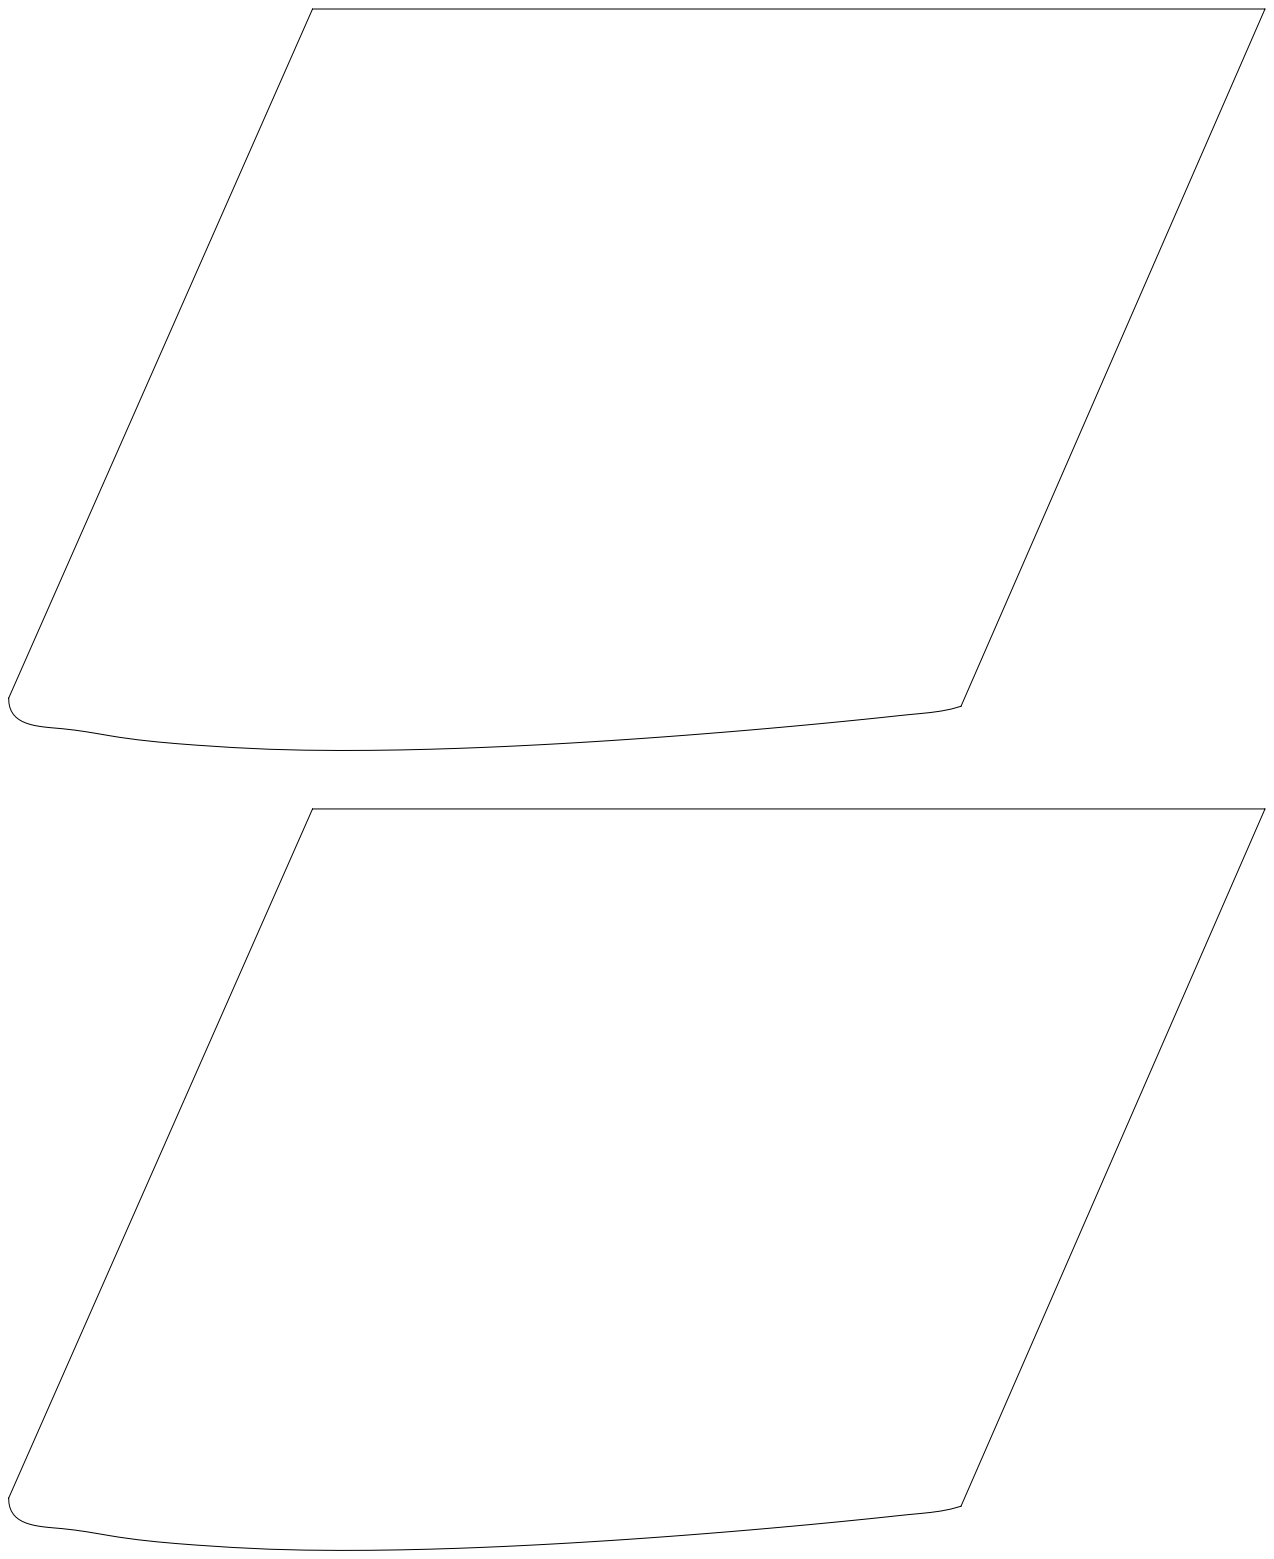
[picture p75: page 1]
