kenneth-tochihara/ae484/homeworks/homework6/manufacturing/motor_mount_drawing.pdf

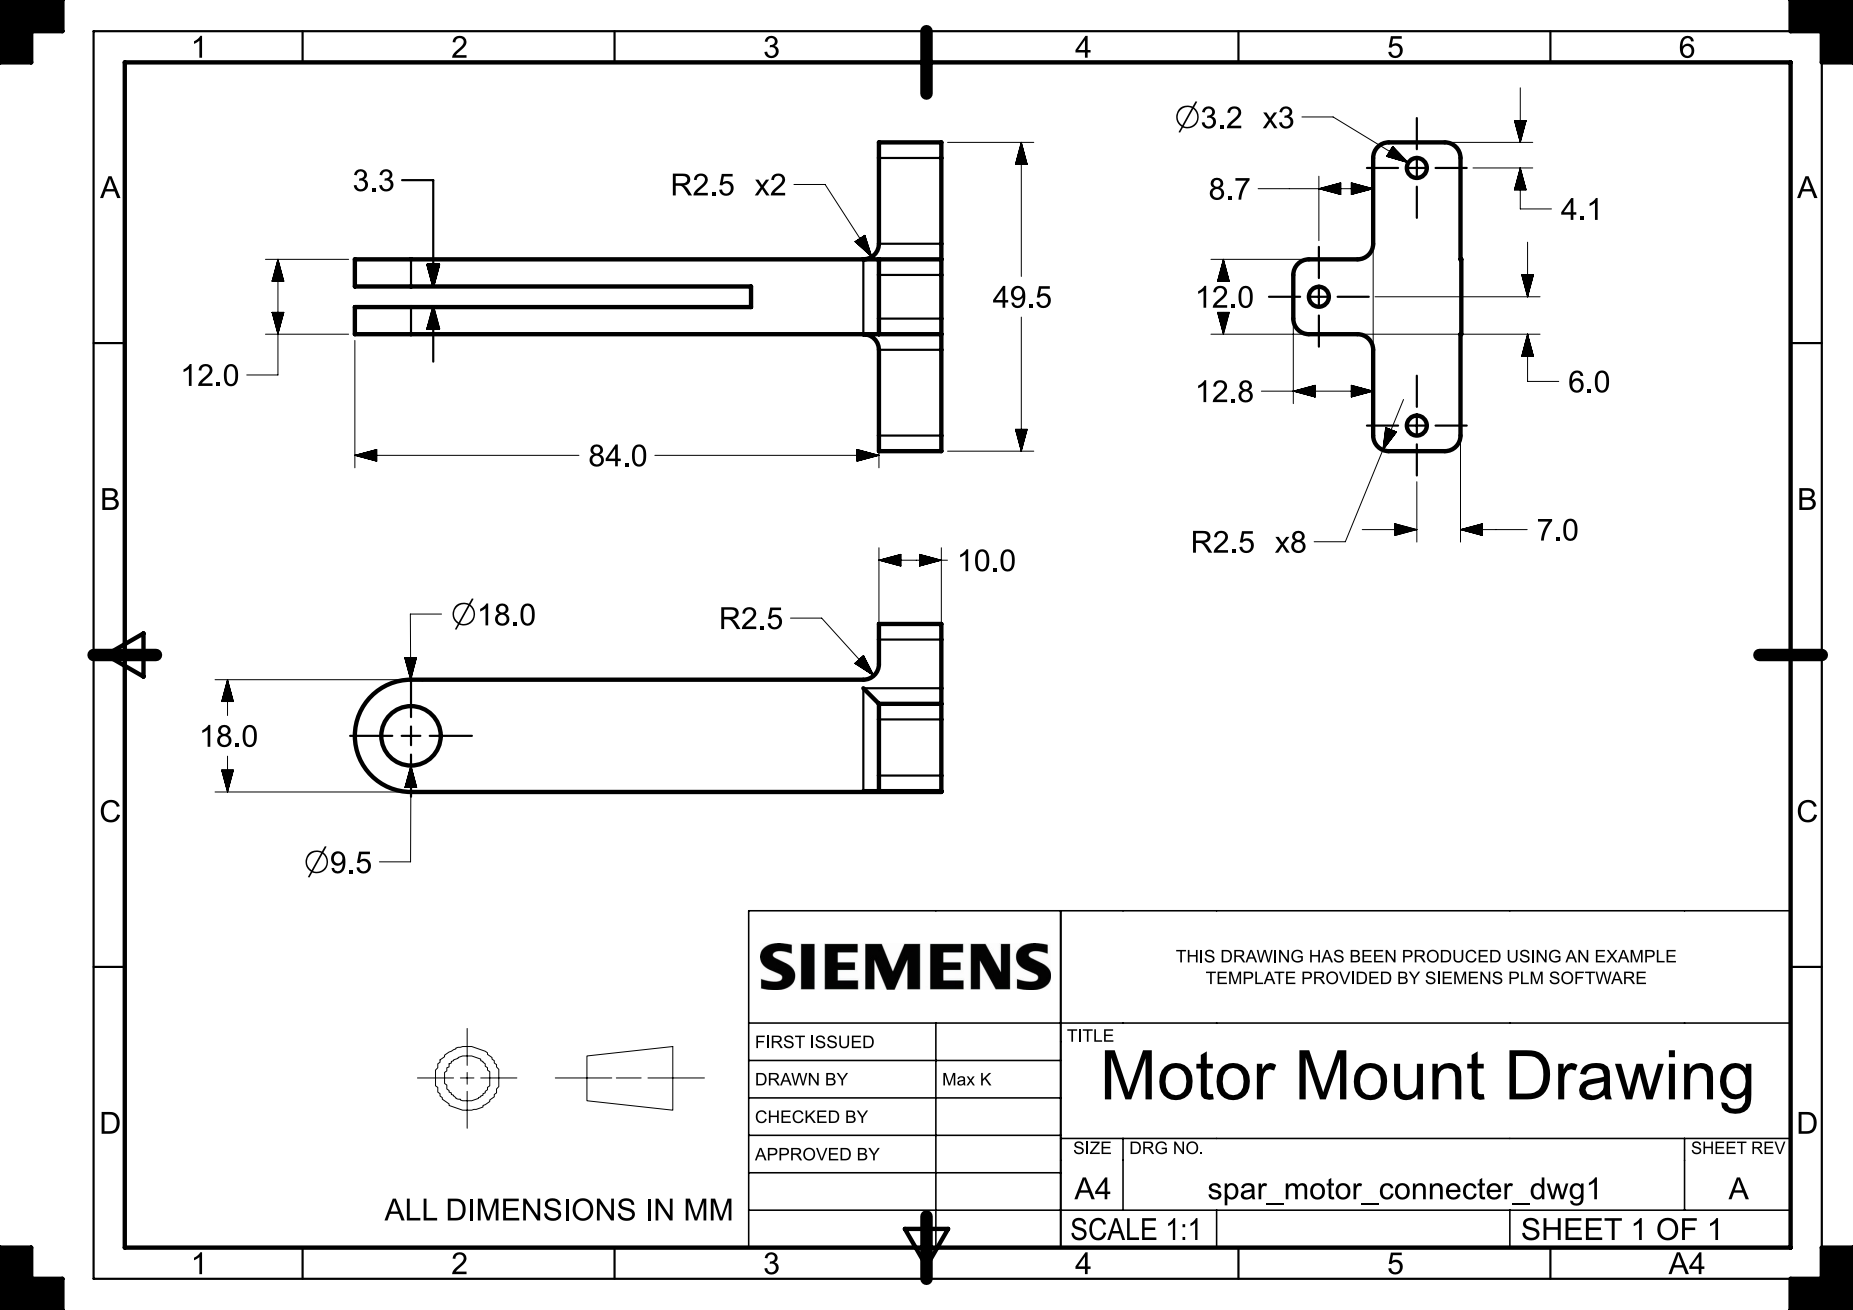
[picture p76: page 1]
