kenneth-tochihara/ae484/homeworks/homework6/manufacturing/elevon_mount_drawing.pdf

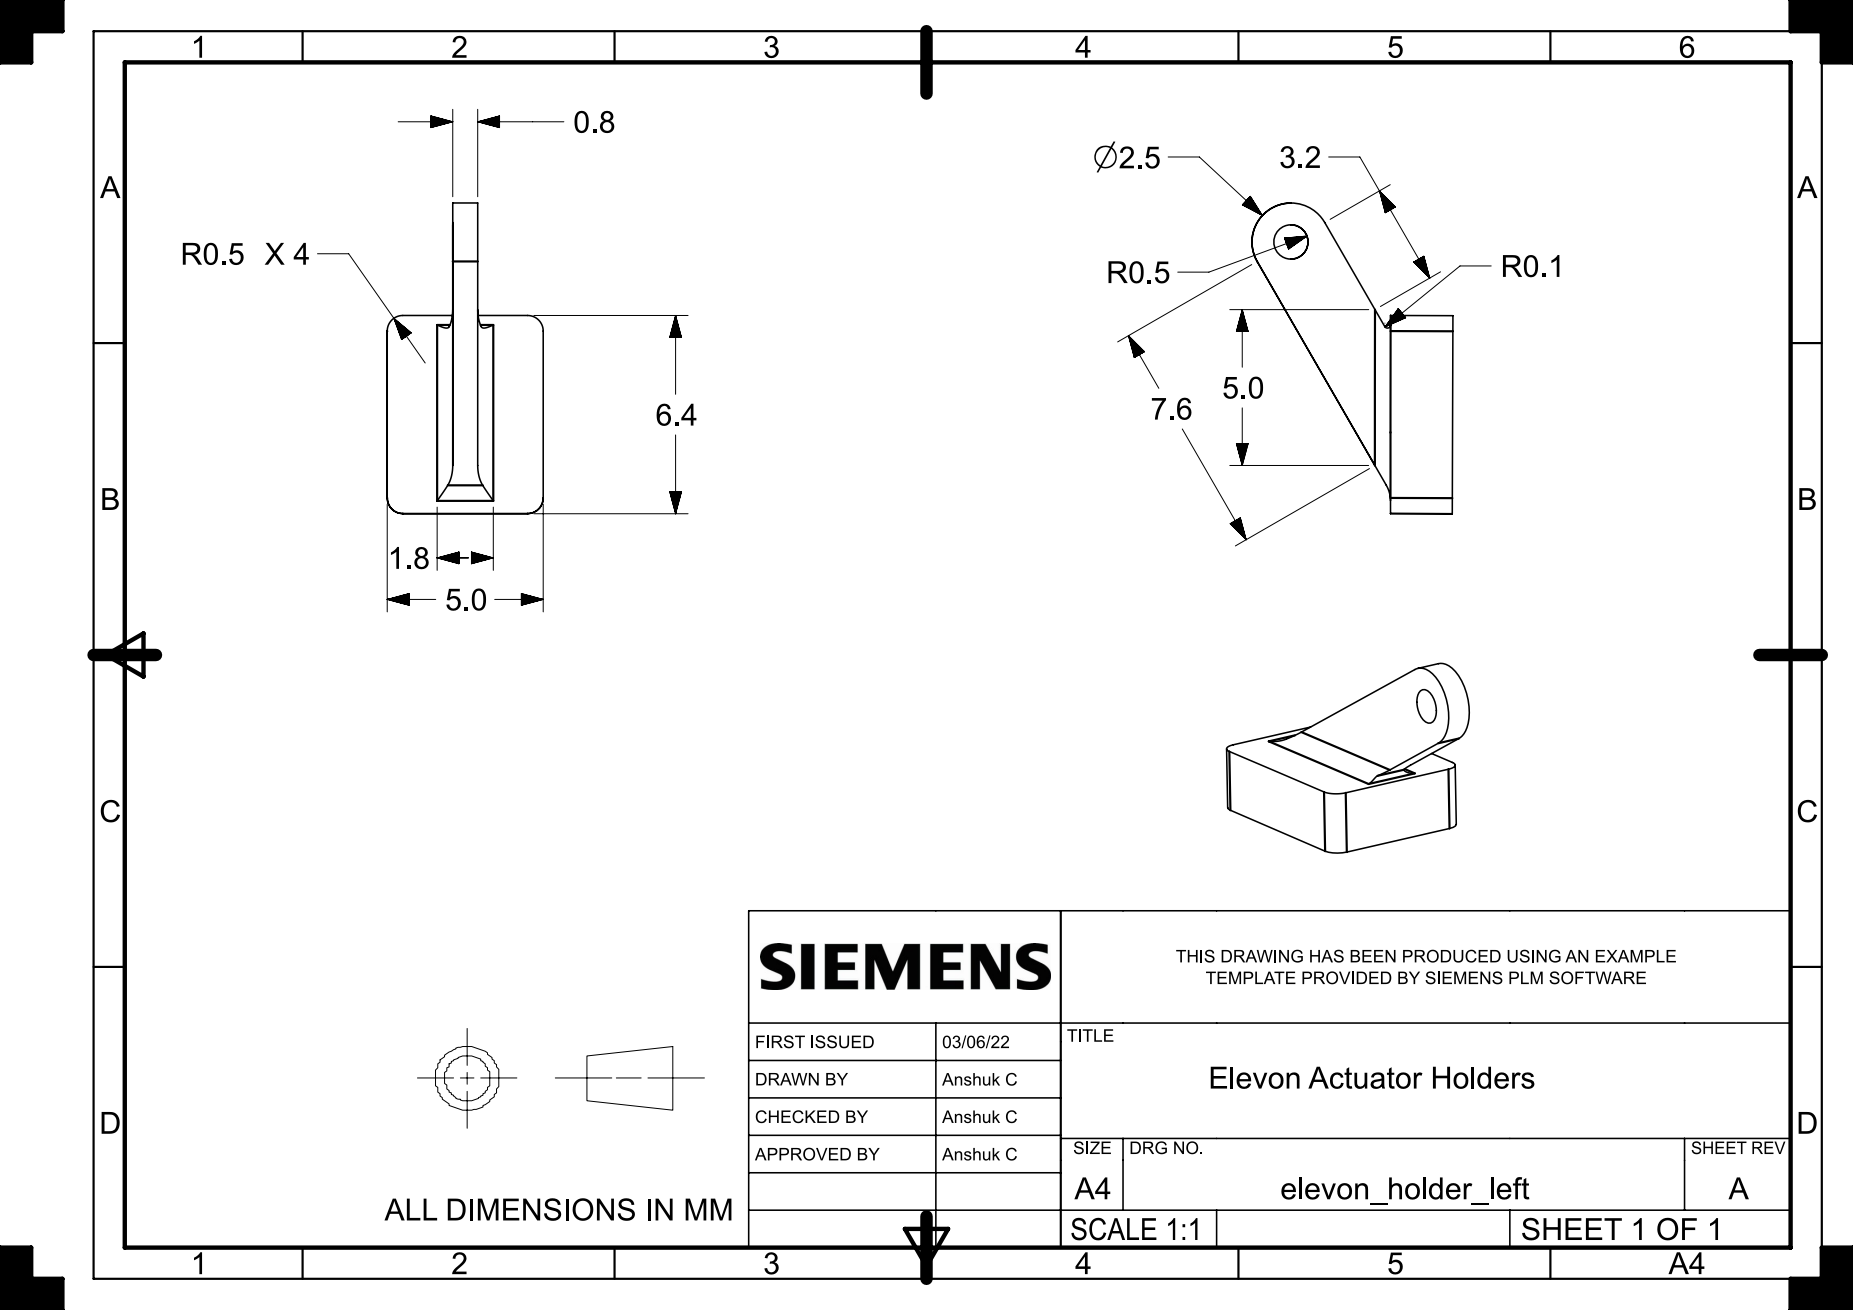
[picture p77: page 1]
