kenneth-tochihara/ae484/homeworks/homework6/manufacturing/trap_door_drawing.pdf

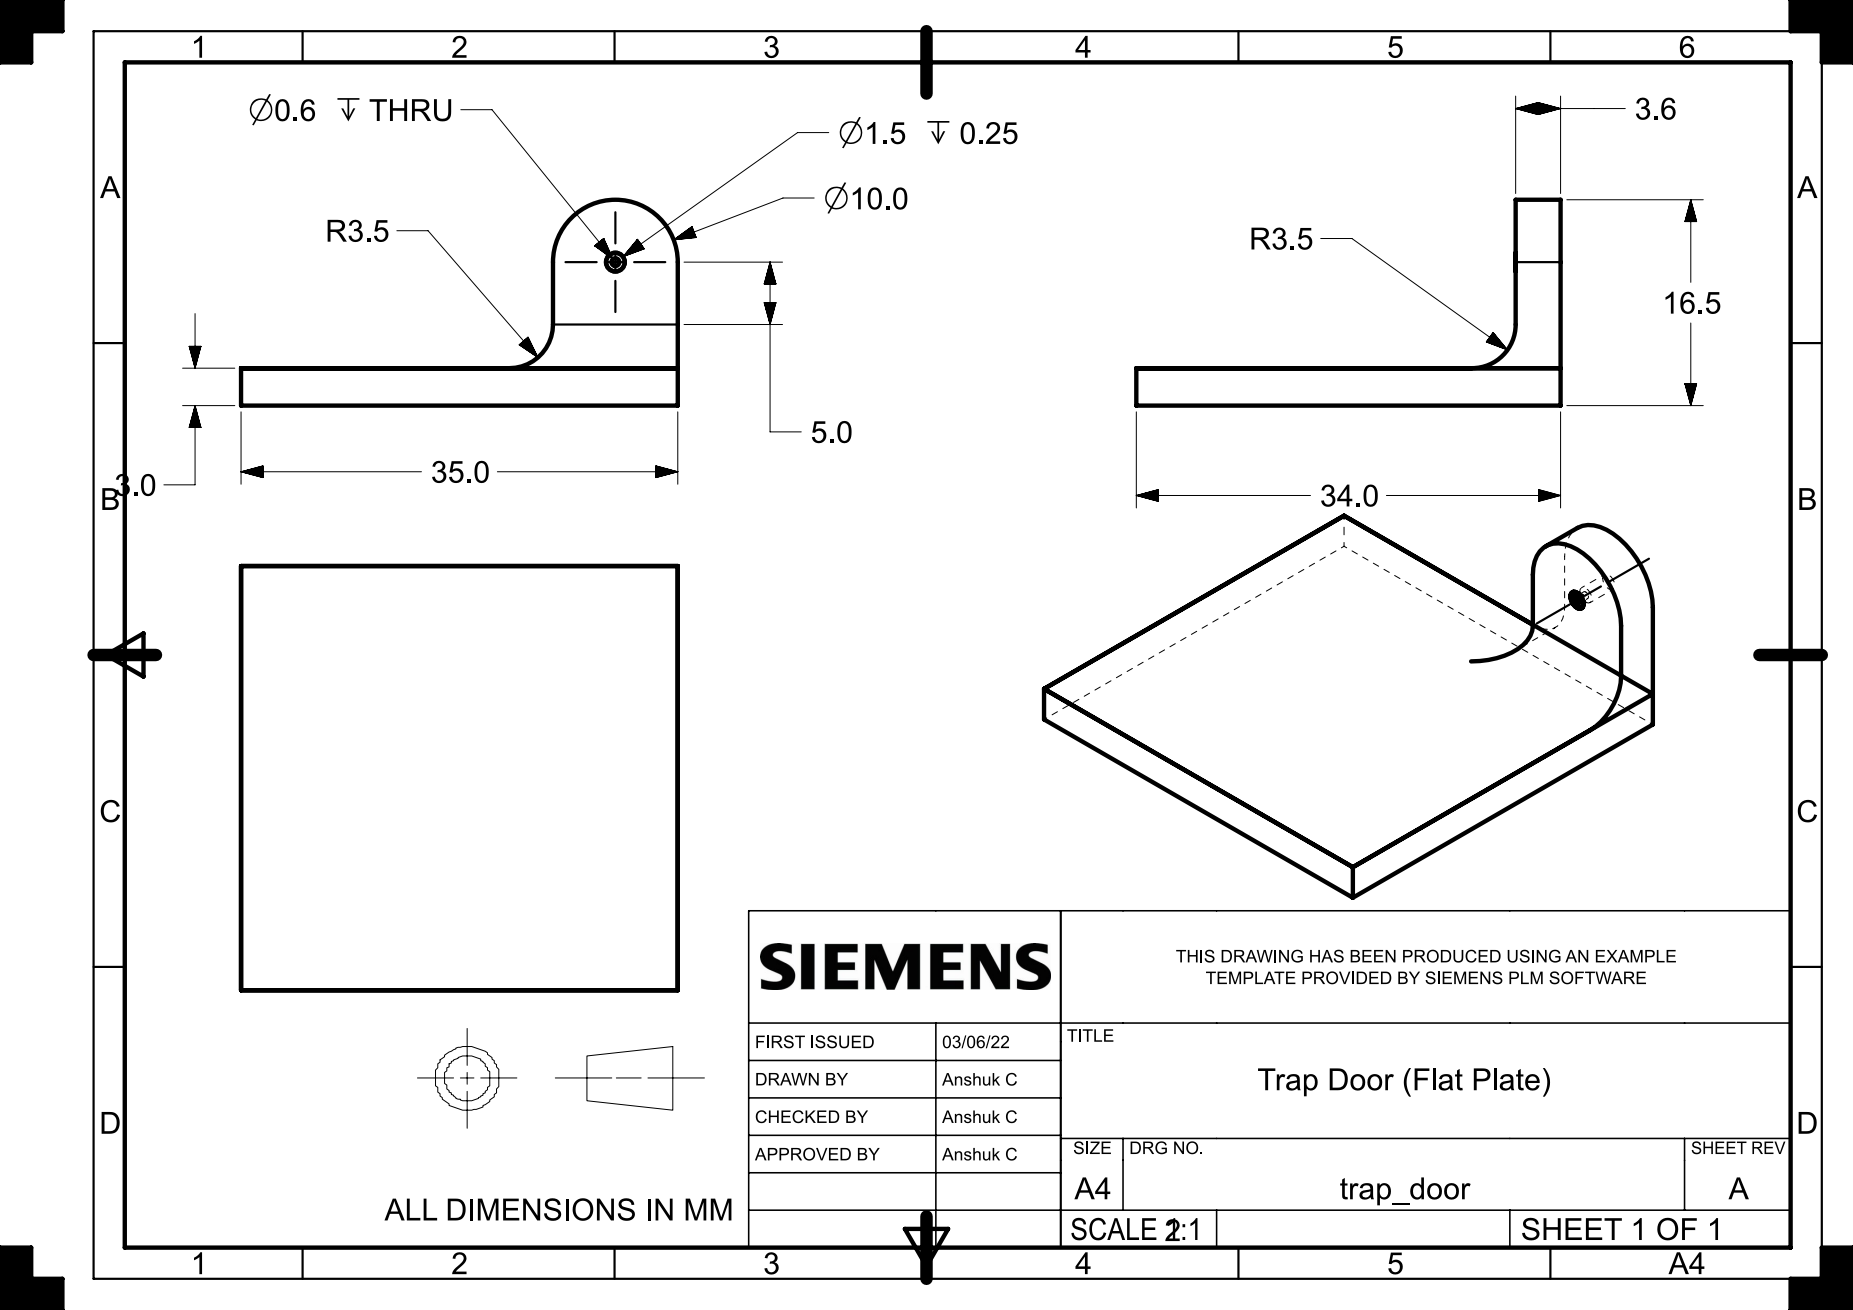
[picture p78: page 1]
