kenneth-tochihara/ae484/homeworks/homework4/report/Figure/anshukc2_aircraft_isometric_drawing.pdf

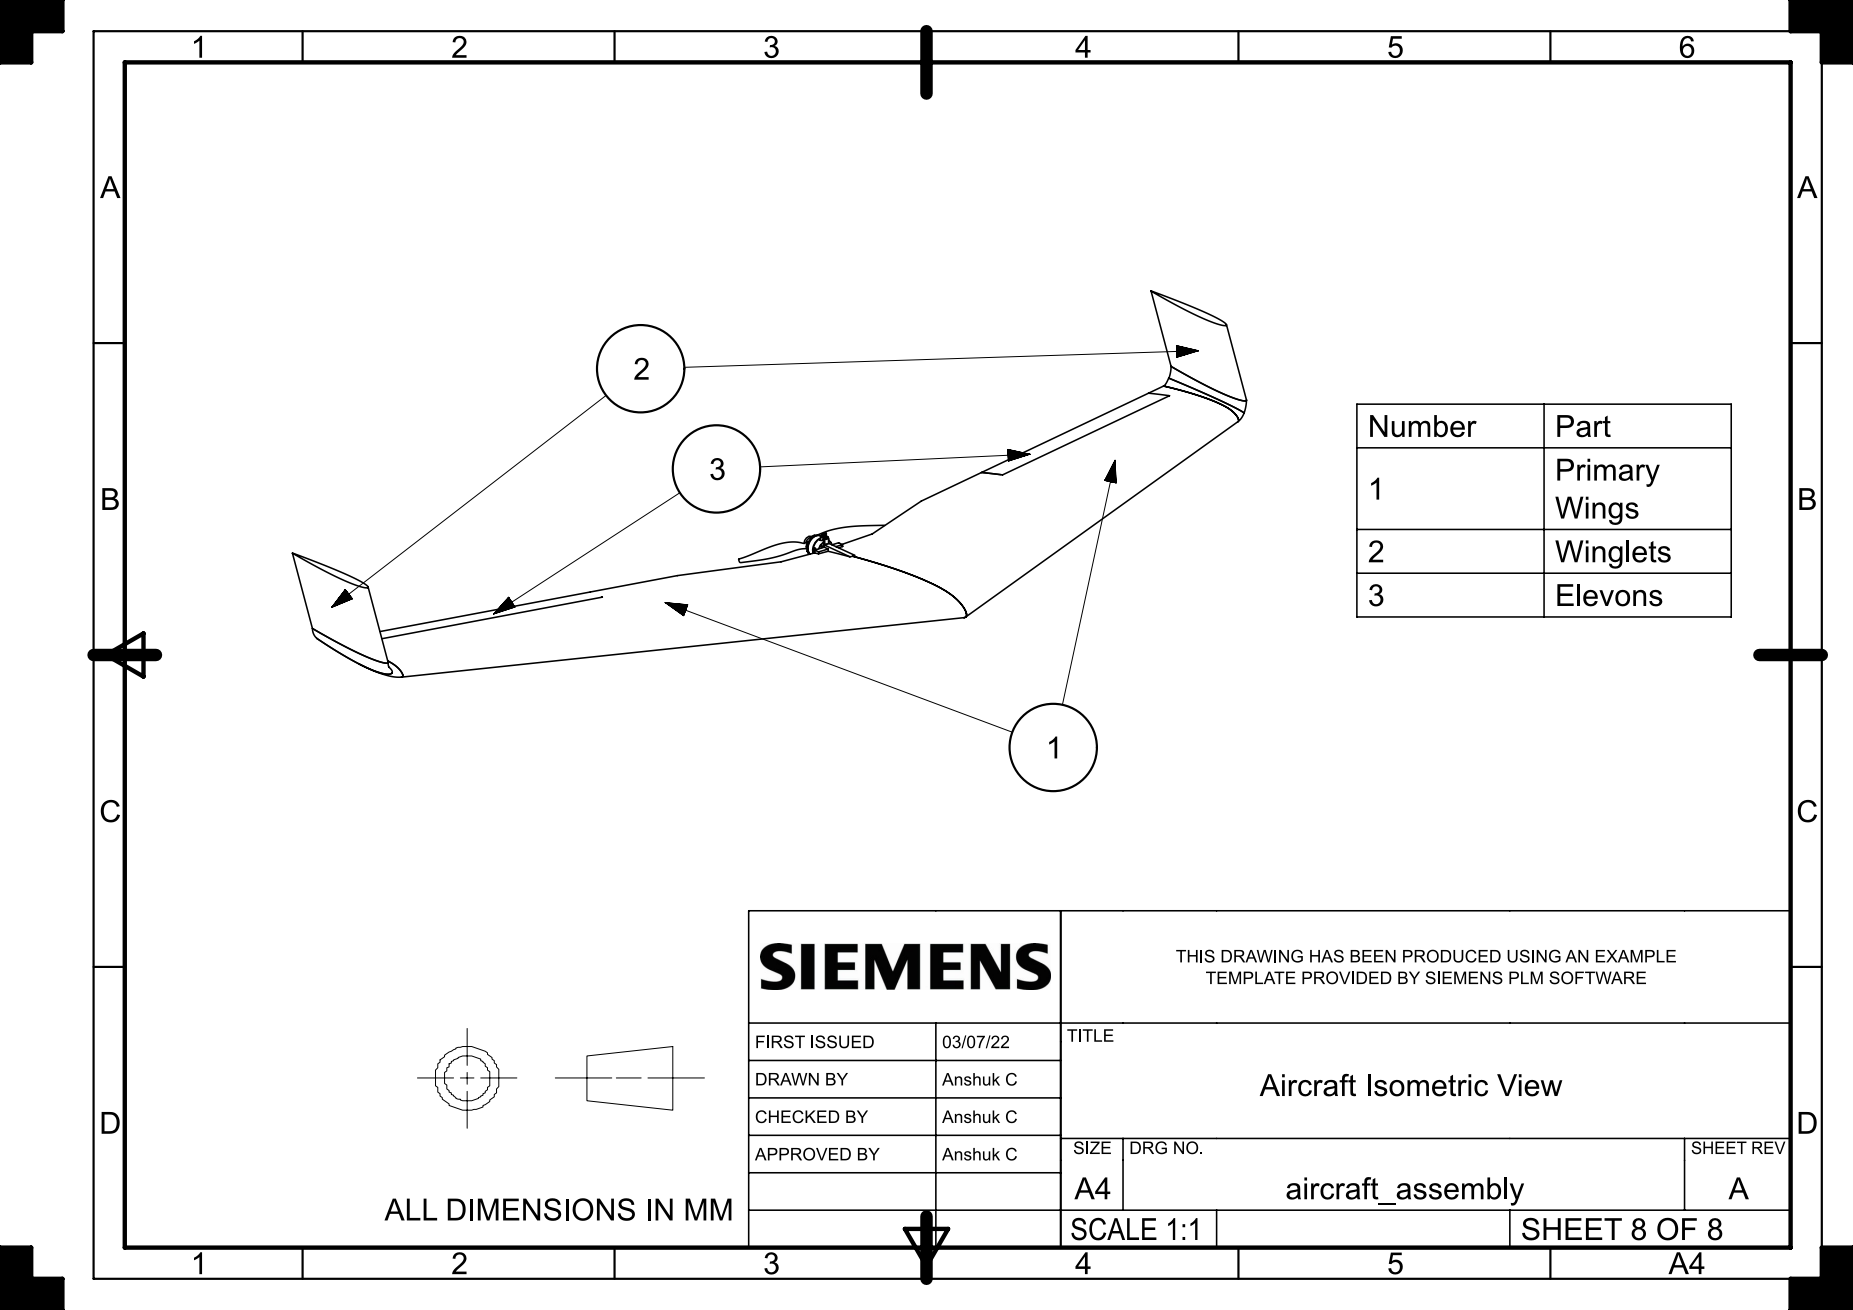
[picture p79: page 1]
