kenneth-tochihara/ae484/homeworks/homework4/report/Figure/anshukc2_aircraft_dimensions.pdf

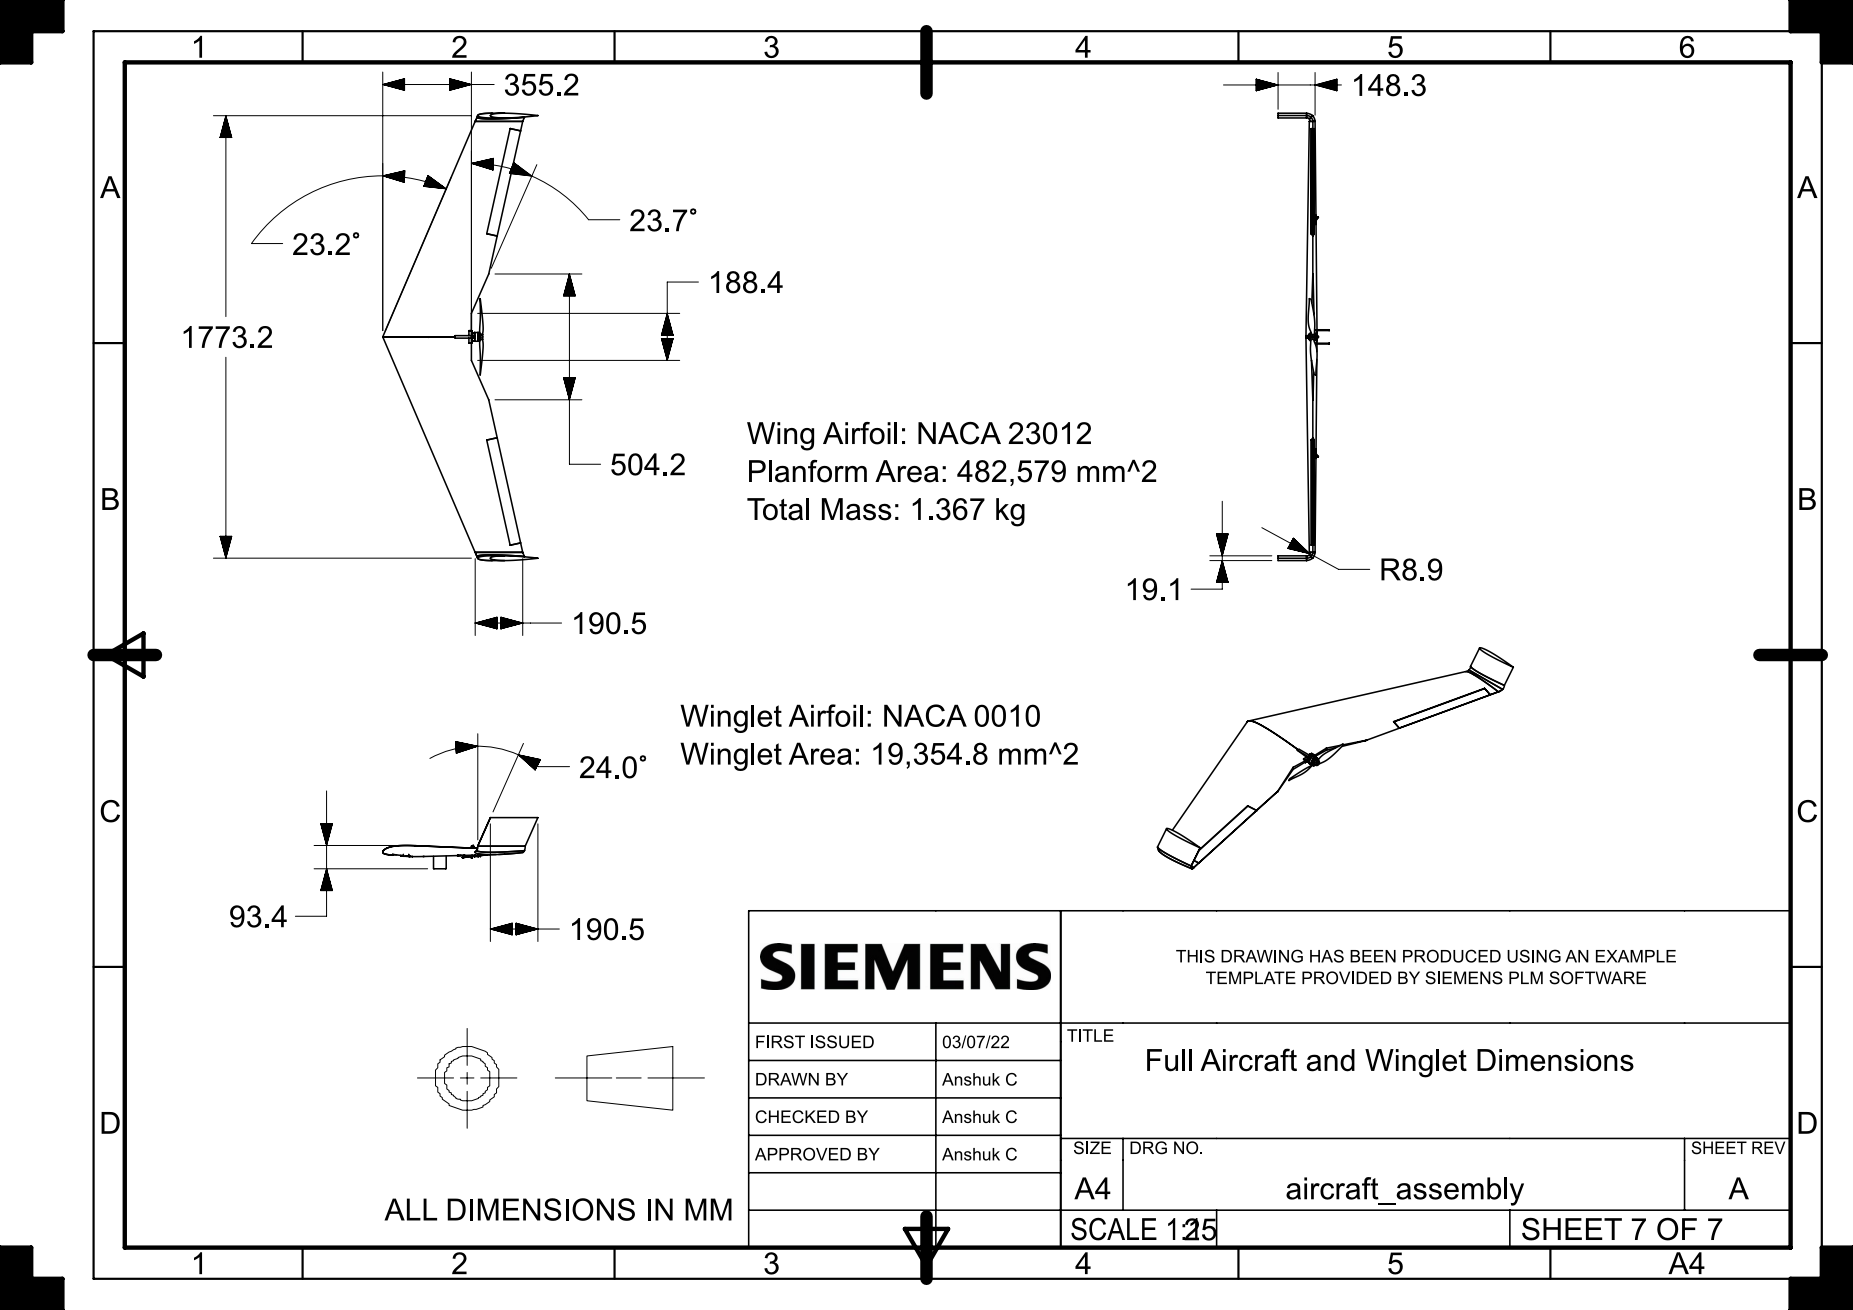
[picture p80: page 1]
