kenneth-tochihara/ae484/homeworks/homework4/report/Figure/hand_holds.pdf

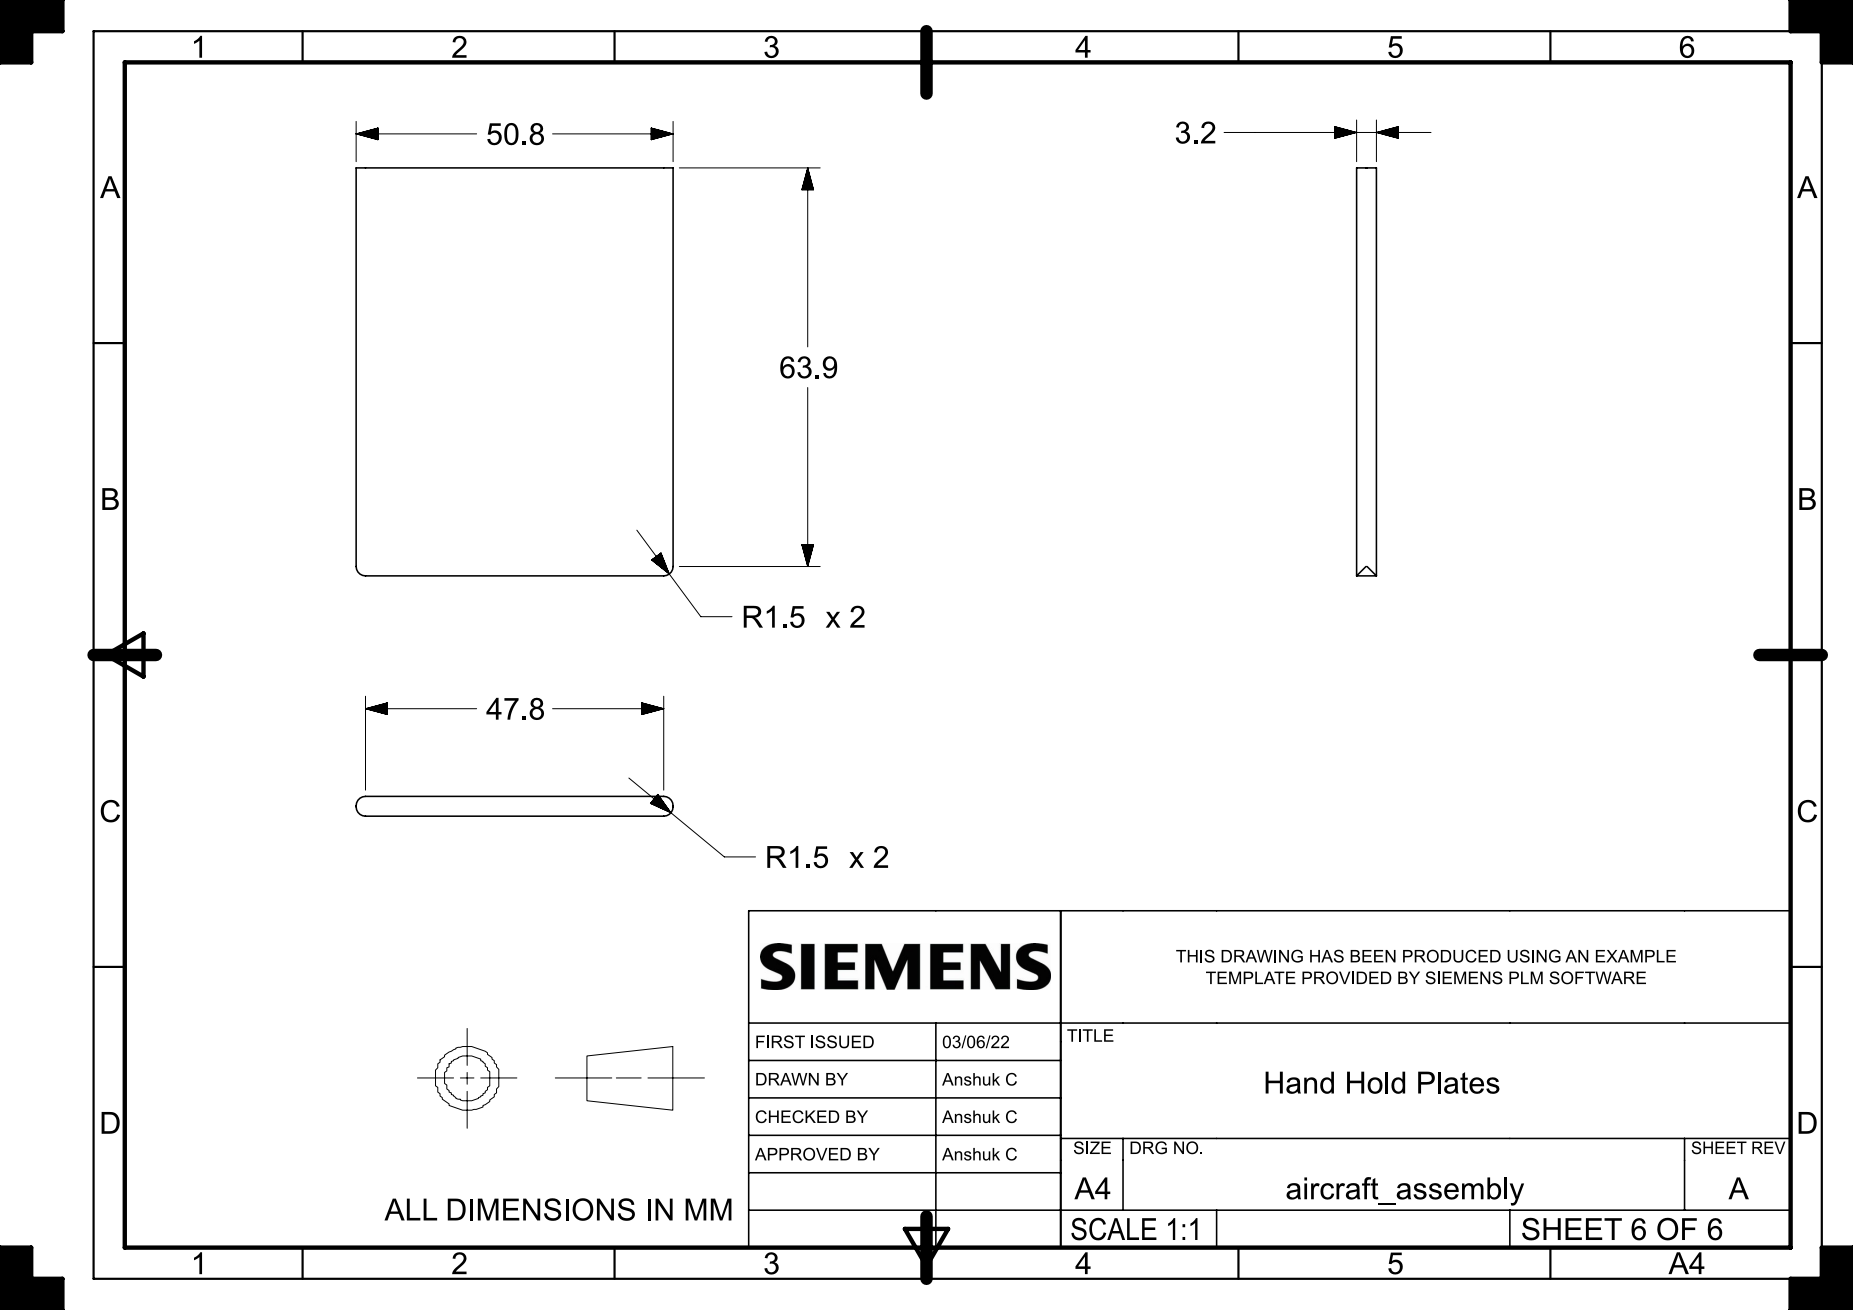
[picture p81: page 1]
