kenneth-tochihara/ae484/homeworks/homework4/report/Figure/motor_holder.pdf

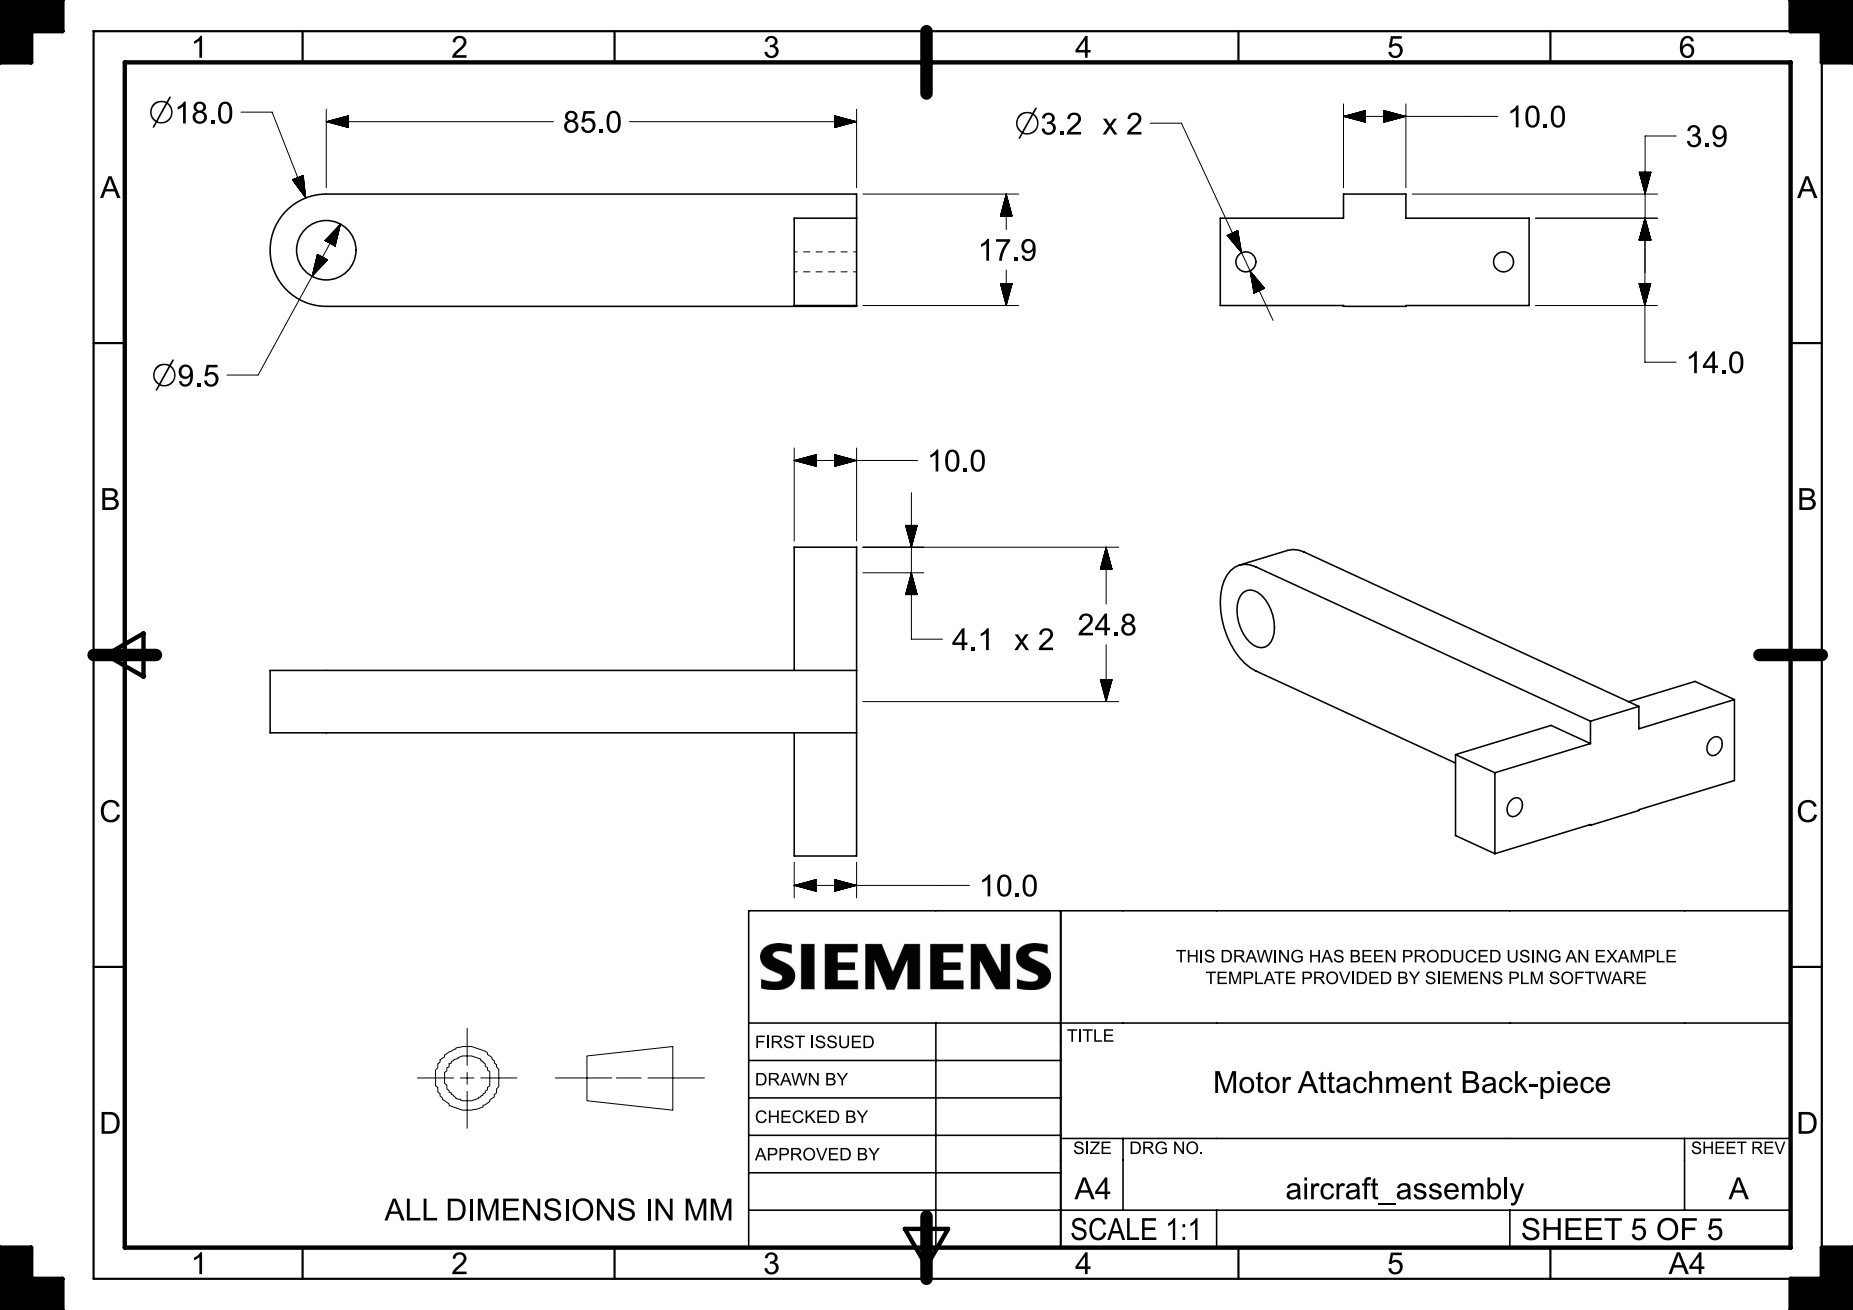
[picture p82: page 1]
