kenneth-tochihara/ae484/homeworks/homework4/report/Figure/electronics_cutouts.pdf

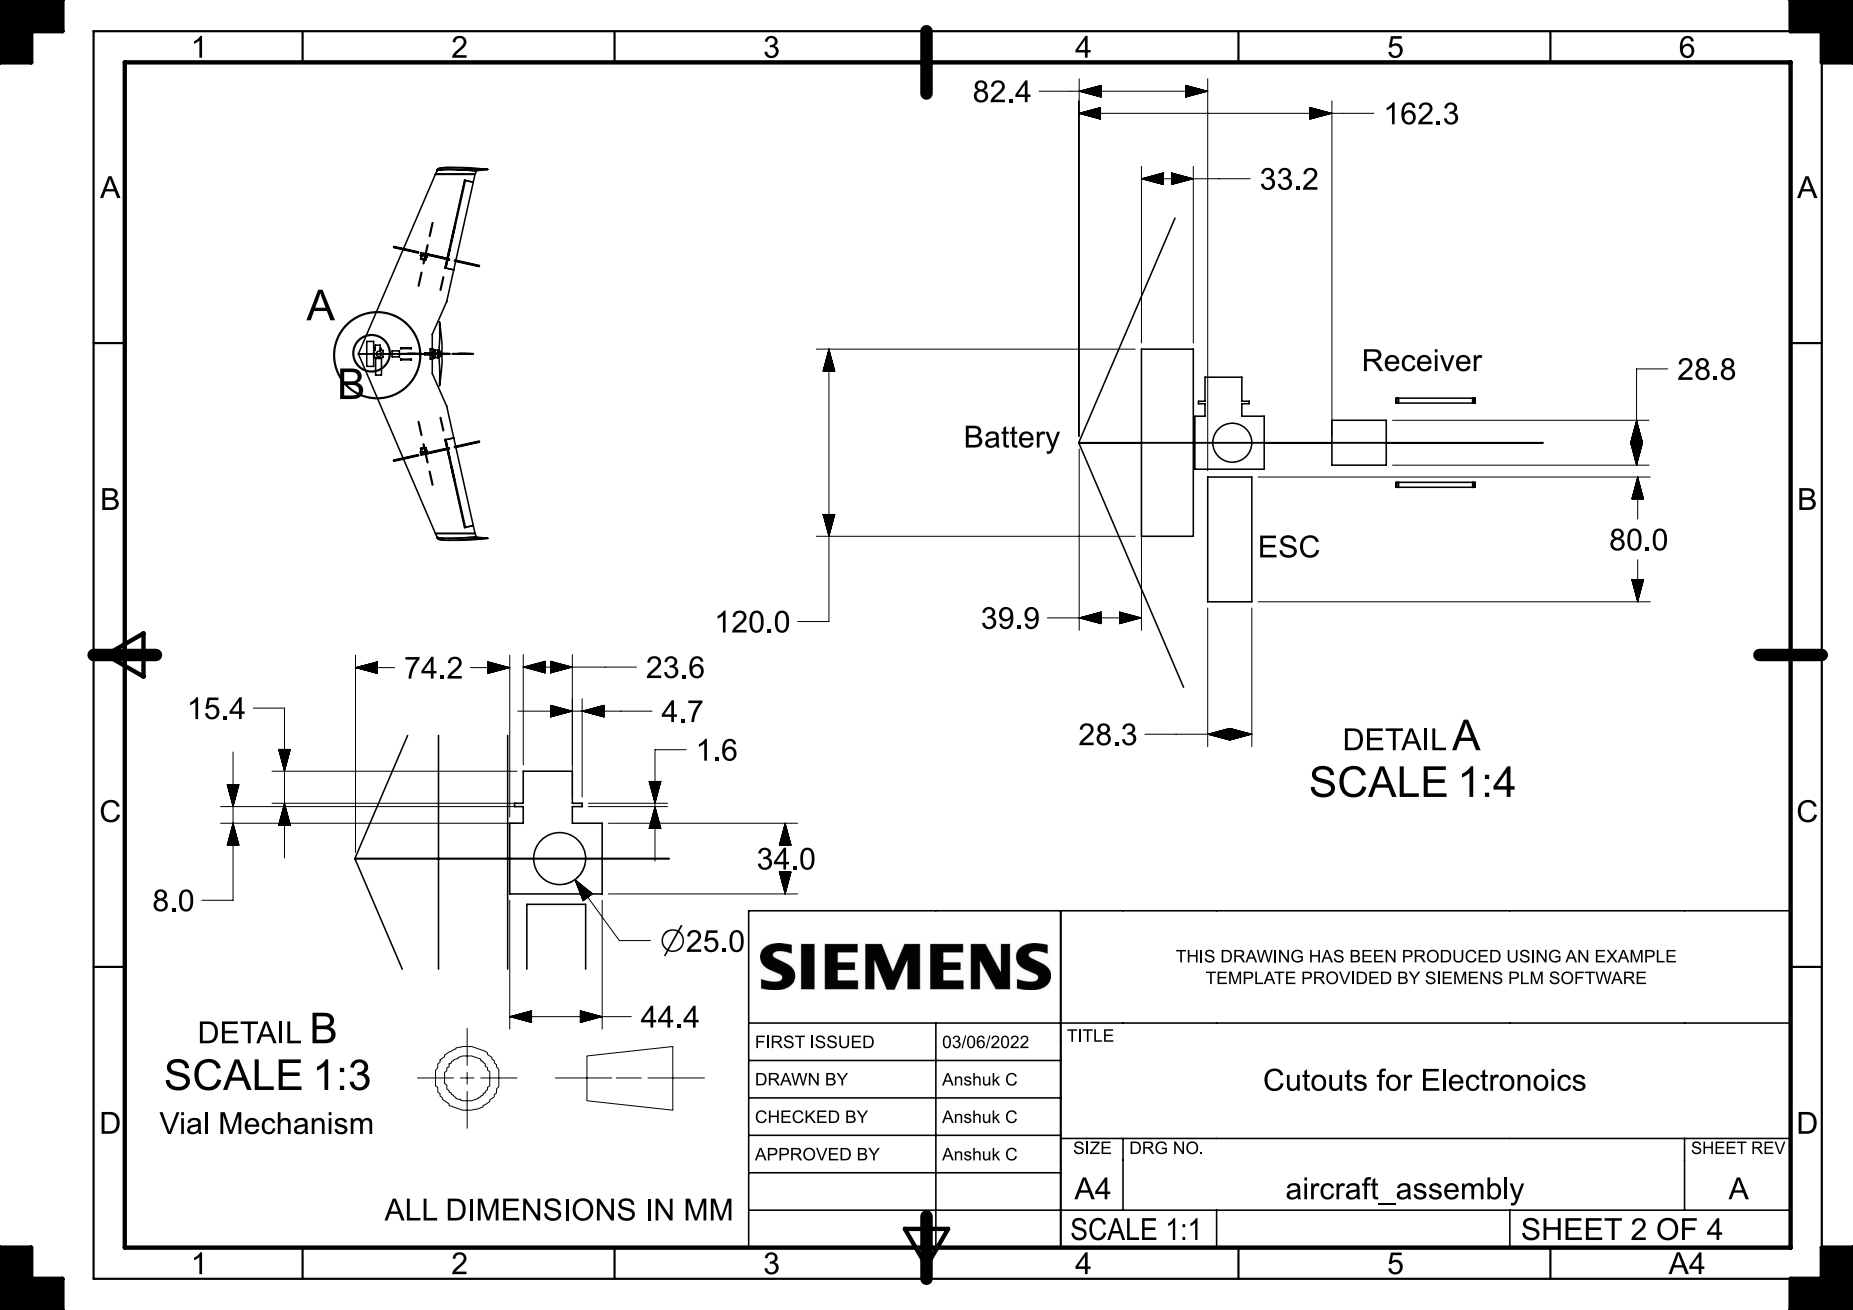
[picture p83: page 1]
