kenneth-tochihara/ae484/homeworks/homework4/report/Figure/elevons_servos.pdf

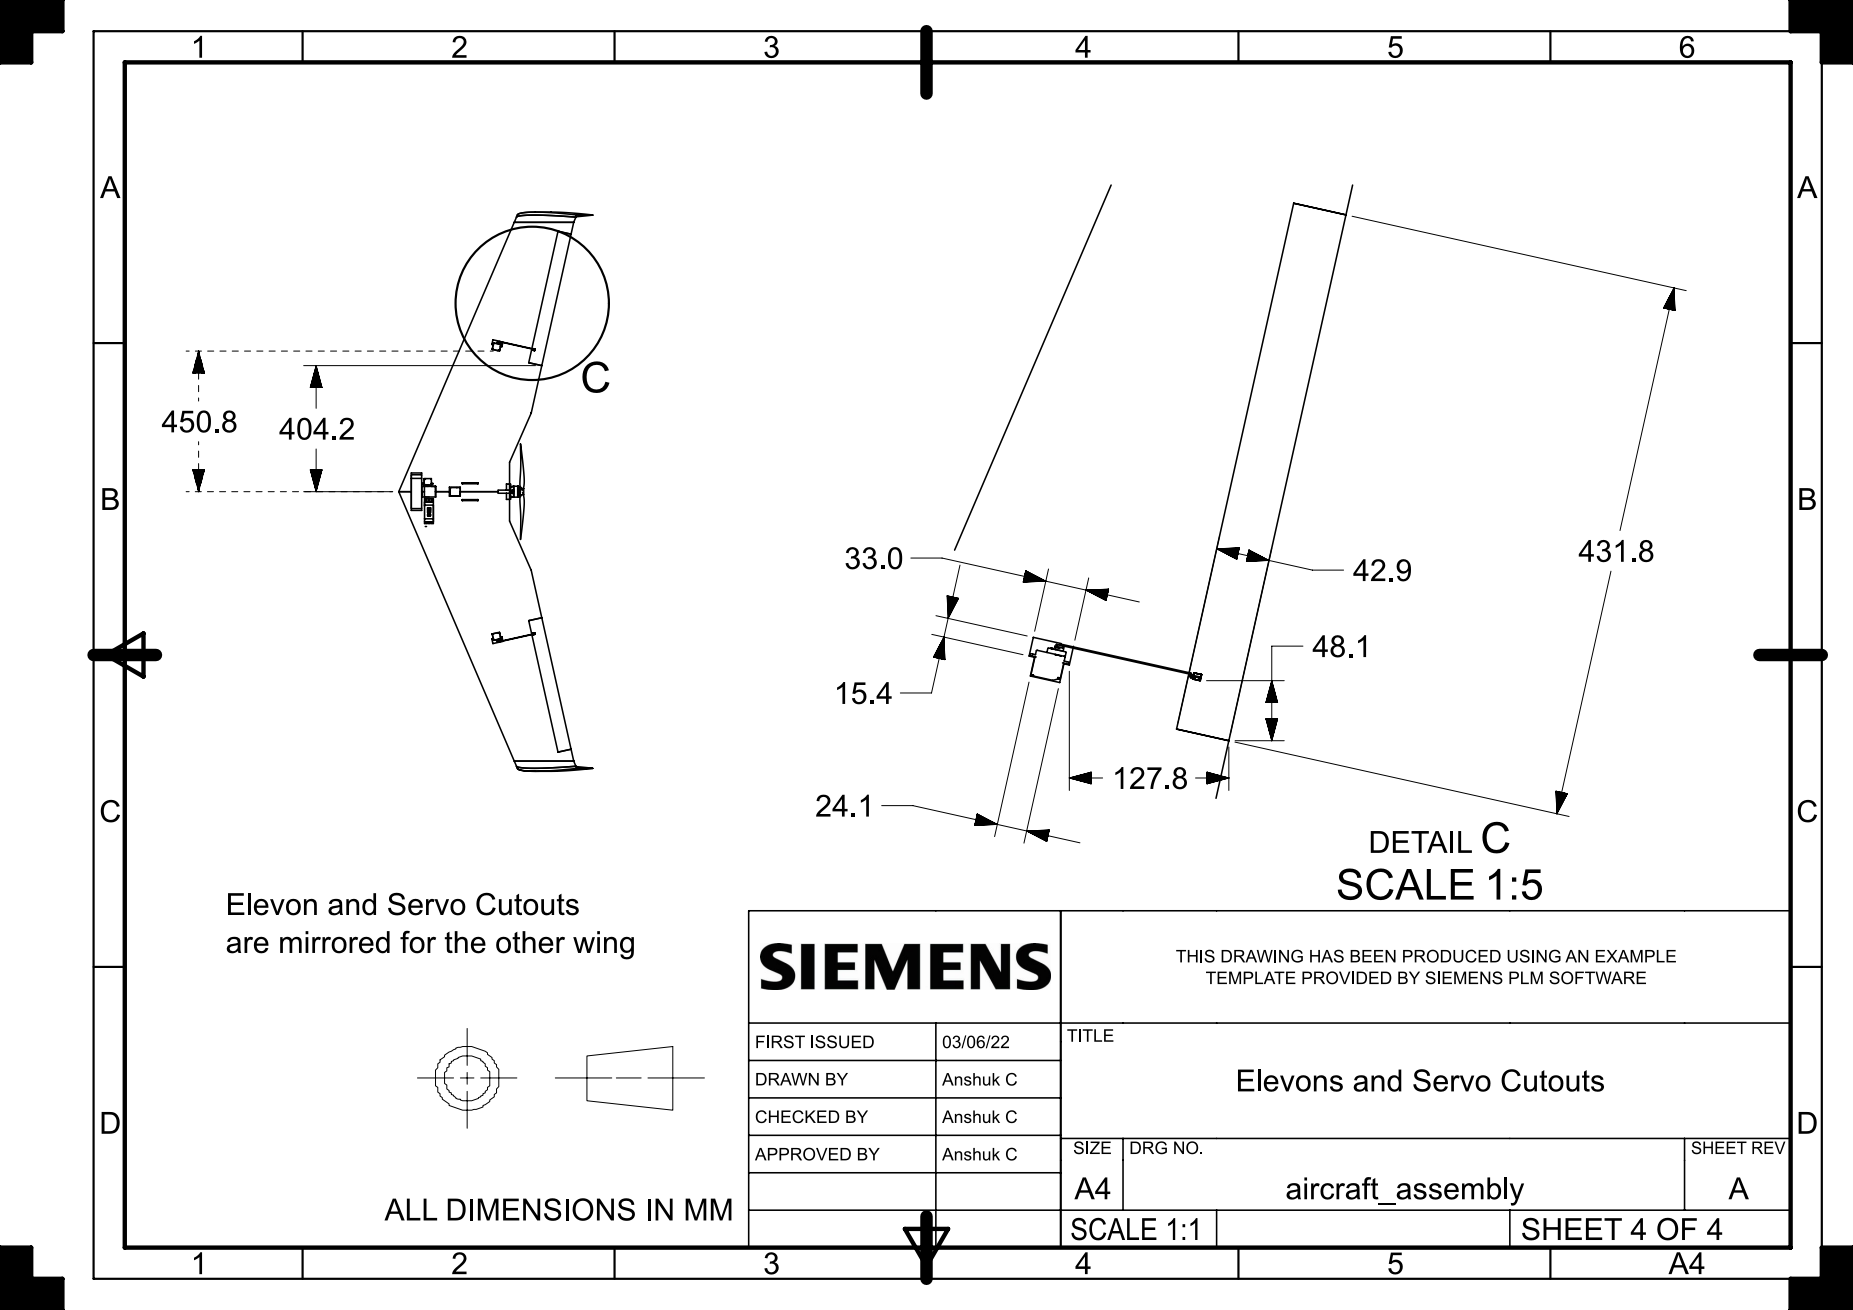
[picture p84: page 1]
