kenneth-tochihara/ae484/homeworks/homework4/report/Figure/wing_depths_spar_cutouts.pdf

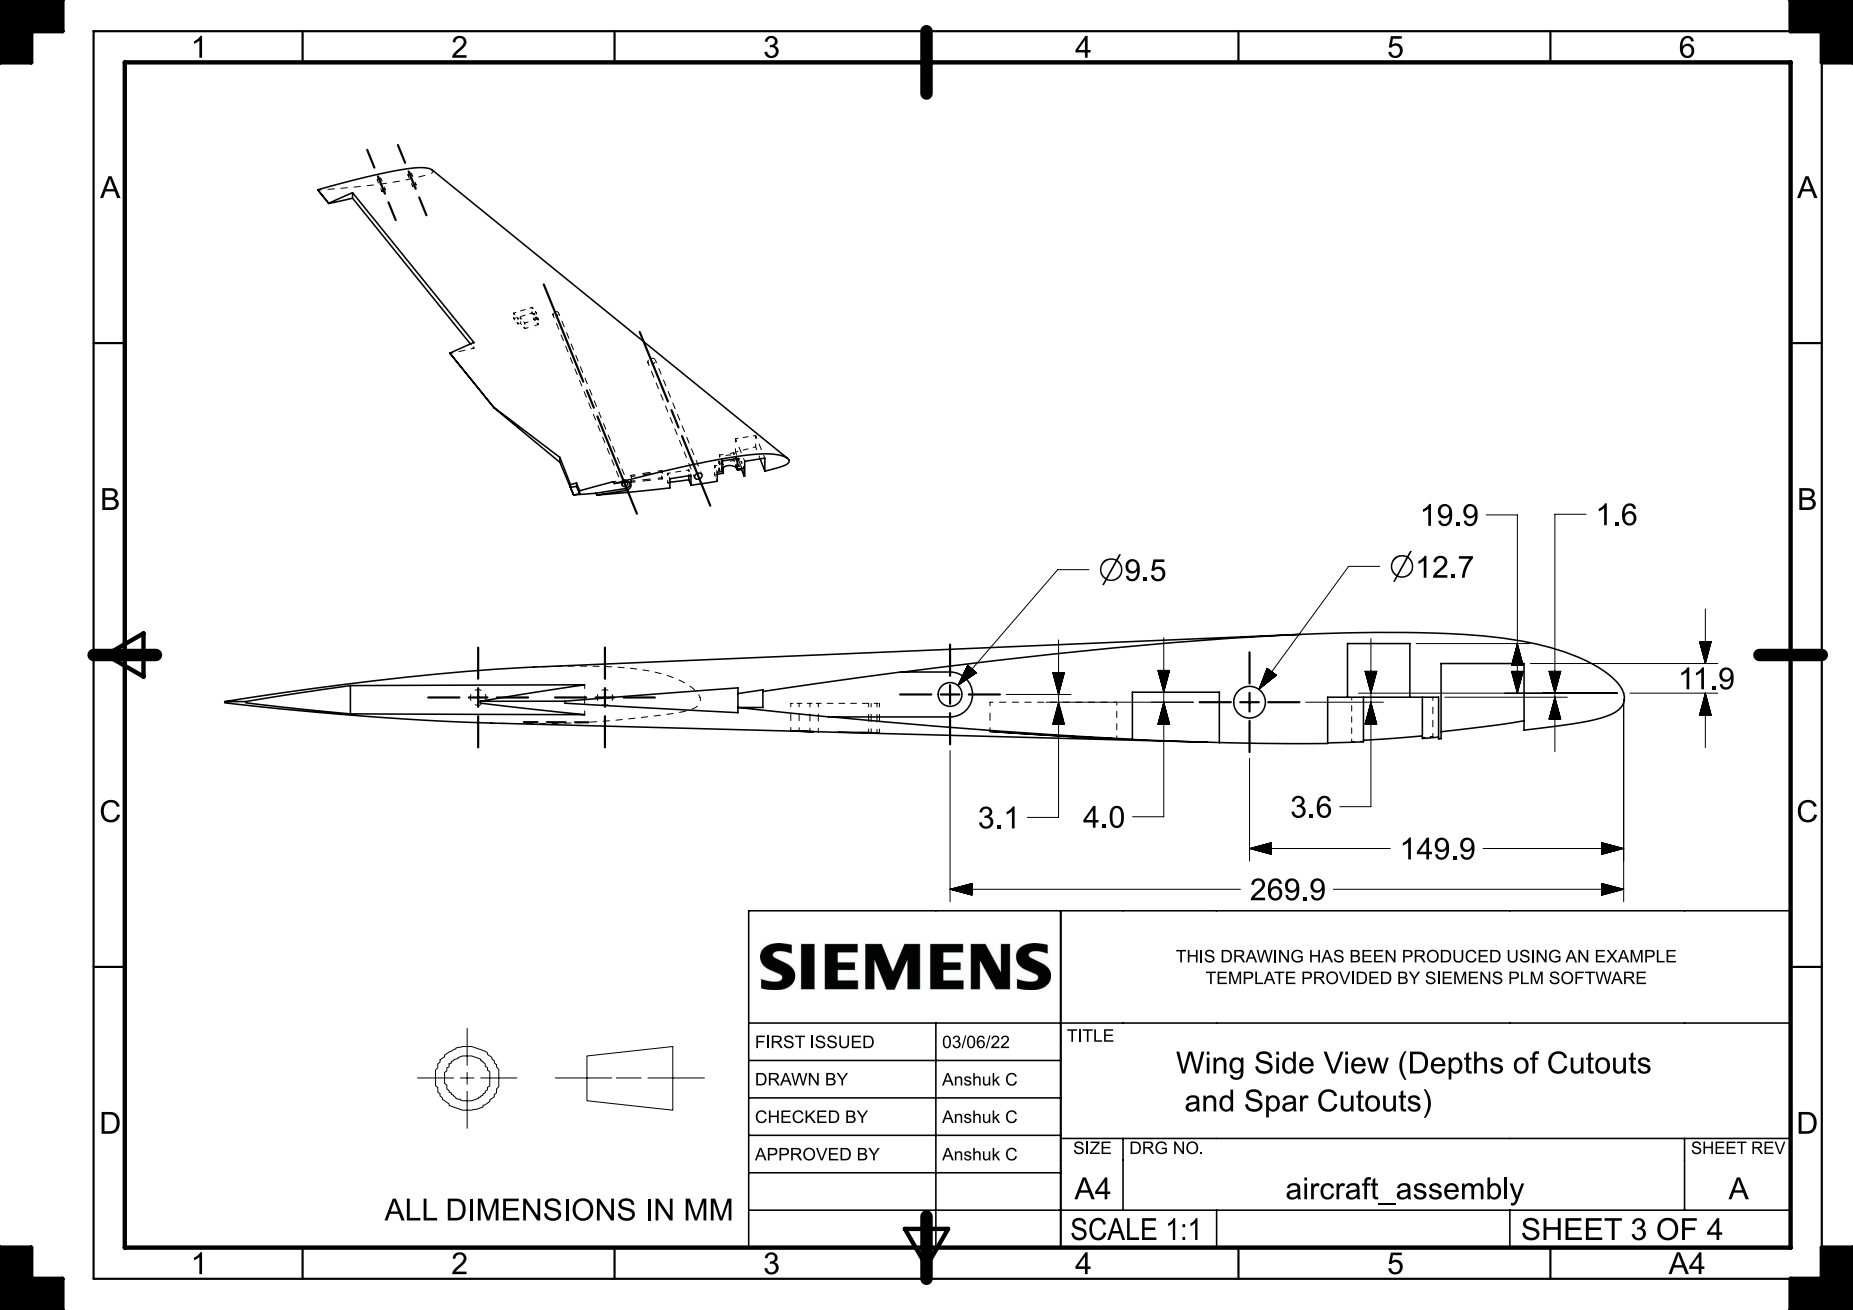
[picture p85: page 1]
