kenneth-tochihara/ae484/homeworks/homework4/report/Figure/ktt3_aircraft_assembly_component_locations.pdf

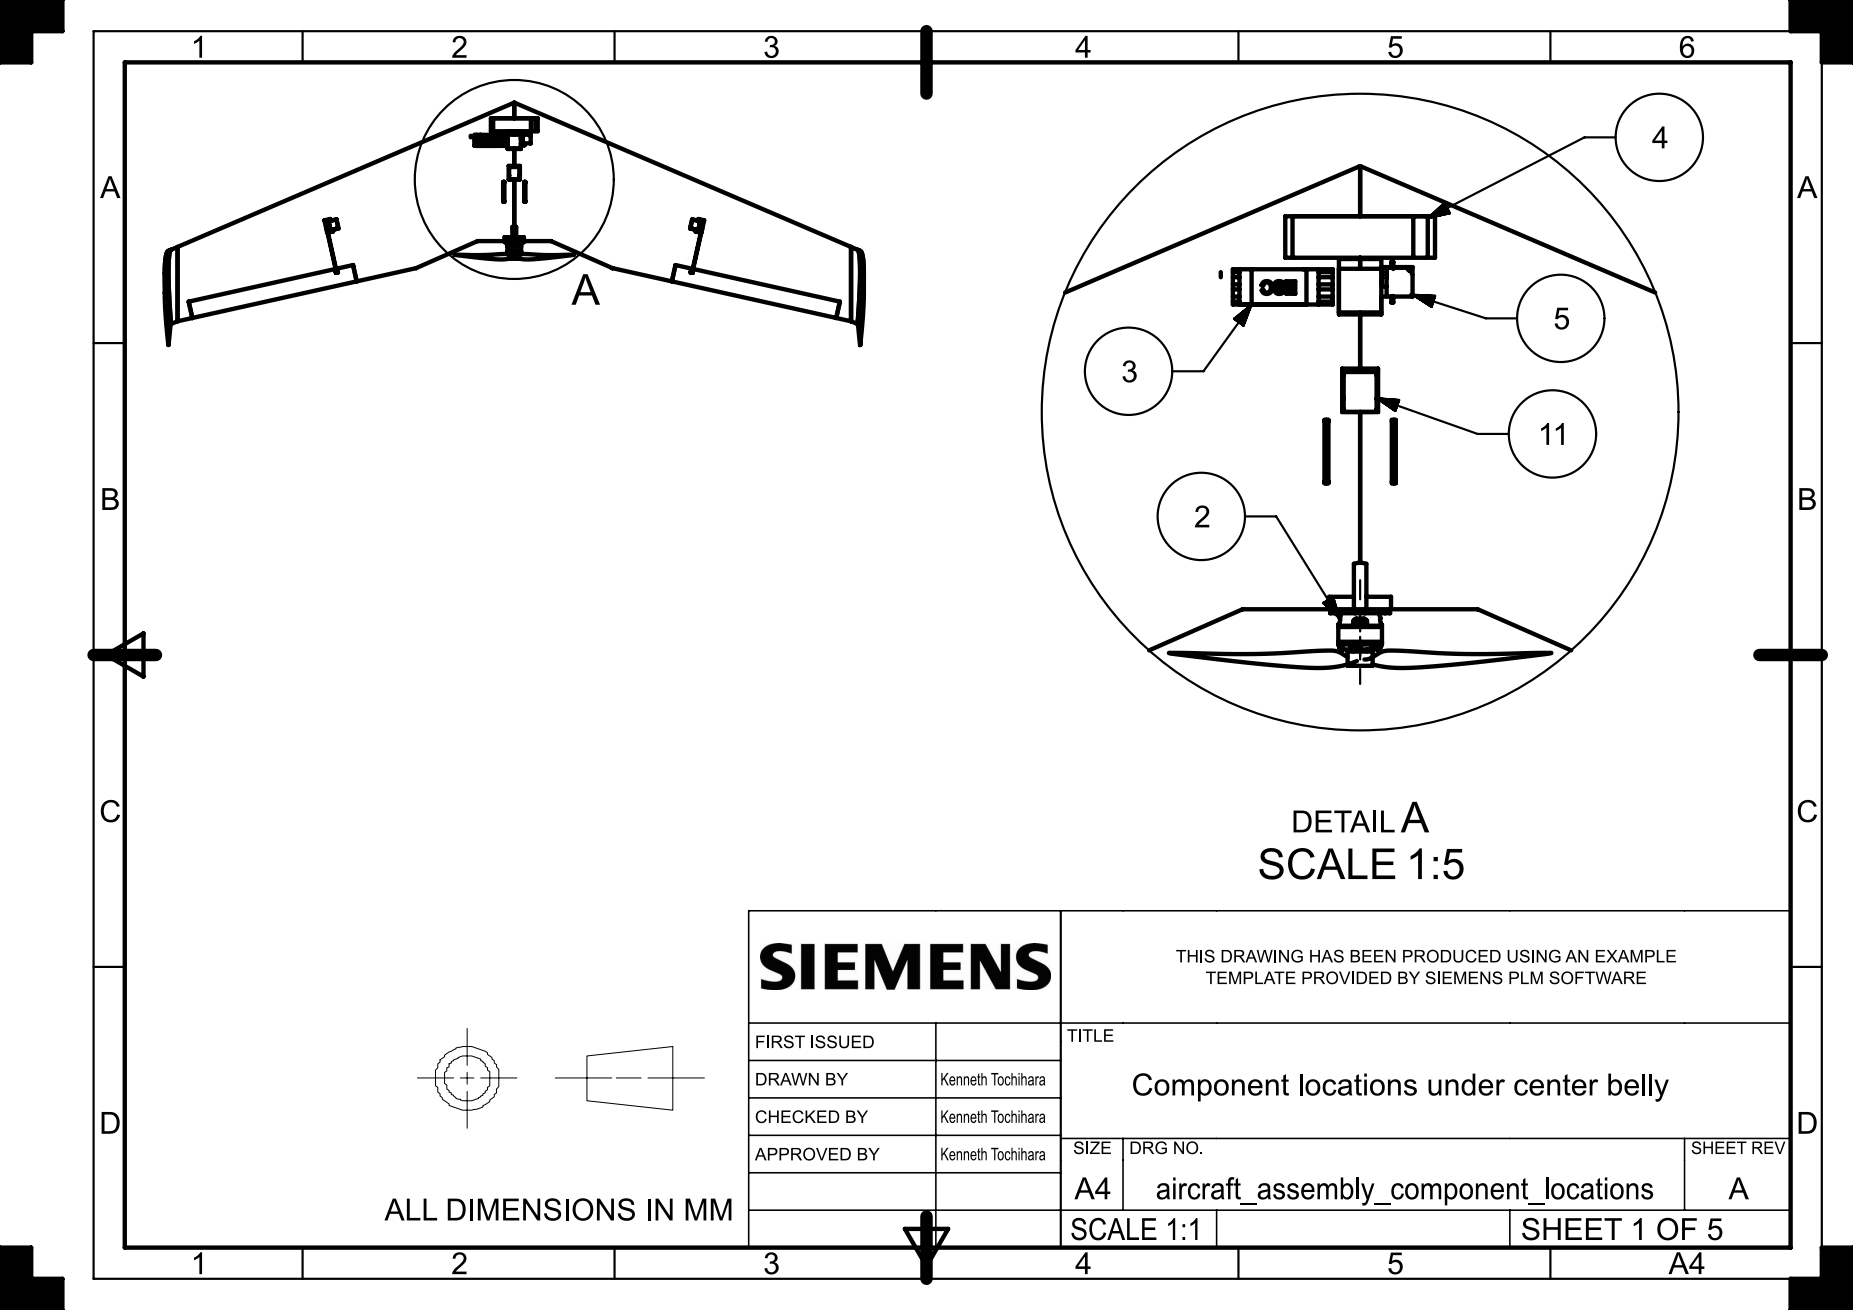
[picture p86: page 1]

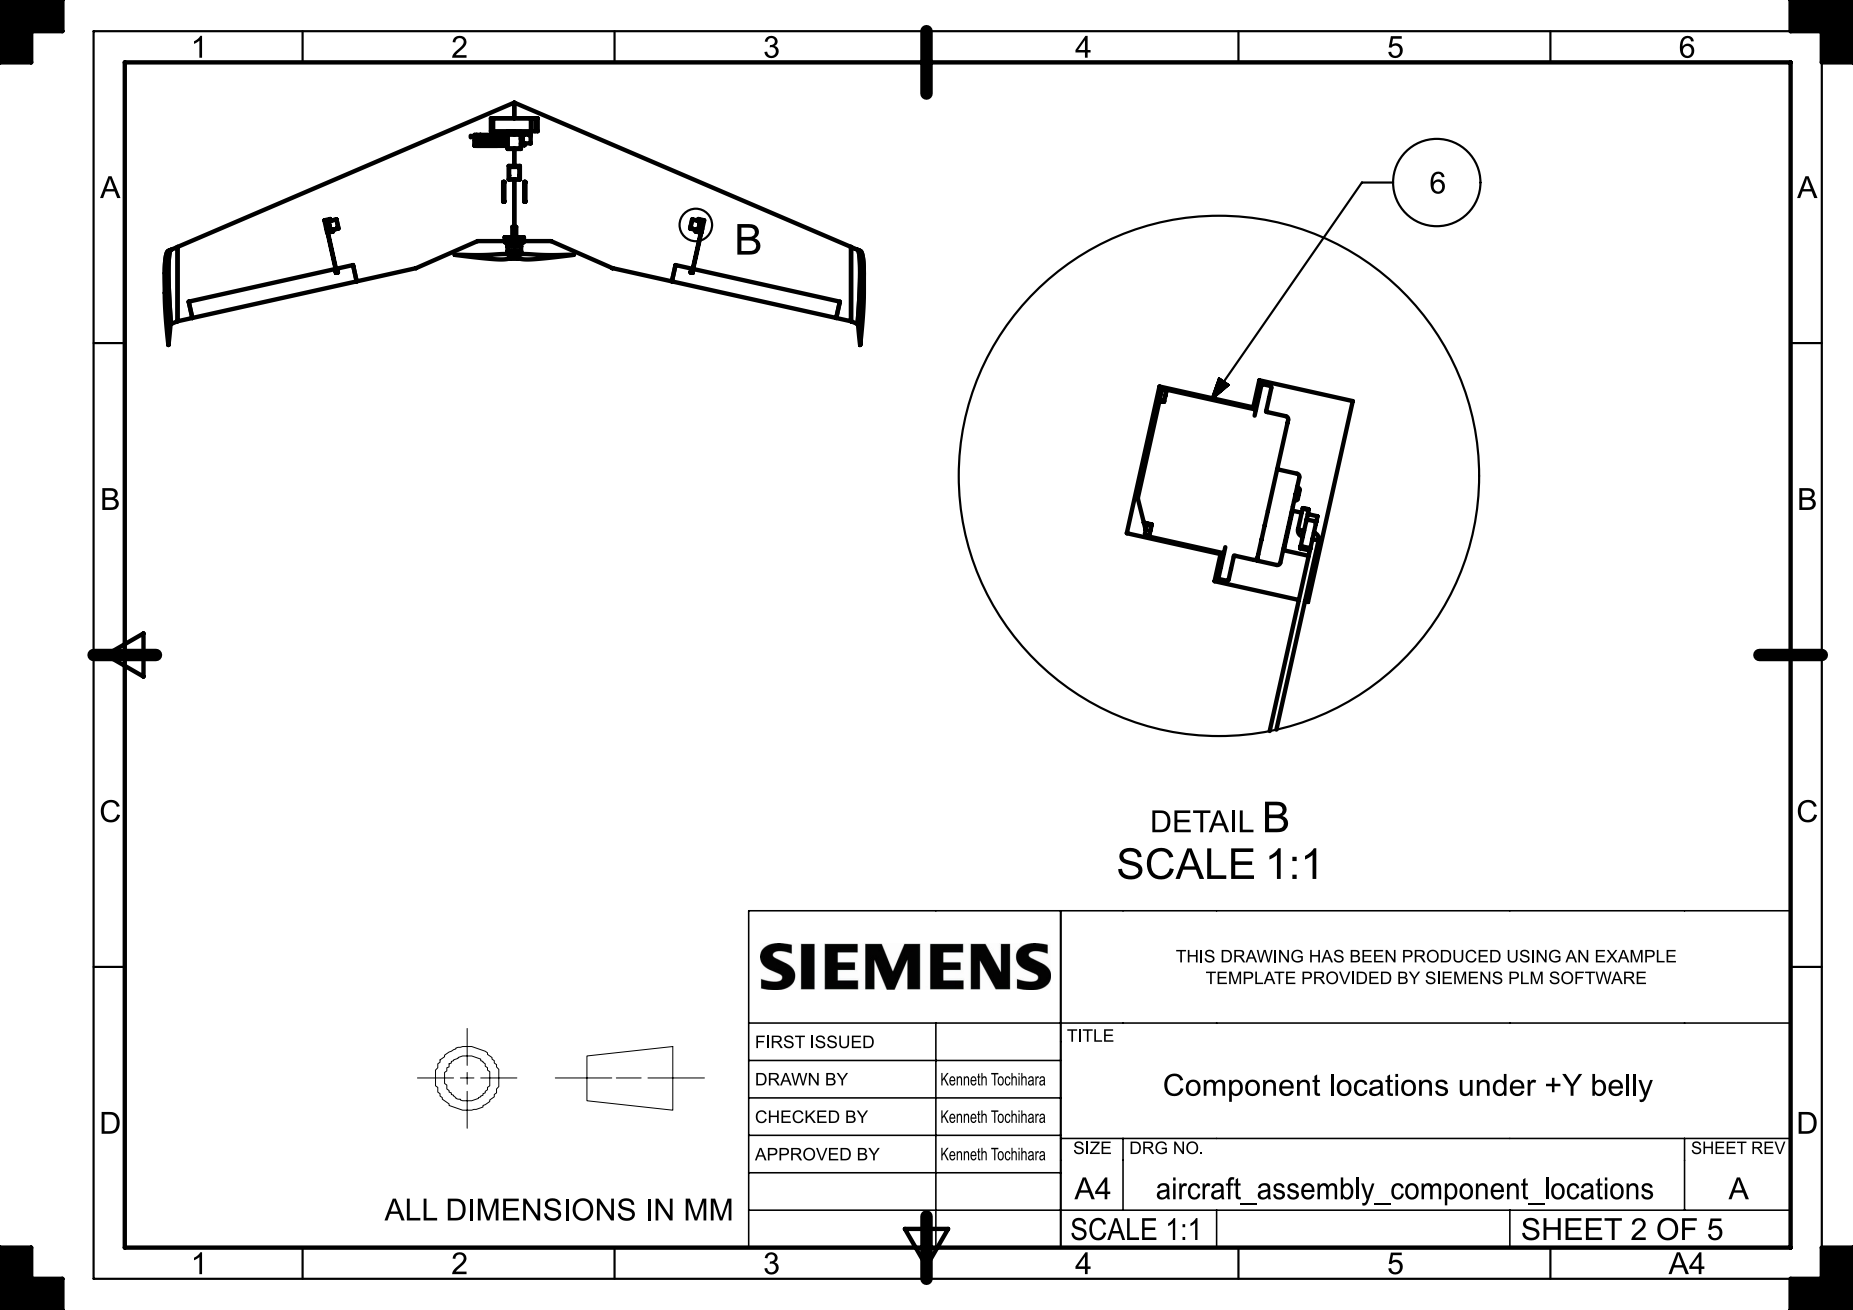
[picture p87: page 2]

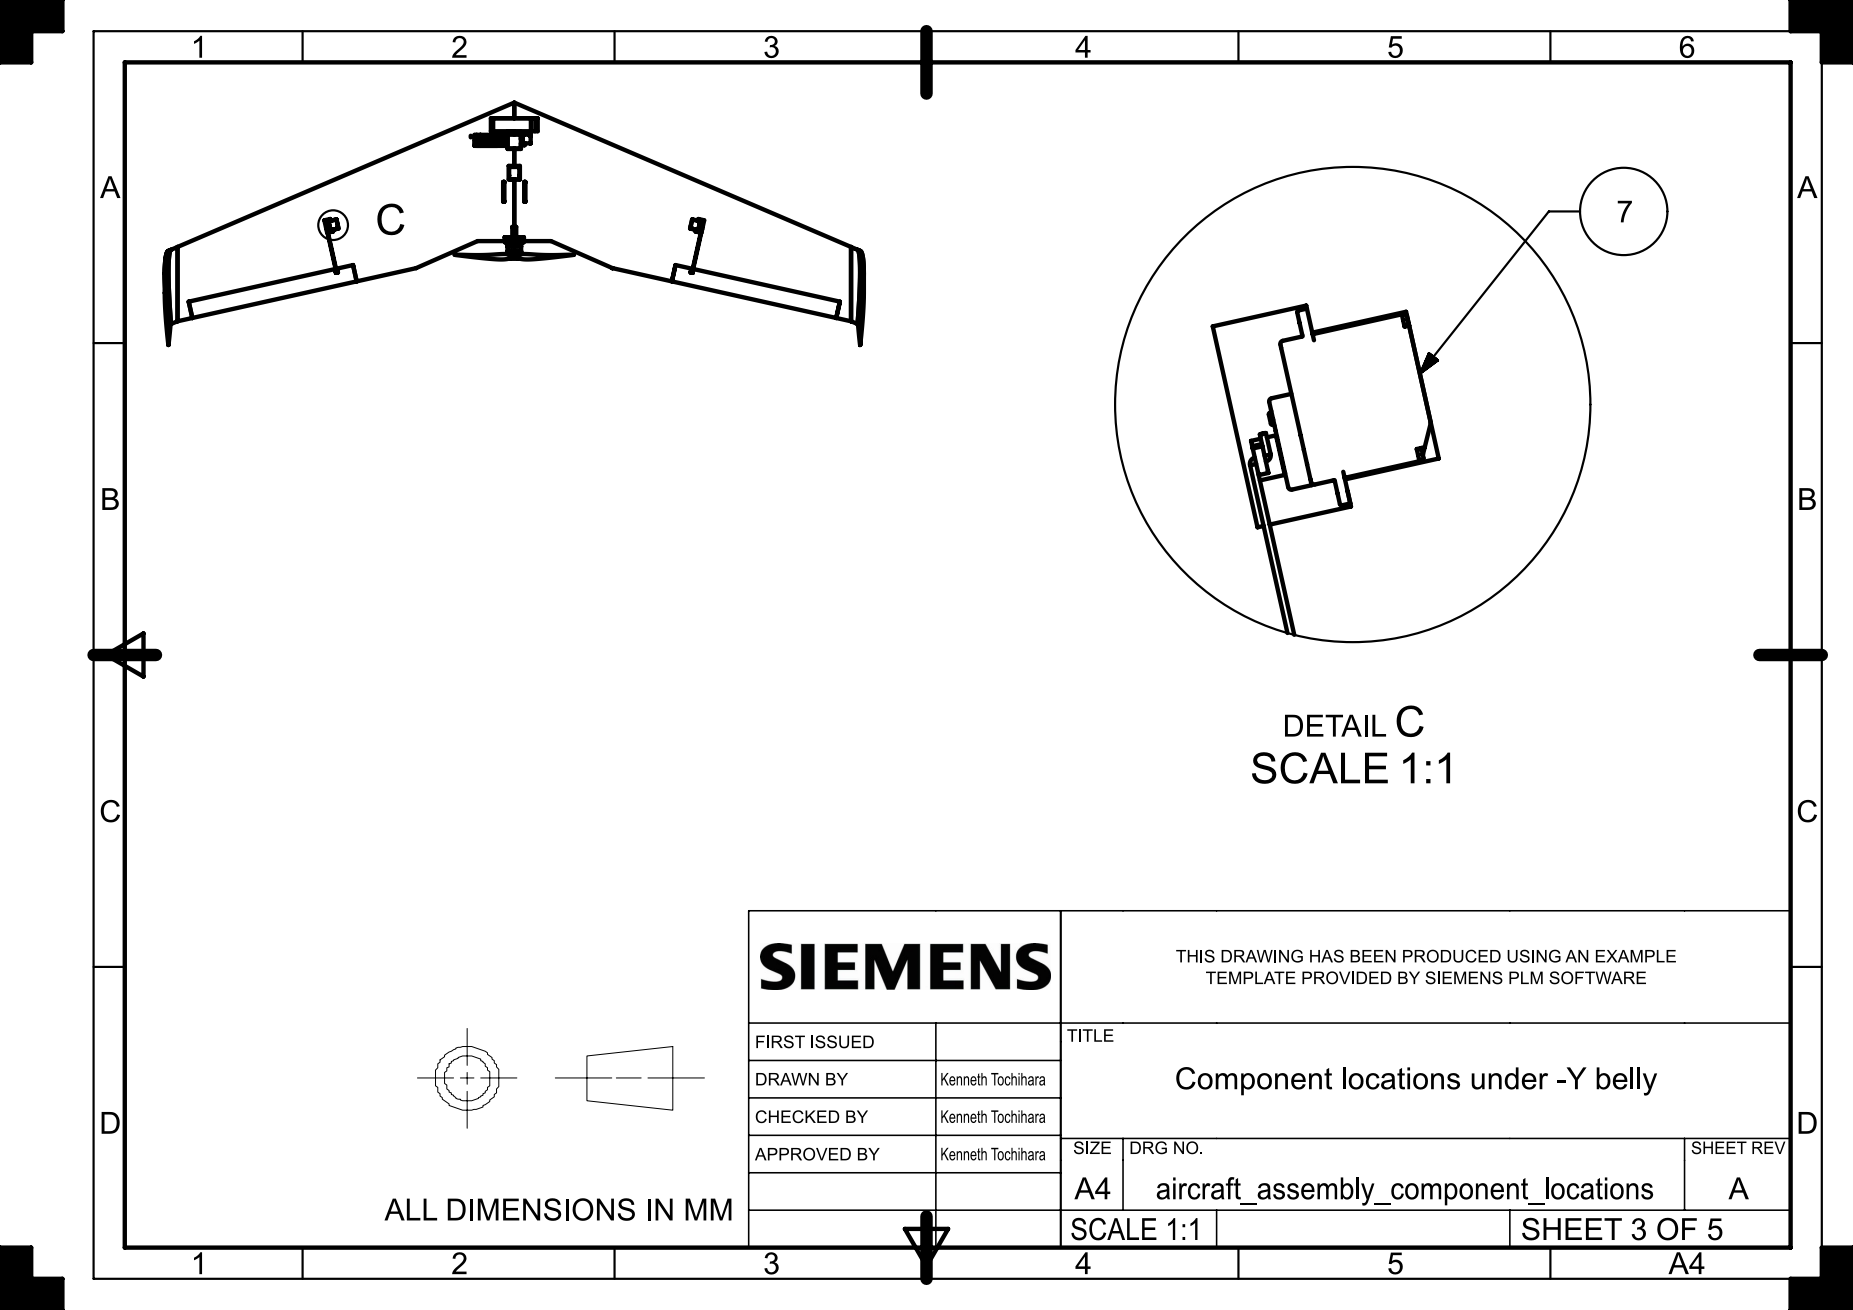
[picture p88: page 3]

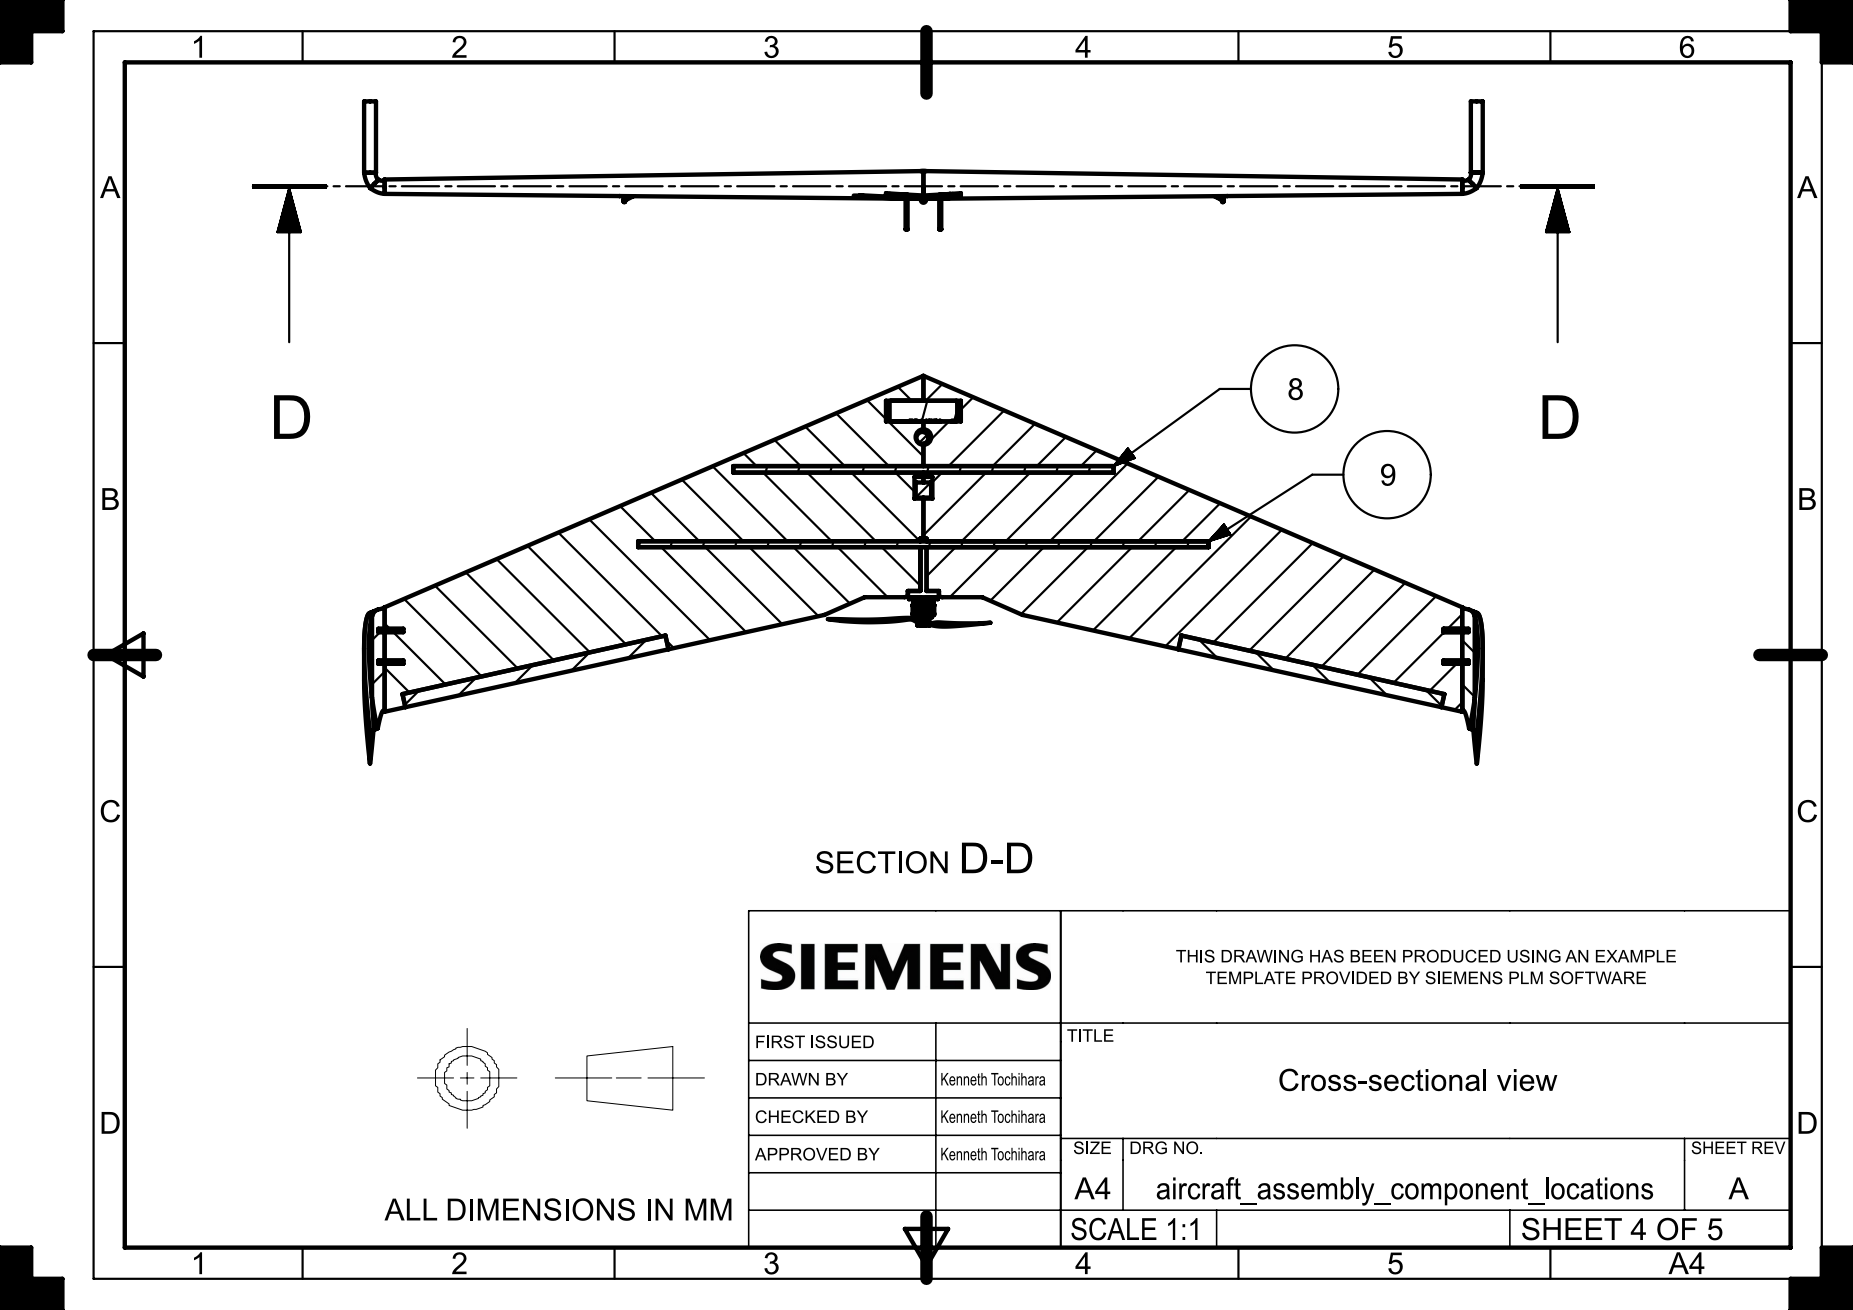
[picture p89: page 4]

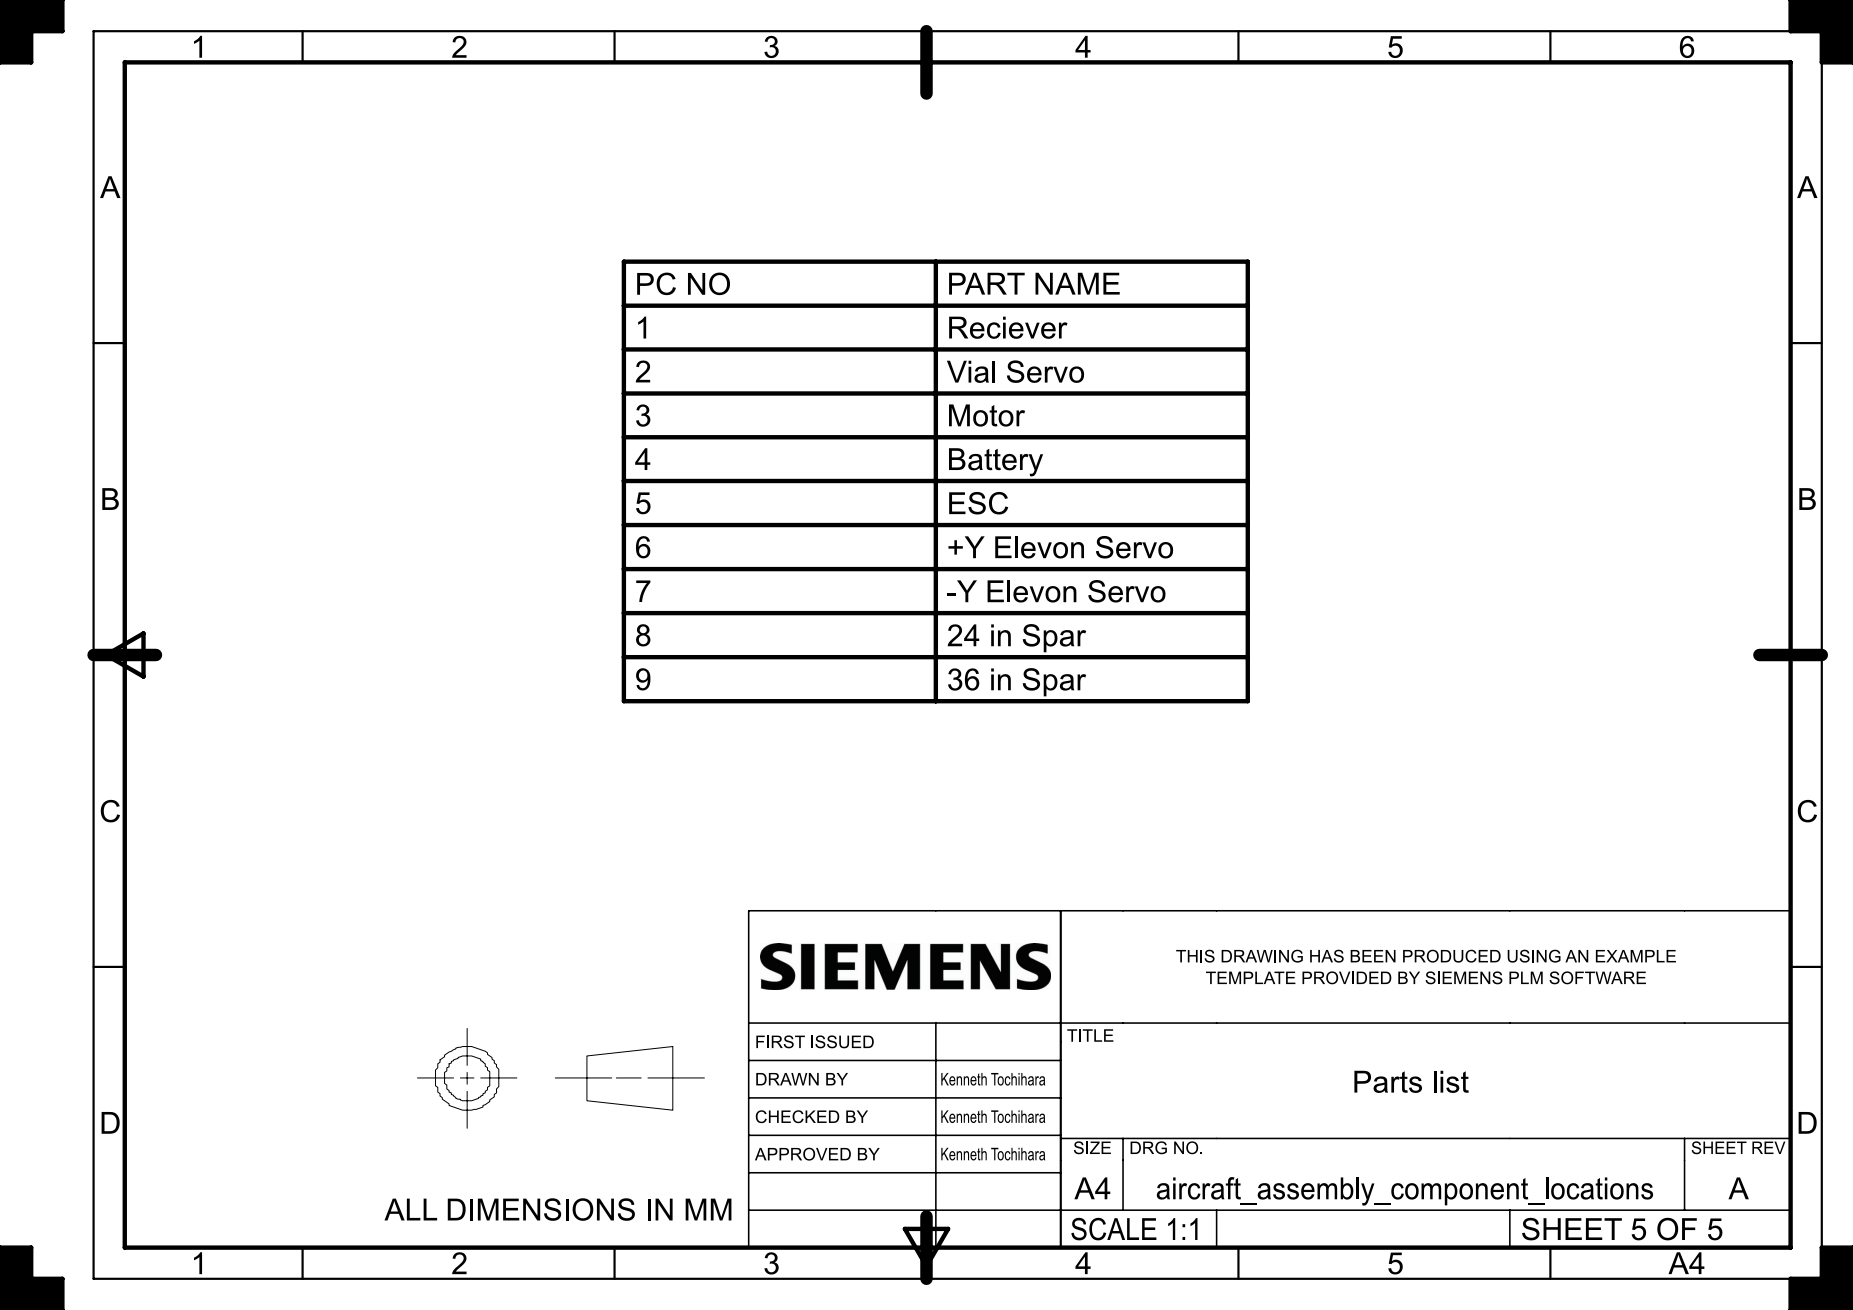
[picture p90: page 5]
