kenneth-tochihara/ae484/homeworks/homework4/report/Figure/gpetrov2_aircraft_assembly_exploded_drawing.pdf

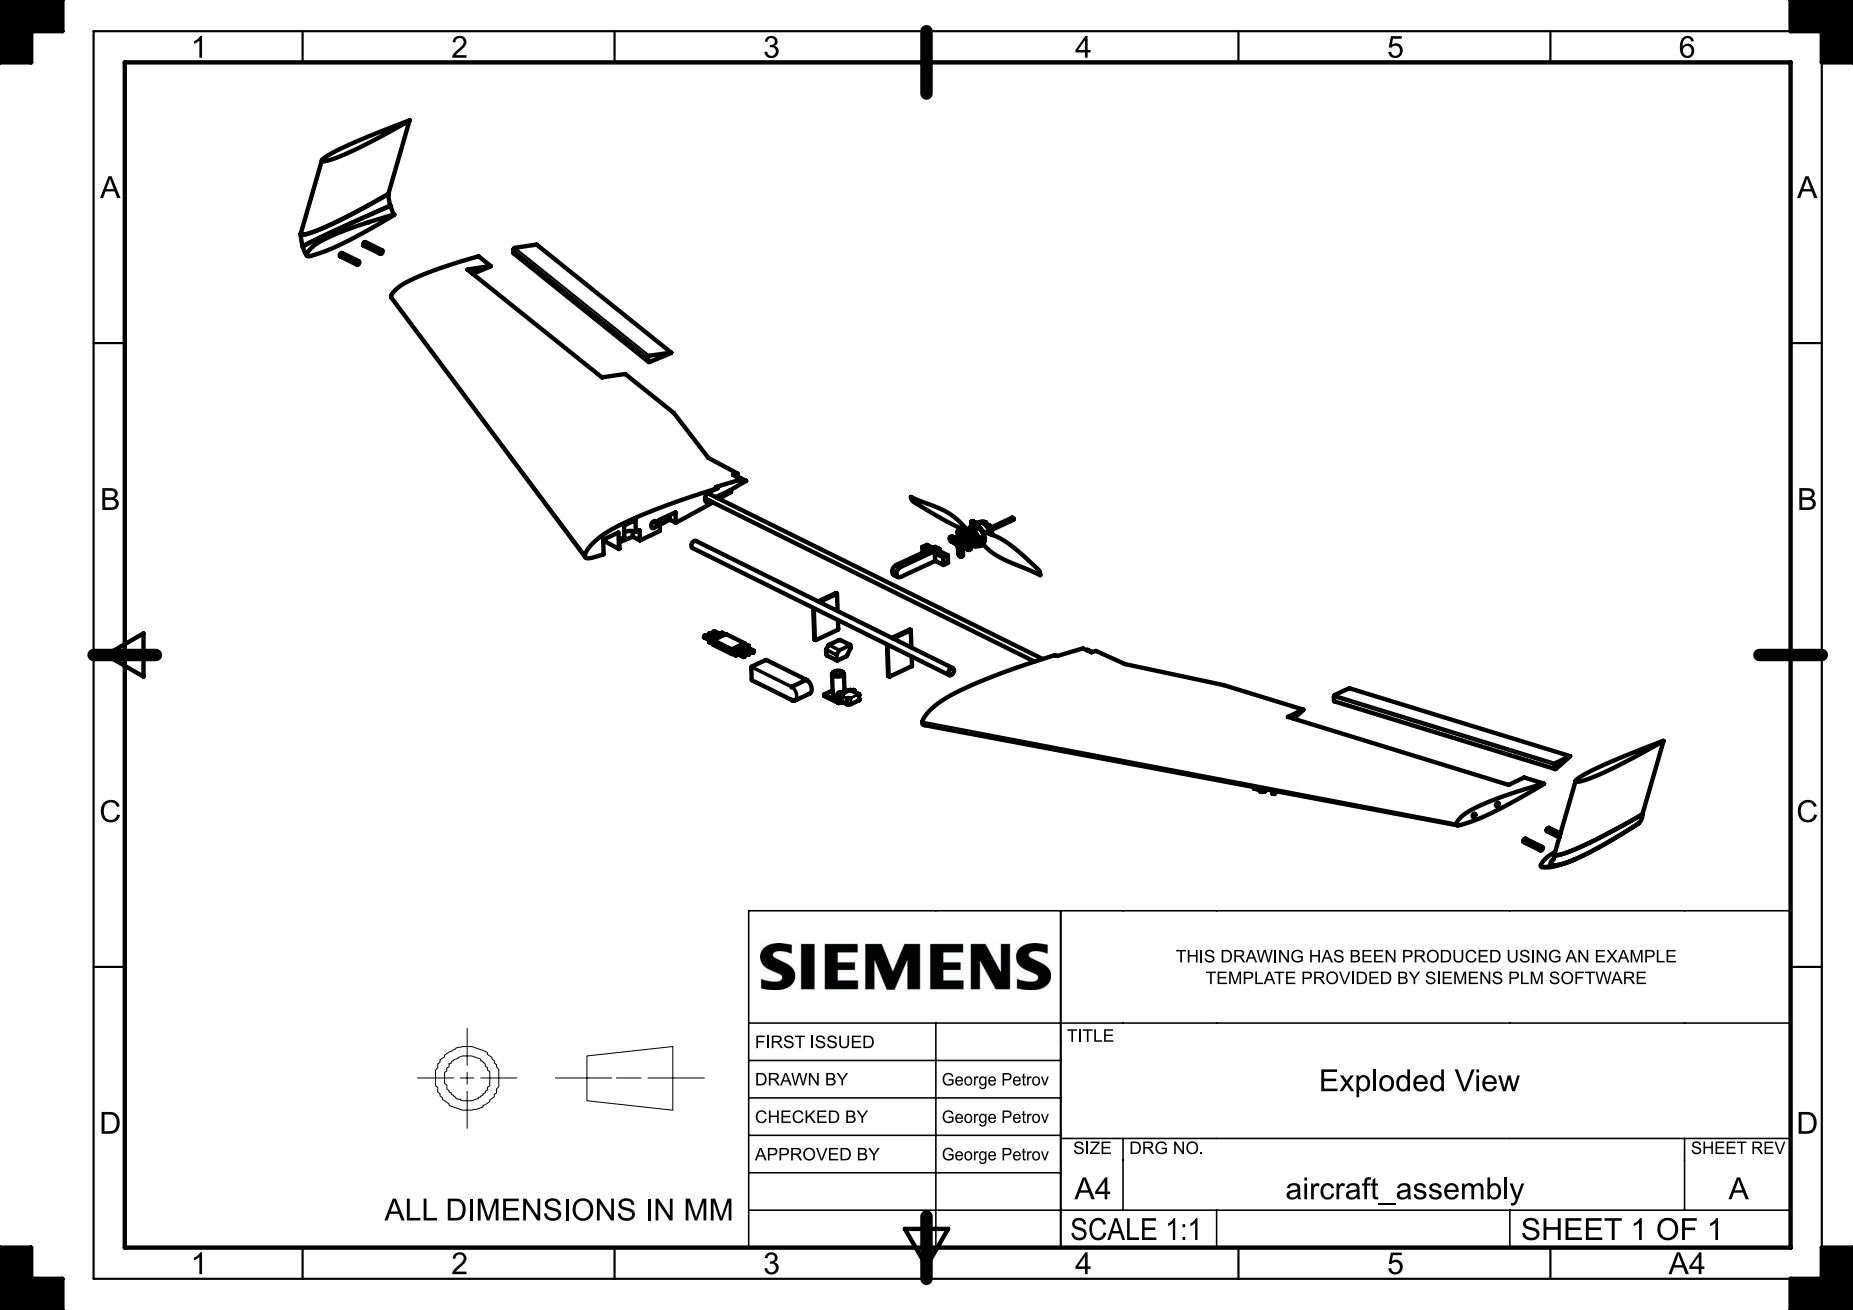
[picture p91: page 1]
