kenneth-tochihara/ae484/homeworks/homework2/george/Drawings/gpetrov2_vehicle_concept_george_assy.pdf

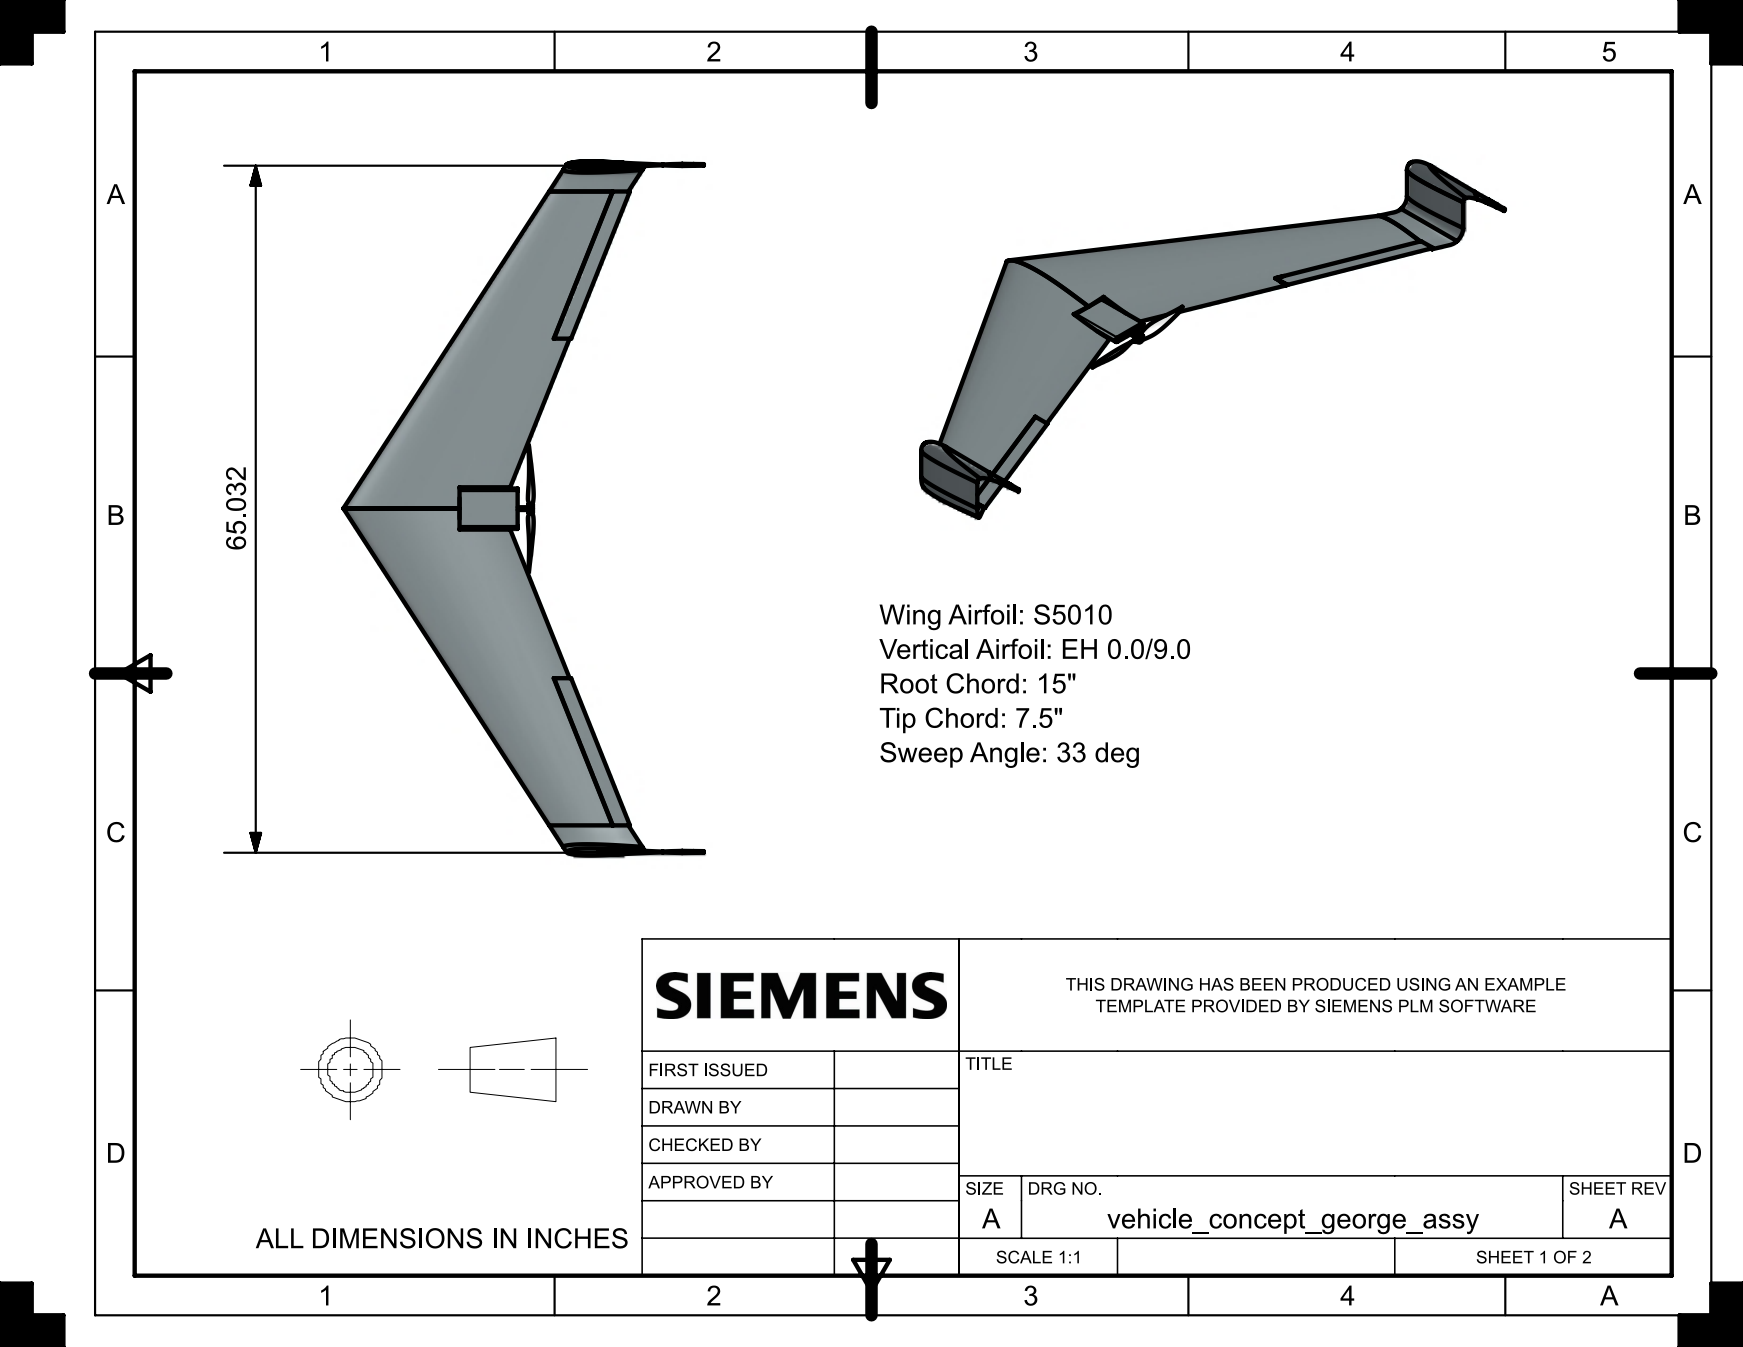
[picture p92: page 1]

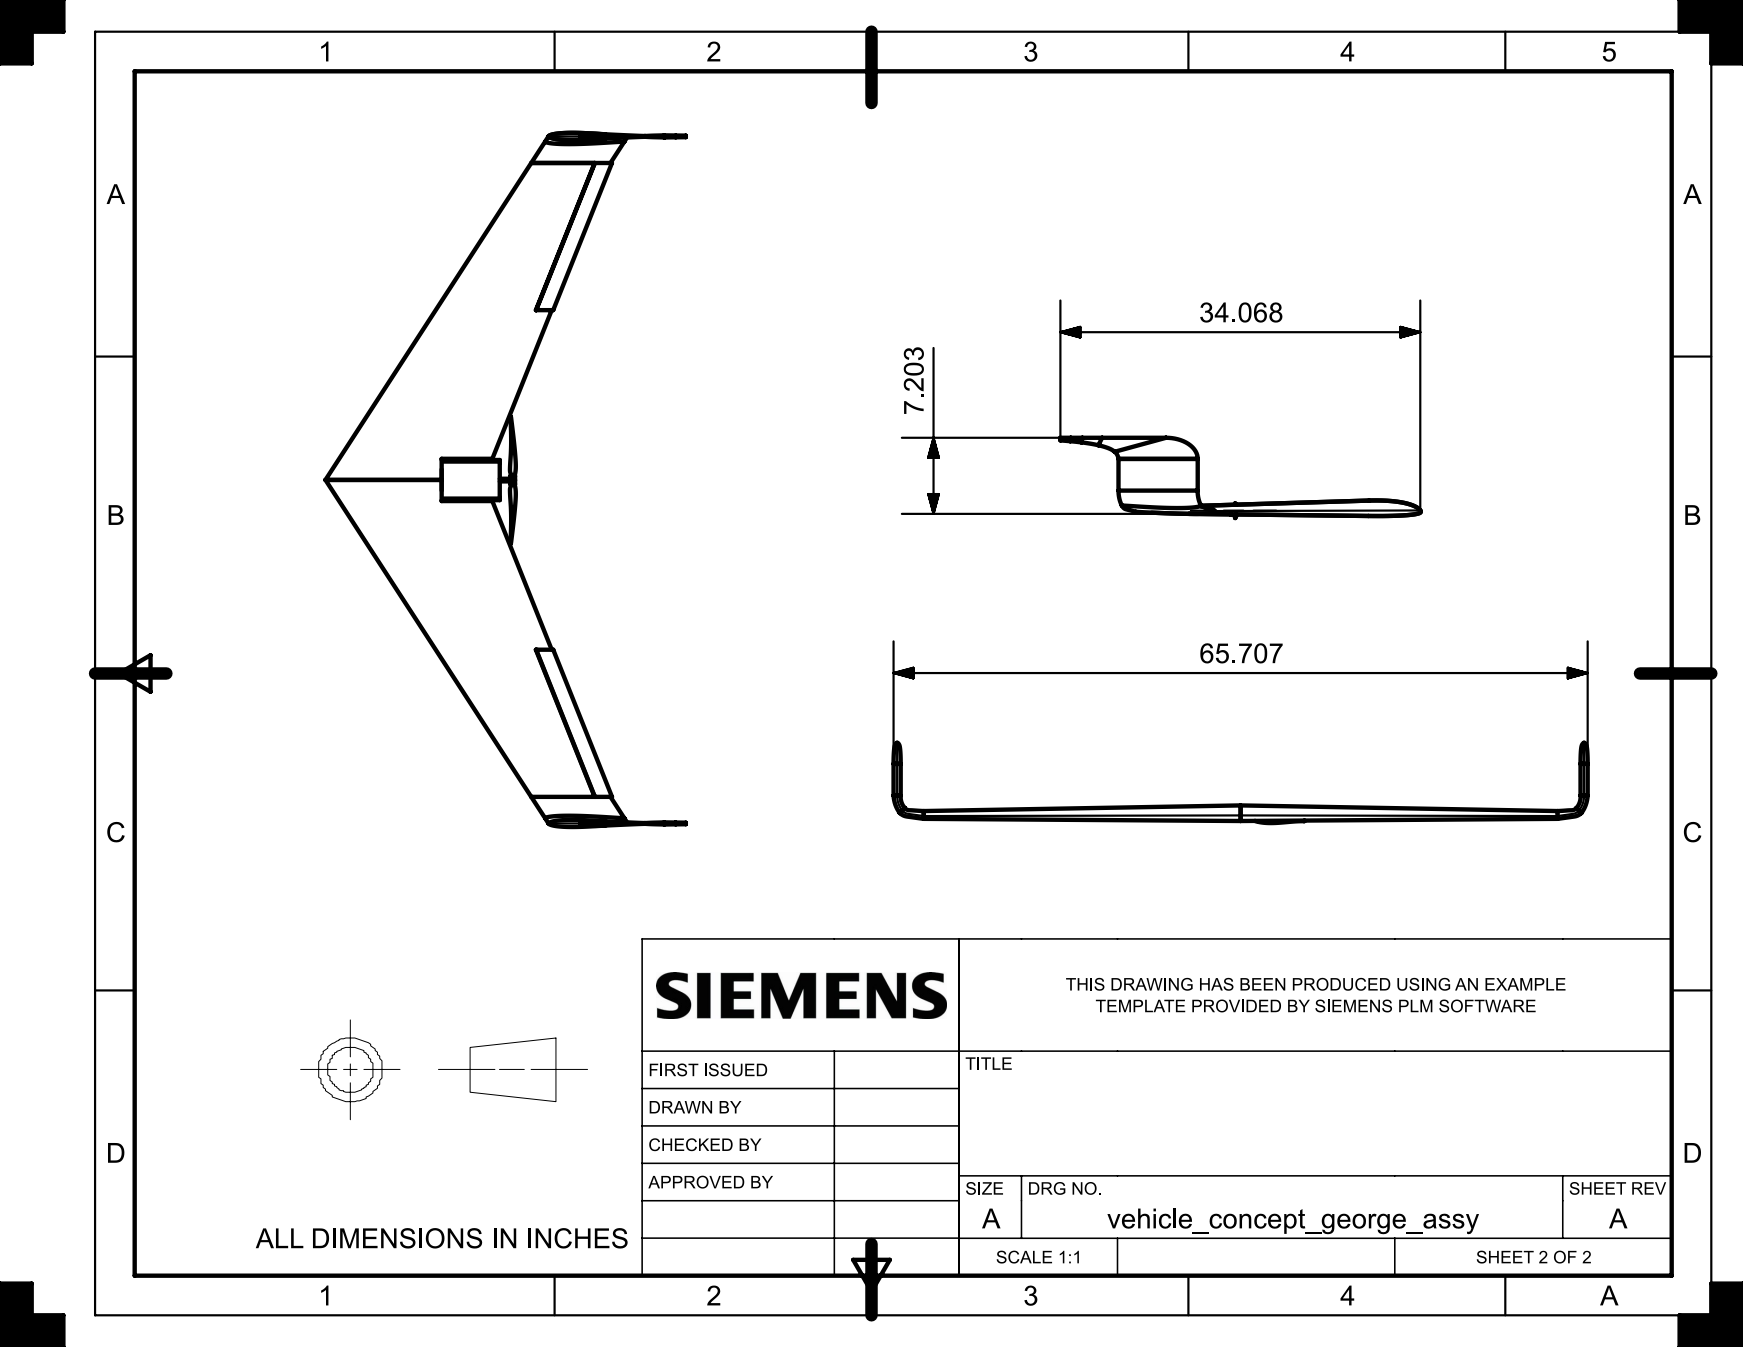
[picture p93: page 2]
