kenneth-tochihara/ae484/homeworks/homework2/anshuk/HW2_Drawing.pdf

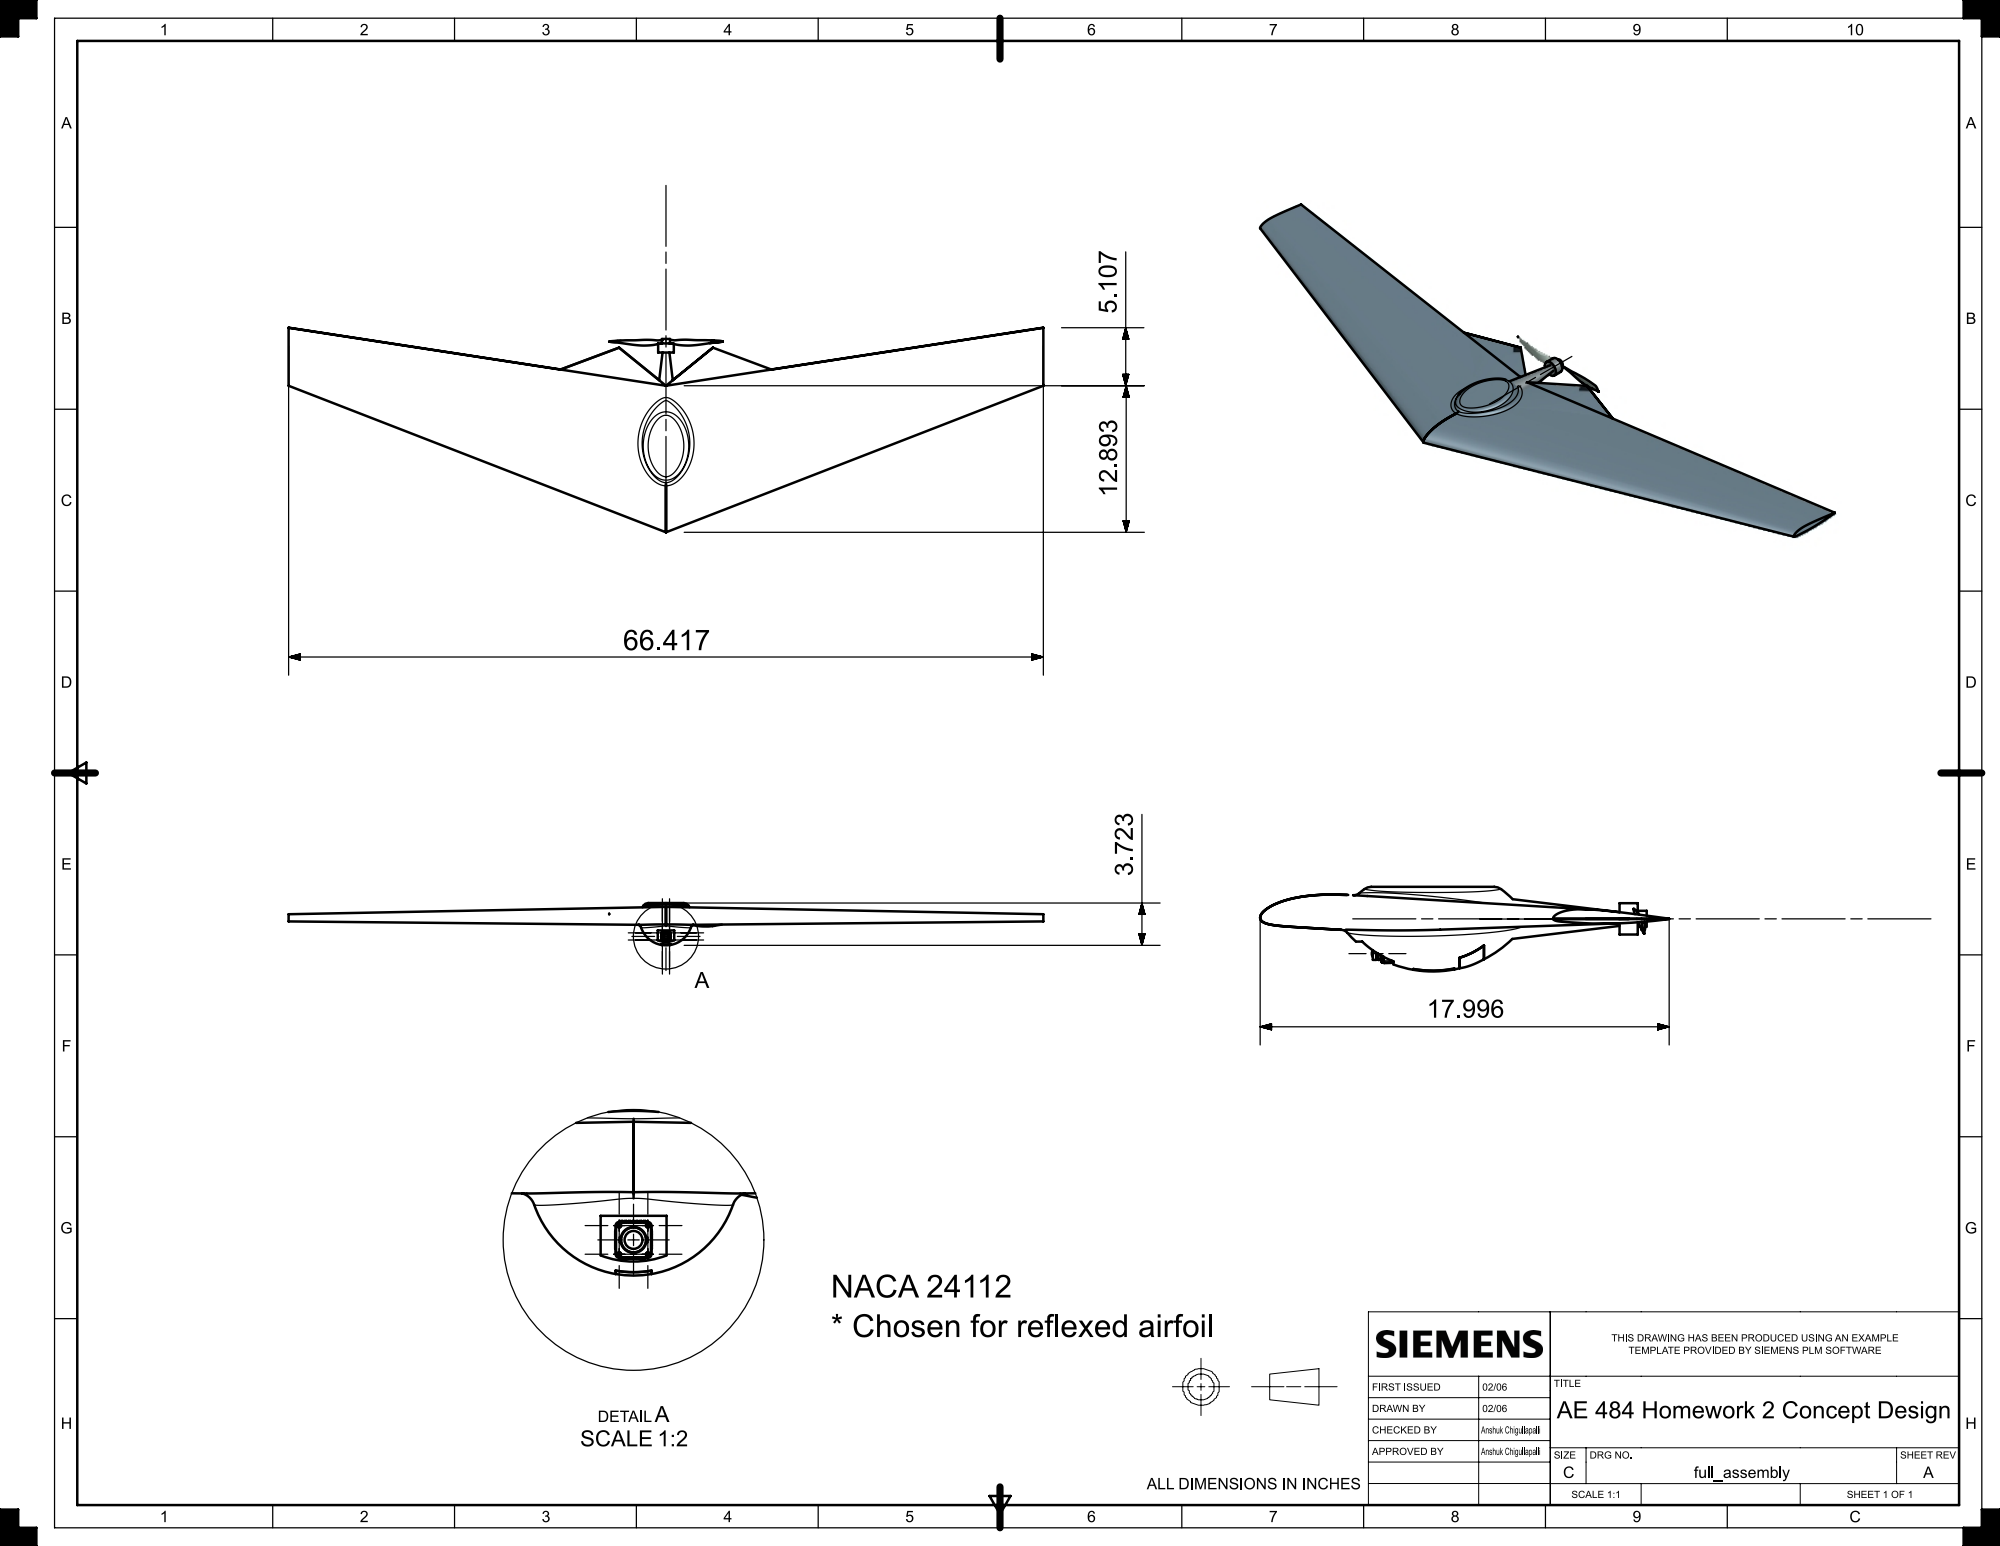
[picture p94: page 1]
