kenneth-tochihara/ae484/homeworks/homework2/kenneth/ktt3_aircraft.pdf

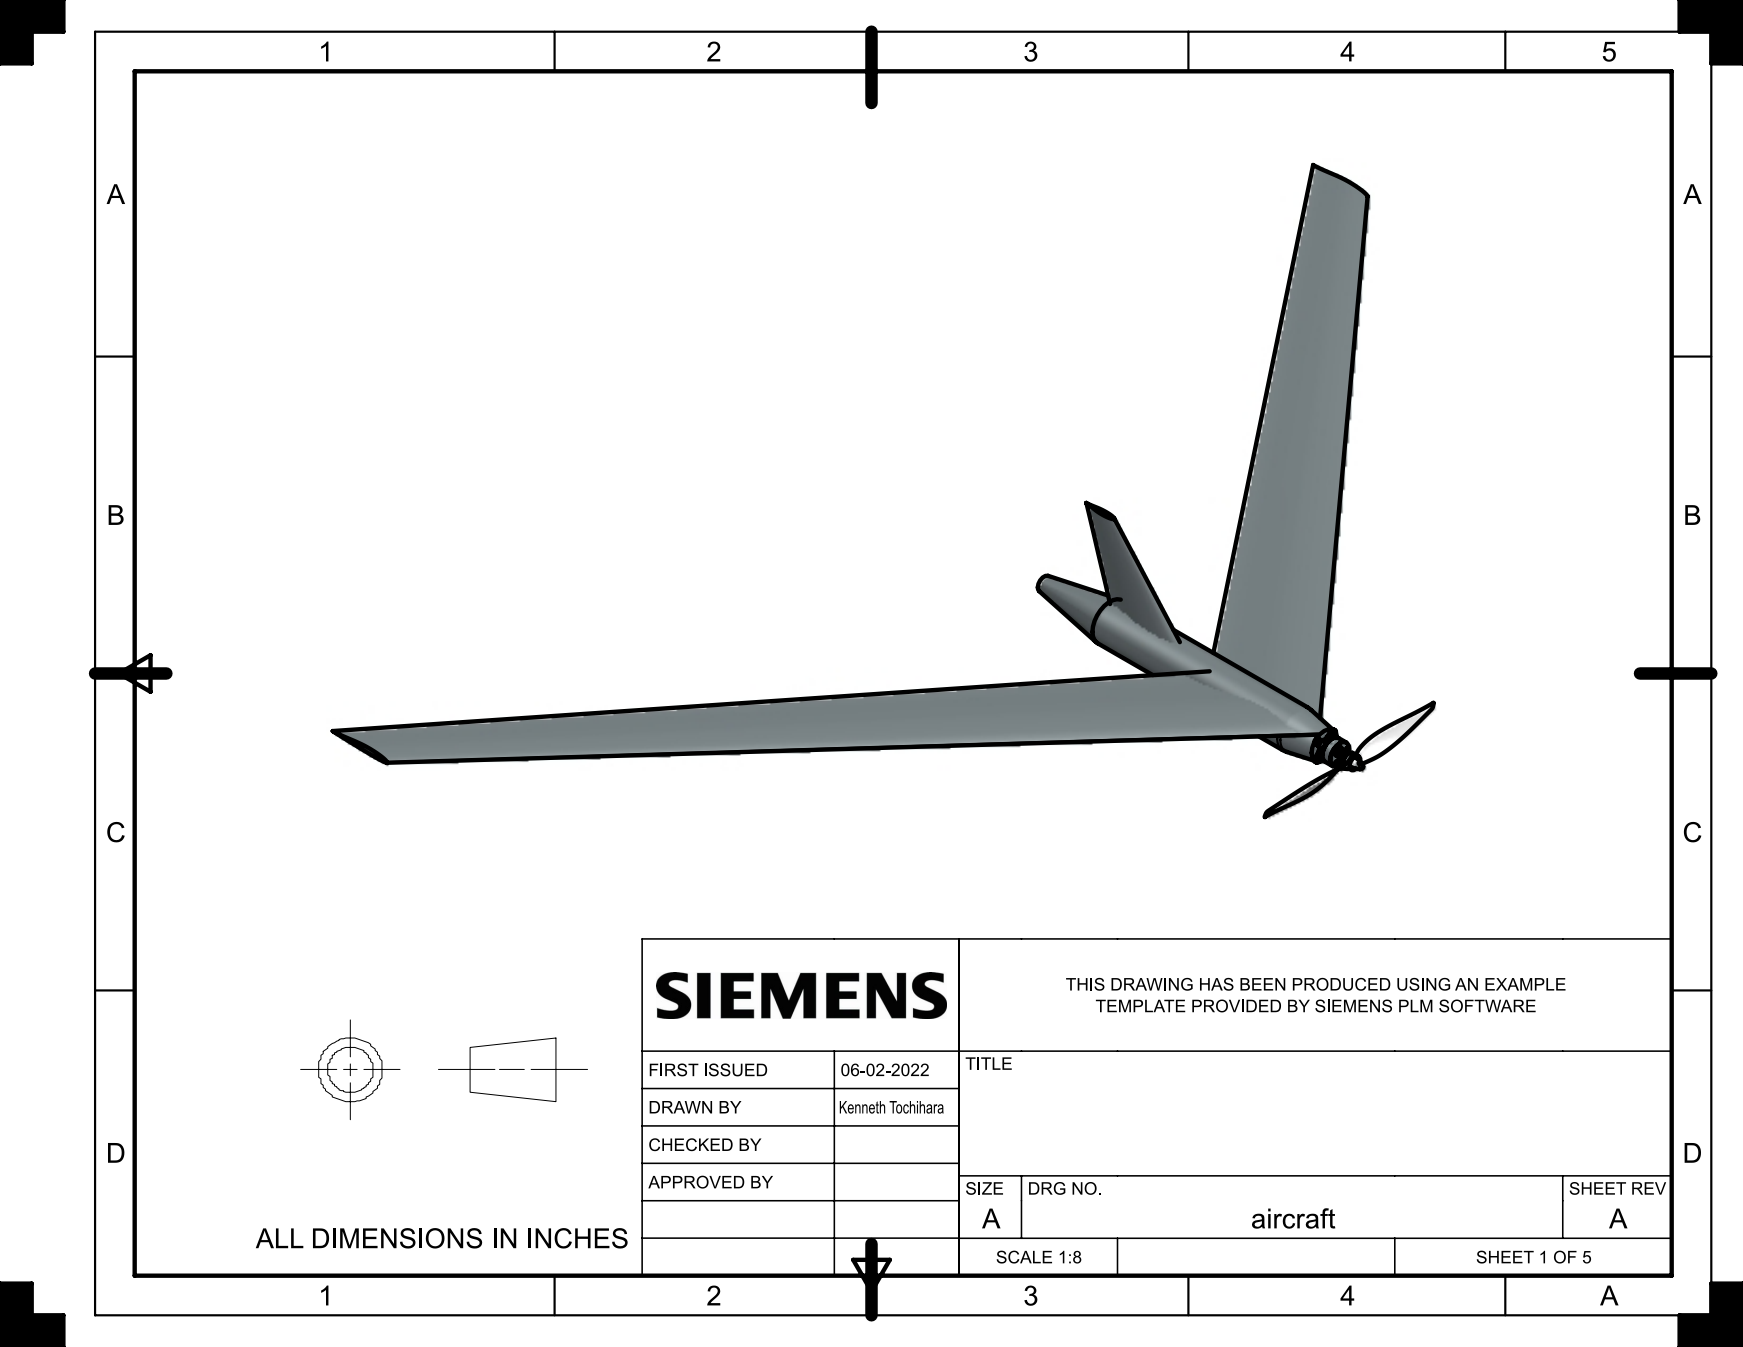
[picture p95: page 1]

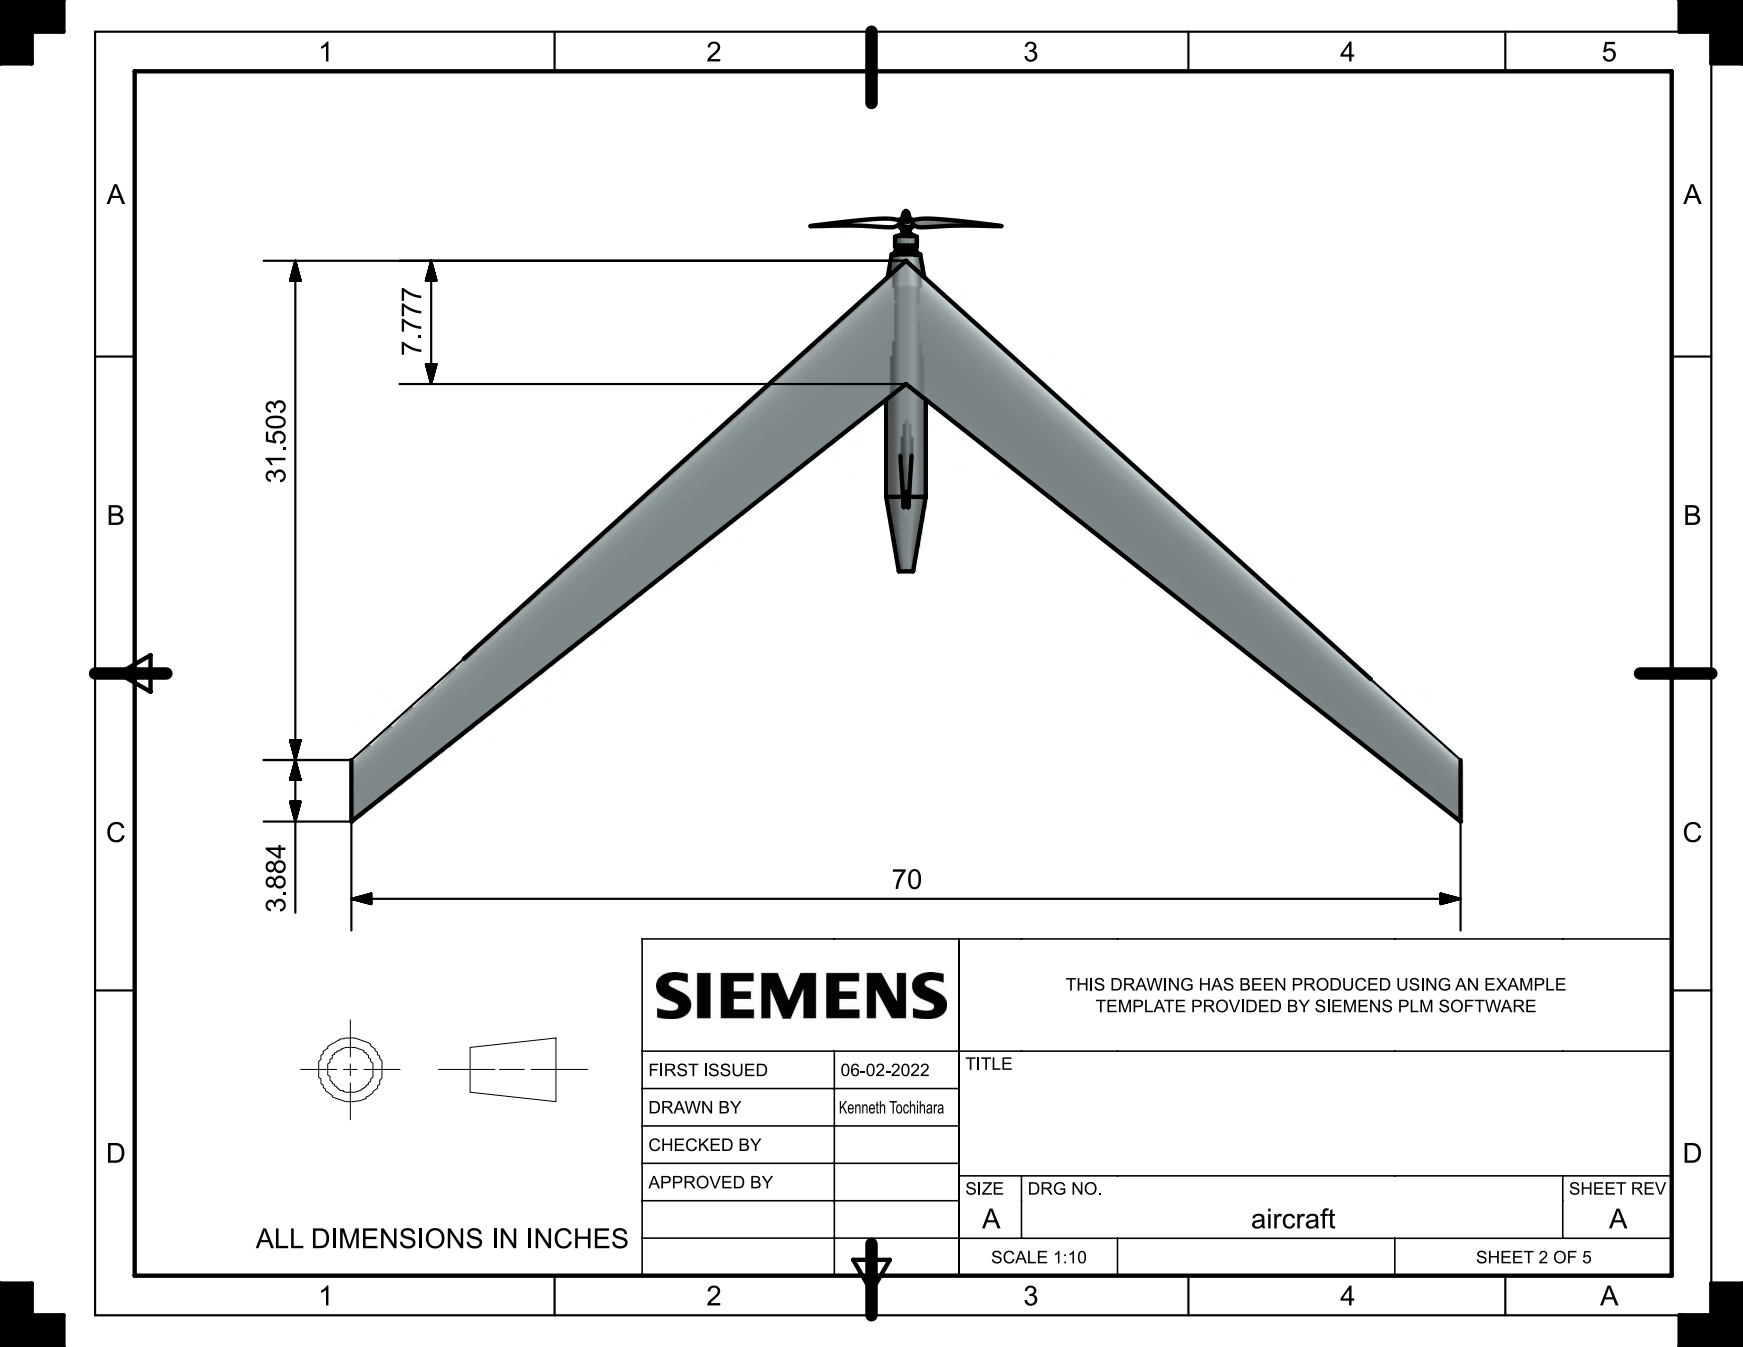
[picture p96: page 2]

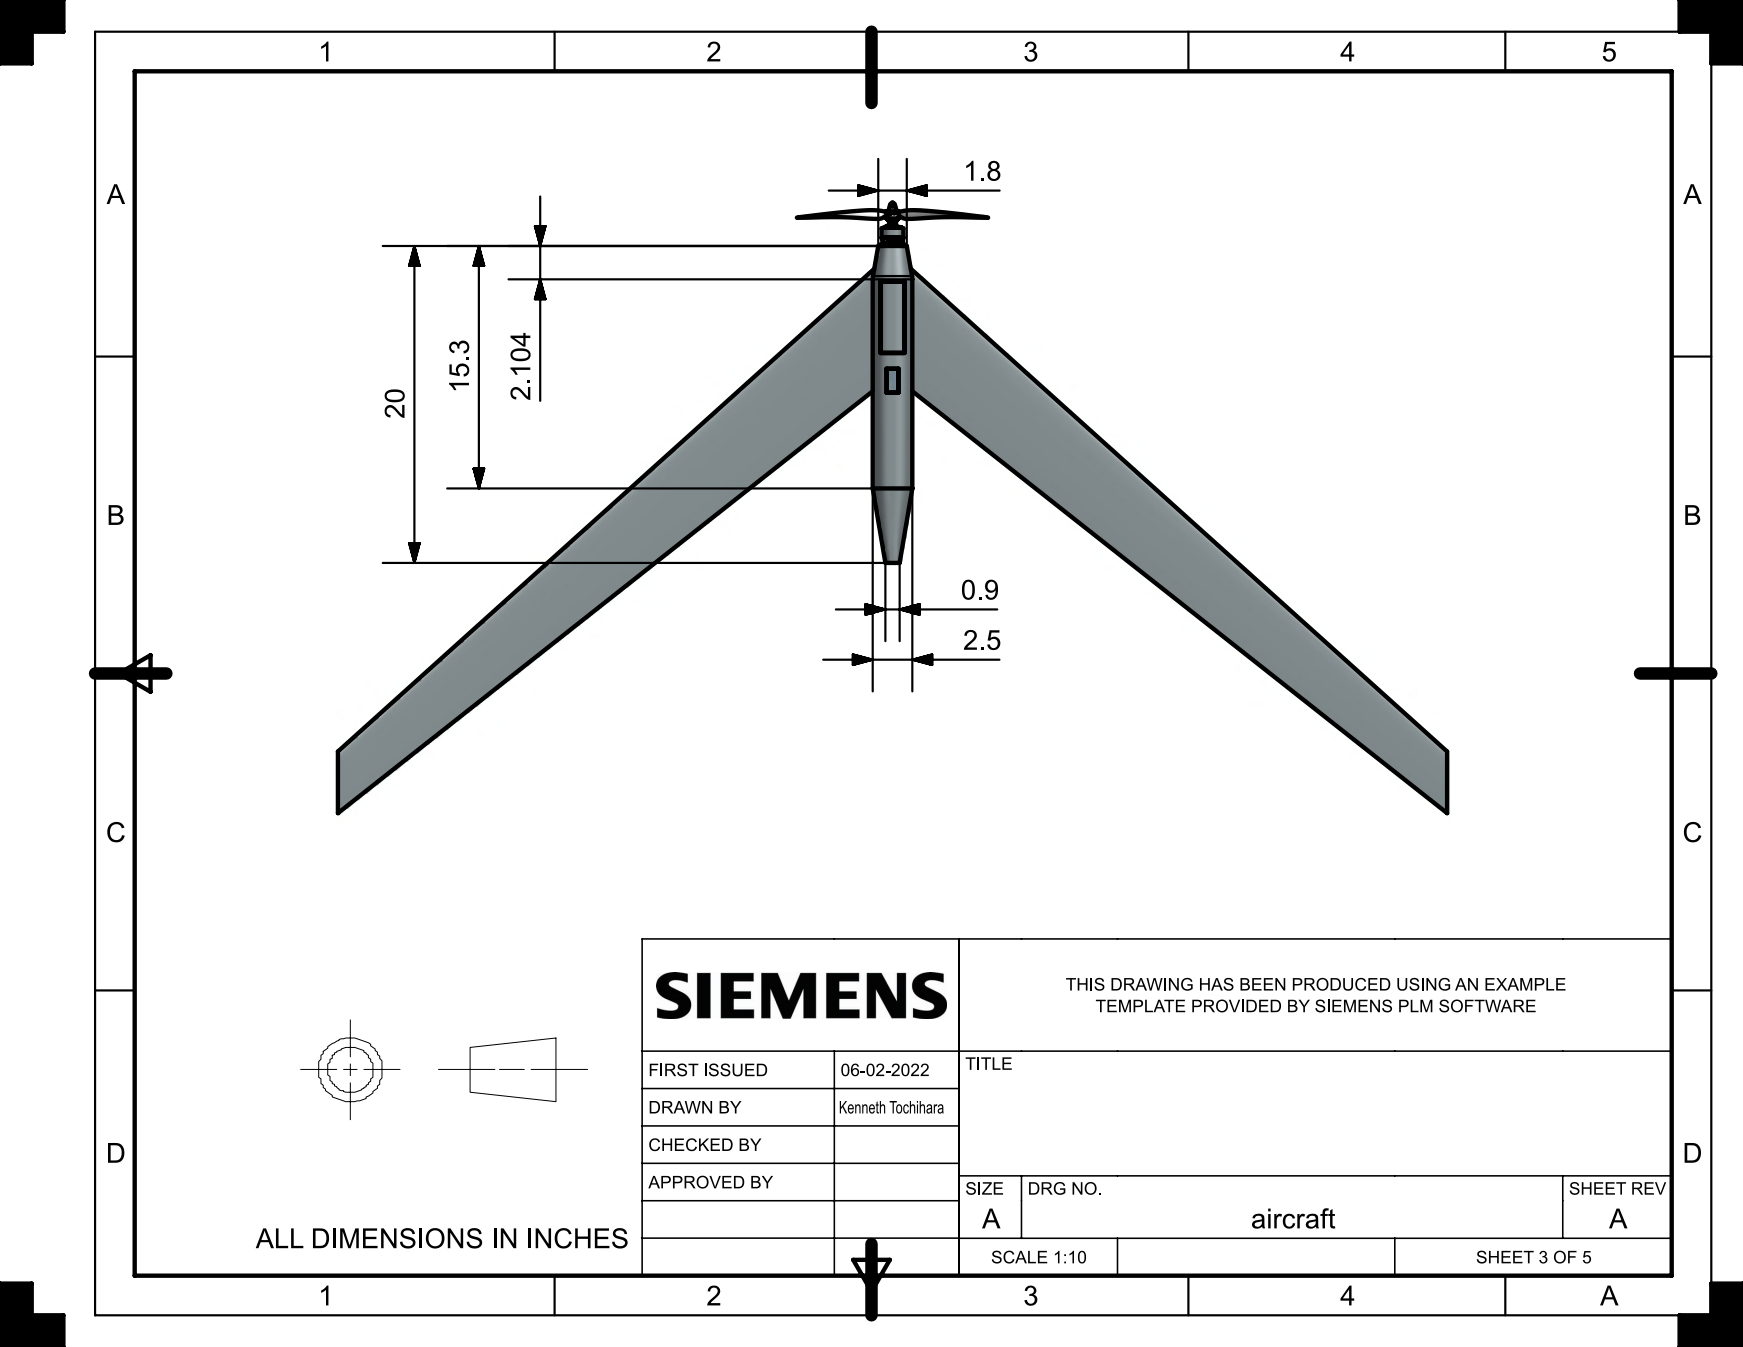
[picture p97: page 3]

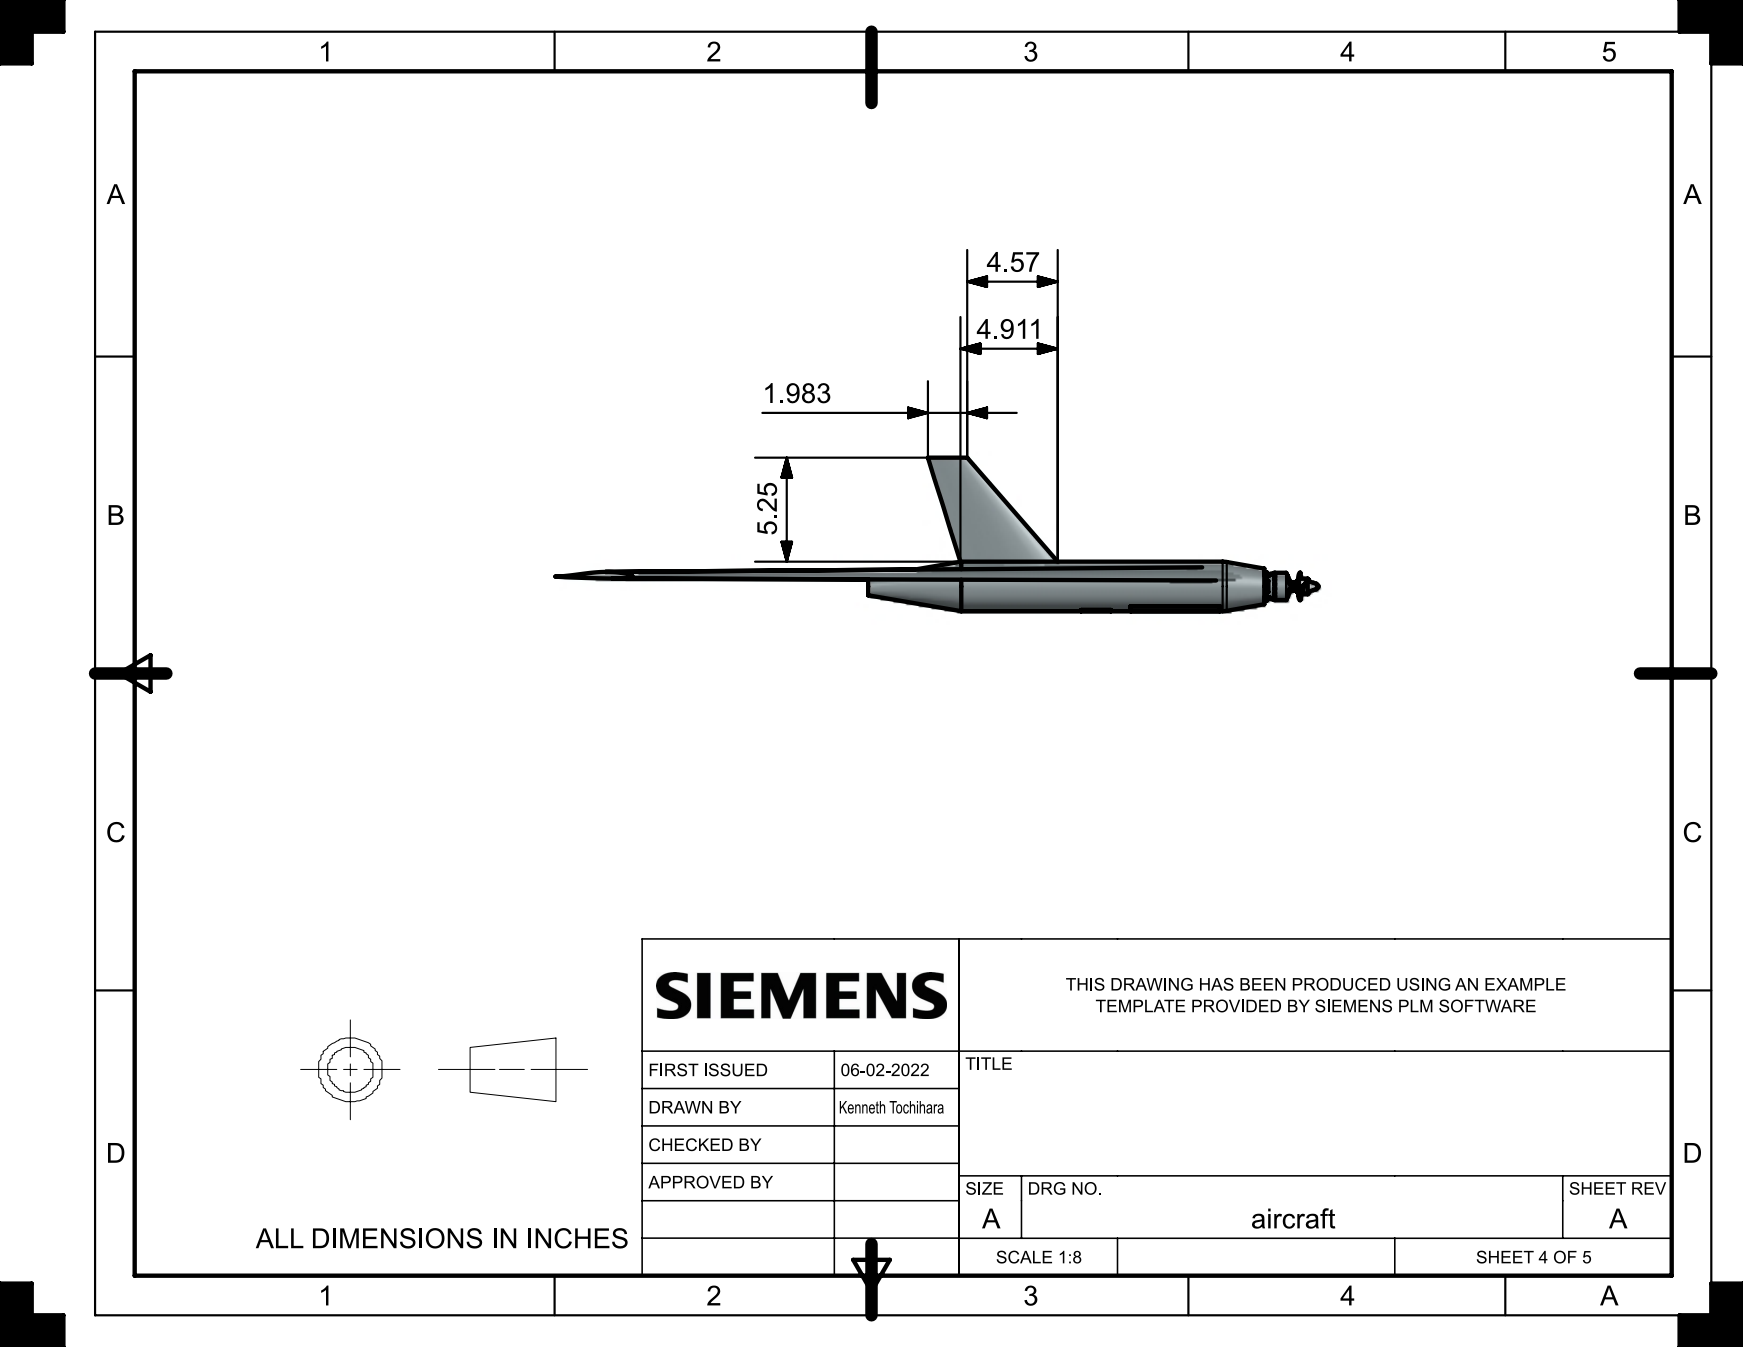
[picture p98: page 4]

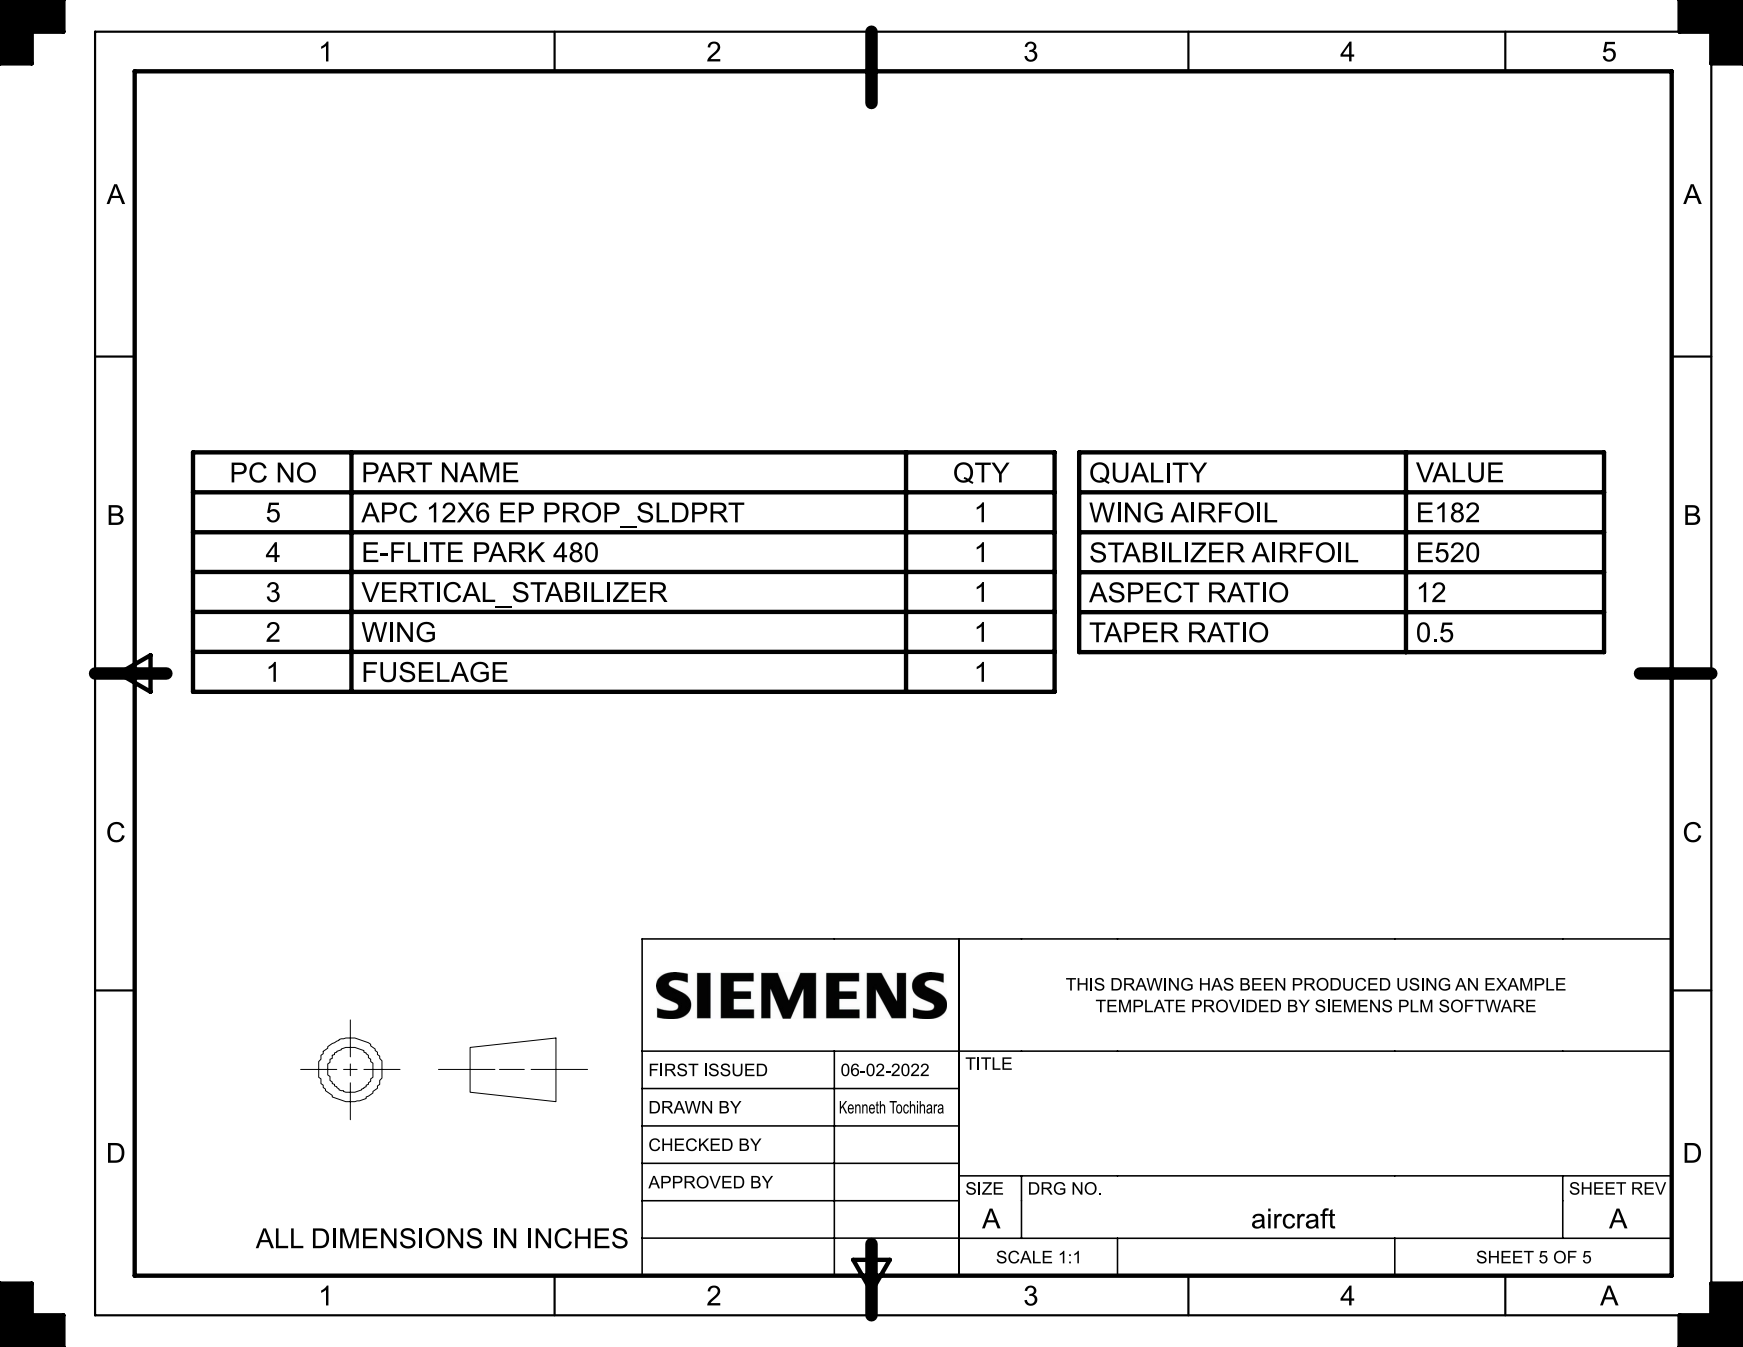
[picture p99: page 5]
