kenneth-tochihara/ae484/(commit log)

2022-02-04 added initial files
    [e182_wing_airfoil.xlsx, e520_vertical_stabilizer.xlsx, vertical_stabilizer.prt, wing.prt]
2022-02-05 model complete
    [4mm shaft spinner_id31_step.prt, APC 12x6 EP Prop.SLDPRT, APC 12x6 EP Prop_sldprt.prt, CirPattern2_sldprt.prt, Cut-Revolve1_sldprt.prt, E-Flite Park 480.prt, E-Flite Park 480_id91_step.prt, Park 480 Mount_id47_step.prt]
2022-02-06 george cad
    [propss.prt, vehicle_concept_george.prt, vehicle_concept_george_2.prt, vehicle_concept_george_assy.prt, vehicle_concept_george_controlsurfaces.prt, vehicle_concept_george_controlsurfaces2.prt, vehicle_concept_george_props.prt, vehicle_concept_george_wings.prt]
2022-02-07 added final draft
    [aircraft.prt]
2022-02-10 Added Anshuk's CAD
    [NACA24112.dat.xlsx, full_assembly.prt, main_body.prt, motor.prt, motor_assembly.prt, payload.prt]
2022-02-13 forgotten cad parts
    [CirPattern2_sldprt.prt, Cut-Revolve1_sldprt.prt, Surface-Fill3_sldprt.prt]
2022-02-14 added in jeffery's cad
    [hs522_airfoil.xlsx, prop.prt, wing_Jeffery.prt]
2022-02-14 Updates from Overleaf
    [hs522_airfoil.xlsx, prop.prt, wing_Jeffery.prt]
2022-02-14 removed Jeff folder
    [hs522_airfoil.xlsx, prop.prt, wing_Jeffery.prt]
2022-02-18 george hw3
    [NACA0012_1.csv, NACA0012_2_finite.csv, NACA0012_problem2_T1-38_0 m_s-Panel.csv, NACA0012_problem2_T1-38_0 m_s-Panel_2.csv, NACA0012_problem3_T1-38_0 m_s-Panel.csv, NACA4412_1.csv]
2022-02-18 problem3 hw3
    [NACA0012_3_finite.csv]
2022-02-19 finished with kenneth hw
    [T1-38_0 m_s-Panel.csv]
2022-02-26 Added servo, lipo battery and vial
    [Emax_Servo.prt, LiPo_battery.prt, payload_vial.prt]
2022-02-26 added motor and receiver
    [Bottom Shell.prt, Coil.prt, Inner Bearing.prt, Inner Coil Rack.prt, Middle Shell.prt, Park 480 Mount_id47_step.prt, Shaft.prt, Top Shell.prt]
2022-02-26 Added ESC
    [GForce_Brushless_ESC.prt]
2022-02-26 New better servo CAD
    [Emax ES08A_sldprt.prt, Emax_Servo.prt]
2022-02-26 added masses
    [Emax_Servo.prt, GForce_Brushless_ESC.prt, LiPo_battery.prt, payload_vial.prt]
2022-02-26 Deleting old servo
    [Emax_Servo.prt]
2022-02-26 added mass to servo
    [Emax ES08A_sldprt.prt]
2022-02-27 wing cad
    [main_wing.prt, main_wing_+z.prt, main_wing_-z.prt, wing.prt, winglets_+z.prt, winglets_-z.prt]
2022-02-27 assembly cad
    [aircraft_assembly.prt]
2022-03-02 added elevon actuators
    [Connector_short.SLDPRT, Connector_short_sldprt.prt, Emax ES08A_sldprt.prt, elevon_bar.prt, elevon_left.prt, elevon_refernce.prt, elevon_right.prt]
2022-03-02 Added trap door
    [assembly_vial_door.prt, trap_door.prt]
2022-03-02 assembly + wing
    [Turnigy Motor_step.prt, aircraft_assembly.prt, elevon_+z.prt, elevon_-z.prt, elevon_left.prt, main_wing.prt, main_wing_+z.prt, main_wing_-z.prt]
2022-03-02 motor connect
    [aircraft_assembly.prt, main_wing.prt, main_wing_+z.prt, main_wing_-z.prt, spar_motor_connecter.prt, wing.prt]
2022-03-03 please cry
    [CirPattern2_sldprt.prt, Cut-Revolve1_sldprt.prt, Turnigy Motor_step.prt, aircraft_assembly.prt, elecon_holder_left.prt, elevon_+z.prt, elevon_-z.prt, elevon_bar.prt]
2022-03-04 cad final
    [hand_holders.prt, main_wing.prt, winglet_dowel.prt]
2022-03-05 Added vial mechanism figures
    [aircraft_assembly.prt, assembly_vial_door.prt, elevon_+z.prt, wing.prt]
2022-03-07 door cutout update
    [aircraft_assembly.prt, assembly_vial_door.prt, main_wing.prt, main_wing_+z.prt, main_wing_-z.prt, wing.prt]
2022-03-07 prop part missing
    [Surface-Fill3_sldprt.prt, aircraft_assembly.prt]
2022-03-07 exploded pdf
    [aircraft_assembly.prt]
2022-03-07 added components labelling
    [aircraft_assembly_component_locations.prt]
2022-03-07 Doing engineering drawings for all fabricated components
    [aircraft_assembly.prt, elevon_holder_left.prt, trap_door.prt, wing.prt]
2022-03-07 Aircraft overall drawing
    [aircraft_assembly.prt]
2022-03-07 Added isometric drawing:
    [aircraft_assembly.prt, assembly_vial_door.prt]
2022-04-05 T motor mount ipt
    [Motor Mount V2.ipt]
2022-04-05 stl files
    [Elevon Mount.stl, Motor Mount V2.stl, Trap Door .stl]
2022-04-05 added new cad for hw6
    [Bottom Shell.prt, CirPattern2_sldprt.prt, Coil.prt, Connector_short.SLDPRT, Connector_short_sldprt.prt, Cut-Revolve1_sldprt.prt, Emax ES08A_sldprt.prt, GForce_Brushless_ESC.prt]
2022-04-05 added motor spar connector updated
    [spar_motor_connecter.prt]
2022-04-05 final cad updates
    [aircraft_assembly.prt, main_wing.prt, main_wing_+z.prt, main_wing_-z.prt, wing.prt]
2022-04-05 new motor mount drawing
2022-04-05 Working on engineering drawings
    [wing.prt]
2022-04-05 added drawings and renamed file driectories
    [Elevon Mount.stl, Motor Mount V2.ipt, Motor Mount V2.stl, Trap Door .stl, aircraft_assembly_component_locations.prt, aircraft_assembly_manufacturing.prt, flat_winglets_+z_.prt, holder_mid_.prt]
2022-04-05 final motor mount stl
    [motor_mount.stl]
2022-04-05 wing stl files
    [main_wing_+z_stl.stl, main_wing_-z_stl.stl]
2022-04-05 added STL files
    [flat_winglets_+z_.prt, holder_mid_.prt, main_wing_+z.stl, main_wing_-z.stl]
2022-04-05 Fixed assembly drawings
2022-04-05 Renamed manufacturing part names
    [Motor Mount V2.stl, elevon_mount.stl, trap_door.stl]
2022-04-05 Forgot last save in prt
    [aircraft_assembly.prt]
2022-04-05 Added wing drawings
    [main_wing_+z.prt, main_wing_-z.prt]
2022-05-03 added stuff
    [main_wing_-z.prt]
2022-05-03 Winglet STLs
    [aircraft_assembly.prt, flat_winglets_+z_.stl, flat_winglets_-z.stl]
